liebe1127/HP028_RailTwin/ECAD/README.md

# compact-sensor-module
- First pcb attempt : used [KiCAD](https://www.kicad.org/) 10.0.6
- Based on first prototype sensor module : not extensible. Left gpio pins didn't have interface.
- Already ordered 5 pics on [JLCPCB](https://jlcpcb.com/) (minimum oroder quantity) : **not PCBA**, need soldering by hand after shipping.
- Latest gerber in /output3 folder.
- 3d models, symbols, footprints for certain parts comes from [SnapMagic](https://www.snapeda.com/home/).
