liebe1127/HP028_RailTwin/docs/hardware-digital-twin/README.md

# 디지털 트윈용 하드웨어 묶음

2026-09-25 정리. 다른 채팅에서 화면을 만들 때 이 파일을 먼저 읽는다.

긴 변경 이력은 `docs/hardware-configuration-history.md`에 있다. 그 문서에서 좌우·전진·IMU 화살표를 **미확인**이라고 적은 문장은 이 파일의 확정이 우선이다. 와이파이 비밀번호와 MQTT 비밀번호는 여기 적지 않는다.

그리는 대상은 하부 레일과, 그 위를 가는 대차 하나다. 크레인 거더 처짐을 그리지 않는다. 색은 정상 초록, 주의 노랑, 위험 빨강. 결함 종류는 이음부 단차, 수직 변형, 좌우 높이차이다.

## 실물에서 확정된 방향

2026-09-25에 머리 위 사진으로 확인했다. 그 사진 파일은 폴더에서 빠졌다. 전진 방향은 `photos/assembled/01-forward-is-toward-hand-and-red-boards.jpg`에 남아 있다.

- 그 머리 위 사진의 왼쪽 프레임이 실물 왼쪽이다. 코드의 왼쪽, MQTT `rail-left-01`, I2C `Wire` GPIO 11/12와 같다. 이 쪽에만 아연 레일을 넣었을 때 간격이 6.00 mm로 읽혔다.
- 사진 오른쪽 프레임이 실물 오른쪽이다. `rail-right-01`, `Wire1` GPIO 13/14. 레일이 없을 때 간격 읽기는 약 8 mm(곡선 끝)였다.
- 그 사진에서 바퀴가 있는 위쪽이 전진이다. 빨간 모터 기판 쪽이고, `01`의 손 방향과 같다. 후진은 그 반대다.
- 전진할 때 왼쪽 엔코더 카운트는 증가하고, 오른쪽은 감소한다. 펌웨어는 오른쪽에만 −1을 곱해 위치는 양쪽 다 전진하면 커지게 한다. 거리 크기는 바꾸지 않는다.

## 3D 모델

`model/second-prototype.glb`. Blender glTF 익스포터 5.2.40. 단위는 미터. 화면 좌표는 Y가 위다. 루트 노드가 X축으로 −90도 돌아가 있어, Blender의 Z-위가 glTF의 Y-위로 바뀐 상태다.

| 모델 이름 | glTF 위치 | 의미 |
|---|---|---|
| LeftMainBeam | X = +165 mm, 길이 600 mm (Z 0–600) | 모델이 왼쪽이라고 이름 붙인 세로 보. 30×30 mm |
| RightMainBeam | X = −165 mm, 길이 600 mm | 모델이 오른쪽이라고 이름 붙인 세로 보 |
| MiddleBeam | Z 225–255 mm, X −150–150 mm | 가로 보 30×30 mm |
| DriveWheel / DriveWheel001 | Z ≈ 24 mm, X = +196.5 / −196.5 mm | 구동륜. +X가 모델 왼쪽 보와 같은 쪽 |
| IdleWheel / IdleWheel001 | Z ≈ 570 mm, X = −193 / +193 mm | 아이들 휠. 이름에 001이 없는 쪽이 모델 오른쪽 |
| InductiveSensor / 001 | Z ≈ 270 mm, X = +193 / −193 mm, Y ≈ −61 mm | 거리 센서. 접미 없는 쪽이 모델 왼쪽 |
| 레일 두 개 | 25×25×2 mm, 길이 600 mm, 중심 X = ±193 mm, 중심 Y = −86 mm | 모델 안의 레일 |

전체 상자 크기는 가로 460 mm, 높이 124 mm, 길이 602 mm이다.

축을 실물에 대응하면 이렇게 둔다.

- 모델에서 Z가 작아지는 쪽이 구동륜 끝이다. 실물 전진은 이 구동륜 쪽으로 둔다.
- 모델의 +X(LeftMainBeam)가 실물 왼쪽인지는 사진과 나란히 대조하지 않았다. 노드 이름만으로 좌우 색을 뒤집지 않는다. 실물 왼쪽은 위 사진 규칙이 정본이다.

모델과 실물이 다른 점:

- 센서 메시 이름은 Balluff BES 516이다. 실물은 GTRIC LR18-08U다. M18 유도형 자리 표시로만 본다.
- 모델 레일은 25×25×2 mm, 길이 600 mm, 중심 간격 386 mm다. 2026-09-26 사용자 확인으로 실물 한 개도 길이 60 cm, 바깥 25×25 mm이다. WebGL은 이 메시를 3개 이어 180 cm로 쓴다. 좌우 간격은 아직 줄자 값이 아니므로 모델 간격 386 mm를 현장 값으로 쓰지 않는다.
- 바퀴 경계 상자는 지름 53 mm, 폭 31 mm다. 53 mm는 플랜지 외경에 해당한다. 인수인계 도면의 구름 지름은 47 mm이고, 엔코더 상수 300 mm / 6034카운트도 그 둘레(약 147.7 mm)와 맞다. 출력품 지름은 실측하지 않았다.
- 모터 메시는 좌우가 레일 방향으로 어긋나 있다. 모델 왼쪽 모터는 Z ≈ −78 mm, 모델 오른쪽 모터는 Z ≈ 131 mm다. 실물 사진의 빨간 기판은 양쪽 다 바퀴 끝에 가깝다. 모터 메시 위치를 실물 배치로 단정하지 않는다.
- 모델에는 ESP32, 브레드보드, 전지, 전선이 없다. 전자 배치는 조립 사진을 본다.

## 화면의 위치는 하나

대차 몸통은 하나다. 왼쪽 바퀴 거리와 오른쪽 바퀴 거리를 점 두 개로 그리지 않는다.

서버는 두 위치 차이가 80 mm 이하면 짝으로 보고, 구간 색은 평균 `(왼쪽+오른쪽)/2`에 찍는다. 칸 길이는 50 mm다. 차이가 80 mm를 넘으면 그 샘플은 짝으로 쓰지 않는다.

2026-09-25 BOOT 버튼 7초 전진, 같은 세기 120:

- 줄자로 본 몸통 이동은 약 21 cm
- 왼쪽 바퀴 216.5 mm (카운트 4354)
- 오른쪽 바퀴 191.4 mm (카운트 3849)

왼쪽은 줄자와 맞는다. 오른쪽이 약 2 cm 짧은 것은 레일의 다른 위치가 아니다. 왼쪽 모터가 약 13% 빨라 몸통을 밀었고, 오른쪽 바퀴가 바닥에서 미끄러져 덜 돈 것이다. 코드는 두 모터에 같은 120을 넣고, 펄스당 거리 상수도 하나다. 인수인계의 517 대 455와 같은 비율이다.

같은 날 앞선 5초 주행은 줄자 155 mm, 왼쪽 163.2 mm, 오른쪽 128.6 mm였다. 차이 비율이 주행마다 달라서, 오른쪽만 다른 상수를 쓰는 계산 오류로 설명하지 않는다.

웹 화면의 점은 지금 평균이 아니라 왼쪽 `distance_x`를 먼저 쓴다. `distance_x`는 `position_mm / 10`이라 단위가 cm다.

## 전자 (화면이 알아야 할 것만)

MCU는 ESP32-S3-DevKitC-1 N16R8 한 장이다. `photos/parts/13-esp32-c3-mini.jpg`는 취소된 이전 설계다. 조립 실물이 아니다.

거리 센서는 LR18-08U 좌우 각 1개. 유도형, 0–10 V, 감지 1–8 mm. 파란색 끝이 레일을 본다. 플라스틱·테이프·PLA는 못 본다. 측정 레일은 바닥에 놓은 아연 각파이프다. 은색 프로파일은 대차 프레임이다.

기울기는 MPU-6050 가속도의 중력 방향이다. 자이로는 판정에 쓰지 않는다. 두 기판 다 부품 면이 위, Z는 위를 가리킨다. 인쇄된 X는 레일 방향이 아니라 좌우 방향이고, 양쪽 +X가 차체 왼쪽으로 간다. 그래서 한쪽으로 기울면 두 칩의 가로 가속도 부호가 같다. 정지 중 Z 오프셋은 왼쪽 약 1.07 g, 오른쪽 약 1.00 g이다. 사진은 `02`, `03`.

모터는 JGB37-520 두 개, L298N 두 개. 모터 전지는 좌우 각 18650 세 개(3S)여야 돈다. 두 개만 넣으면 바퀴가 안 돈다. `05`는 두 개만 꽂혀 있던 때다. `01`이 세 개로 주행한 상태다.

보드의 BOOT 버튼을 한 번 누르면 전진 7초 후 정지한다. 가는 중에 다시 누르면 즉시 정지한다. RST는 다시 켜기만 하고 바퀴를 돌리지 않는다. BOOT를 누른 채 RST를 누르면 주행 프로그램이 안 켜진다.

지금 보드에 있는 펌웨어는 `firmware/esp32_s3_rail_node/` 0.6.1-draft다. 결함 판정은 서버 `rail_defect.py`가 한다.

## 아직 재지 않은 것

레일과 바닥의 0 mm 표시, 이음부 위치와 단차 높이, 레일 단면·길이·좌우 간격, 바퀴 지름 실측, 분압 저항 Ω, 전원 전압. 엔코더 상수 `300/6034`는 줄자 결과로 아직 바꾸지 않았다.

## 사진과 영상

조립, 이 폴더 `photos/assembled/`. 빠진 번호 없이 1부터 다시 매겼다.

| 파일 | 내용 |
|---|---|
| 01-forward-is-toward-hand-and-red-boards.jpg | 전진은 손 방향, 빨간 기판 쪽. 모터 전지 3개 |
| 02-imu-physical-left-frame.jpg | 실물 왼쪽 GY-521. 칩 면이 위 |
| 03-imu-physical-right-frame.jpg | 실물 오른쪽 GY-521. +X는 3셀 팩 쪽(차체 안쪽, 차체 왼쪽) |
| 04-lr18-above-zinc-rail.jpg | LR18-08U가 아연 각파이프를 봄. 이 틈은 약 6 mm |
| 05-overhead-two-cells-before-motors-ran.jpg | 모터 전지가 2개뿐일 때. 이 상태로는 바퀴가 안 돈다 |
| 06-end-view-two-white-rollers.jpg | 끝에서 본 두 프레임과 흰 롤러 |
| 07-bogie-on-zinc-square-rails.jpg | 대차가 바닥에 놓은 아연 각파이프 두 줄 위에 올라가 있다 |

부품 낱장 `photos/parts/`는 01–13 그대로다. `13-esp32-c3-mini.jpg`만 현재 MCU가 아니다.

주행 영상은 `video/HP028-주행영상-1차.mp4`다.
