liebe1127/HP028_RailTwin/배준호_전달/레일측정데이터/보정/README.txt

레일측정데이터_보정 — 위치 보정 사본 (2026-09-29)

원본 CSV의 모든 열은 그대로 두고, 아래 열을 뒤에 덧붙였다.

  rail_x_mm            센서가 있는 레일 위 위치 (mm). 이음부 틈이 600, 1200 mm에 오도록 좌 엔코더를 선형 변환한 값.
                       레일은 0~1800 mm, 이음부는 600·1200 mm. 디지털 트윈·분석에는 이 열을 쓴다.
  rear_wheel_x_mm      뒷바퀴(엔코더 0점) 위치 = rail_x_mm - 250
  encoder_scale_left   좌 엔코더 원시값에 곱한 배율 (600 / 이음부 사이 엔코더 값)
  encoder_scale_right  같은 방법으로 구한 우 엔코더 배율 (참고용, 보정에는 안 씀)
  sensor_valid         좌·우 센서 값이 2.5 mm 초과(레일 위)면 1, 레일 끝 등 무효 구간이면 0
  analysis_window      분석에 쓰는 구간이면 1. 12차(좌우 높이차 1회)는 충격 정지 후 재출발 지점부터 1.
  joint_marker         이음부 틈 스파이크로 잡은 행에 600 또는 1200, 나머지 0

보정 방법
  rail_x = 600 + (left_position_mm - E1) * 600 / (E2 - E1)
  E1, E2 = 좌·우 센서 간격의 짧은 양의 스파이크(틈 3 mm)가 최대인 행의 좌 엔코더 값. 회차별 값은 보정_기록.csv.

왜 필요한가
  좌 엔코더는 실제보다 평균 +11 %(회차별 +1~+29 %), 우 엔코더는 평균 -9 % 다르게 셌다(구동륜 미끄러짐·배터리 방전 추정).
  이 보정 없이는 회차 간 위치가 어긋나 정상 기준선 빼기와 평균이 불가능하다.

주의
  이 보정은 사후 처리다. 실시간 서버(pass_analysis.py)는 같은 원리로 주행마다 스스로 보정한다.
  원본 폴더(레일측정데이터)는 수정하지 않았다.
