liebe1127/HP028_RailTwin/docs/2026_스마트해운물류_개발보고서_초안.md

# 2026년 스마트해운물류 우수 프로젝트 개발보고서 — 공식 PDF 삽입 원고

> 기준일: 2026-08-25. 하드웨어는 2026-09-24 인수인계서 기준이다. MCU는 ESP32-S3-DevKitC-1 N16R8 1장이다. 결함 진단 계약은 2026-09 배용진 확정안 v2로 바뀌었다.  
> 이 초안 본문에 남은 RBF, CREST, Godot, “종류 보류”, 단차·침하·뒤틀림 한 묶음 서술은 그 계약과 어긋나면 따르지 않는다. 현재 판정은 `rail_defect.py`의 이음부 단차 / 수직 변형 / 좌우 높이차와 정상·주의·위험이다.
> 용도: `/Users/junho2026/Downloads/해운물류 개발보고서.pdf`의 각 칸에 옮겨 넣기 위한 작업 원고  
> 작성 기준: `development-report-template-map.md`, `notion-project-context.md`, `hardware-configuration-history.md`  
> II. 작품 내용: **최종 목표 시스템**을 기준으로 작성한다. 현재 진척도는 기능 목록의 `현재진척도(%)`, `6. 향후 개선사항`, `III. 프로젝트 수행 내용`에만 구분한다.

## PDF 1쪽 — 표지

- 프로젝트 구분 번호: `26.[확인 필요]`
- 프로젝트명(국문): **가변 계측–레일 변형 디지털 트윈 기반 갠트리 크레인 예측 안전관리 시스템**
- 프로젝트명(영문): **Rail Deformation Prediction for Gantry Crane Digital Twin Safety Management**
- 작품명: **HP028 RailTwin(레일트윈)**
- 팀명: `[확인 필요: 승인 팀명]`
- 공공데이터 활용 여부: **미활용** `[최종 확인 필요]`

## PDF 2쪽 — 작품 개요 (반드시 1쪽)

### 작품 정보

| 공식 항목 | 삽입 원고 |
|---|---|
| 프로젝트명(국문) | 가변 계측–레일 변형 디지털 트윈 기반 갠트리 크레인 예측 안전관리 시스템 |
| 작품명 | HP028 RailTwin(레일트윈) |
| 작품 소개 | 본 작품은 대형 갠트리 크레인이 하부 주행 레일을 따라 이동할 때 발생하는 동적 가속도·자이로·거리·위치 데이터를 수집하고, 특징 공학과 AI 모델을 이용해 레일의 단차·국부 침하·뒤틀림 징후를 예측·감지하는 디지털 트윈 안전관리 시스템이다. 분석 결과는 주행 위치와 함께 웹 대시보드와 Godot 3D 화면에 실시간으로 표시한다. |
| 작품의 개발배경 및 필요성 | 반복 하중과 주변 환경에 노출되는 주행 레일의 기하 이상은 충격·진동 증가와 주행 안정성 저하로 이어질 수 있다. 정기·육안 점검만으로는 운행 중에만 나타나는 동적 이상을 놓치기 쉬우므로, 주행 중 데이터를 지속적으로 수집하고 이상 가능성이 높은 좌·우 레일 구간을 우선 점검 대상으로 제시하는 데이터 기반 관리가 필요하다. |
| 작품의 특장점 | ① 좌·우 레일 독립 계측과 위치 기반 위험도 결합 ② 원시값이 아닌 웨이블릿 디노이징·파고율 등 특징 공학 후 AI 추론 ③ 비동기 수집·저장·전송 파이프라인 ④ 웹·3D 디지털 트윈의 구간별 색상 시각화 ⑤ 센서 미연결 시에도 동일 데이터 계약으로 시연·점검이 가능한 대체 스트림 |
| 작품 기능 | ESP32-S3-DevKitC-1 1장이 좌·우 MPU-6050·GTRIC LR18-08U·내장 엔코더 데이터를 수집한다. FastAPI가 스키마 검증, 특징 추출, RBF 레일 변형 추론, InfluxDB 저장, WebSocket 방송을 수행하고, 웹 대시보드와 Godot 디지털 트윈이 좌·우 CREST·PRED_RAIL_DEFORM·rail_risk를 실시간 표시한다. |
| 작품의 기대효과 및 활용분야 | 위험 가능 구간의 신속한 특정, 점검 우선순위 수립, 상태 기반 유지보수 데이터 축적을 지원한다. 항만·조선소·제철소·물류창고의 대형 레일 주행 설비와 스마트항만 교육용 디지털 트윈에 확장할 수 있다. |

## PDF 3쪽 — 작품 구성도 (반드시 1쪽)

### 삽입 그림

- 그림 파일: `docs/system-architecture-flowchart.png`
- 그림 제목: **RailTwin 센서–AI–디지털 트윈 통합 구성도**
- 보조 그림(본문 II장에서 사용): `docs/hw-architecture-flowchart.png`, `docs/sw-architecture-flowchart.png`, `docs/signal-processing-pipeline-flowchart.png`

그림 안의 최종 목표 흐름:

**센서 노드 1장(ESP32-S3-DevKitC-1 + 좌·우 MPU-6050 + ADS1115 + GTRIC LR18-08U + 내장 엔코더)**  
→ **Wi-Fi MQTT QoS 1**  
→ **Mosquitto → FastAPI 스키마 검증·Queue·Consumer**  
→ **롤링 윈도우 · sym3 웨이블릿 디노이징 · 파고율 등 9개 특징 추출**  
→ **PyTorch RBF 레일 변형 추론(`pred_rail_deform`)**  
→ **InfluxDB 저장 + WebSocket 방송**  
→ **웹 대시보드 + Godot 3D 위치·구간 위험도 시각화**

### 그림 하단 설명

위 구성도는 대차의 ESP32-S3 한 장이 좌·우 레일을 함께 계측하고, 서버에서 특징 공학과 AI 추론을 수행한 뒤 웹·3D 화면에 위치 기반 위험도를 표시하는 전체 흐름을 나타낸다. GTRIC LR18-08U의 0–10V 출력은 20kΩ/10kΩ 분압을 거쳐 ADS1115로 들어가며, 엔코더 위치는 센서 샘플과 결합되어 레일 구간 위험도 매핑에 사용된다.

---

# 본문

## PDF 4쪽 — I. 작품 개요

### 1. 작품 소개

#### 기획 의도

- 갠트리 크레인 운행 과정에서 생성되는 동적 센서 데이터를 활용하여 하부 주행 레일의 단차·국부 침하·뒤틀림 징후를 조기에 파악한다.
- 센서 계측, 특징 공학, AI 추론, 시계열 저장, 실시간 시각화를 하나의 파이프라인으로 연결한다.
- 위험도와 거리 좌표를 함께 제공하여 유지보수 담당자가 우선 점검할 좌·우 레일 구간을 특정하도록 돕는다.

#### 작품 내용

- 대차에 ESP32-S3-DevKitC-1 1장을 두고, 좌·우 각 MPU-6050으로 가속도와 기울기를, GTRIC LR18-08U로 금속 레일과의 간격 변화를, JGB37-520 내장 엔코더로 주행 위치를 계측한다. 브링업 펌웨어는 자이로를 읽지 않는다.
- 엣지 노드는 정지 상태의 미세 노이즈를 억제한 뒤 10샘플 JSON 배치를 Wi-Fi MQTT QoS 1로 서버에 전송한다.
- FastAPI 서버는 수신 데이터를 검증하고, 롤링 윈도우·웨이블릿 디노이징·파고율 등 특징 공학을 거쳐 PyTorch RBF 대리 모델로 레일 변형 지표(`pred_rail_deform`)를 추론한다.
- 추론 결과와 구간별 위험도(`rail_risk`)는 InfluxDB에 저장되고, WebSocket을 통해 웹 대시보드와 Godot 3D 디지털 트윈에 실시간 전달된다.

#### 작품 정의

- RailTwin은 관성·거리·위치 계측 모듈, FastAPI 실시간 서버, 특징 공학 기반 RBF 대리 모델, InfluxDB, 웹 대시보드와 Godot 3D 화면으로 구성된 레일 상태 모니터링 시스템이다.
- 핵심 예측 대상은 하부 주행 레일의 단차·국부 침하·뒤틀림 등 기하 이상이다. 상부 거더 구조의 변형은 본 작품의 예측 대상이 아니다.
- 원시 센서값은 모델에 직접 입력하지 않으며, 디노이징과 충격·거리 변화 특징을 추출한 뒤 추론한다.

### 2. 작품의 개발 배경 및 필요성

#### 1) 주행 레일 기하 이상에 따른 안전관리 필요

- 대형 갠트리 크레인의 하부 주행 레일은 반복 주행 하중과 주변 환경의 영향을 지속적으로 받는다.
- 국부적인 단차·침하·뒤틀림은 바퀴 충격과 진동을 증가시키고, 장기적으로 주행 안정성과 유지보수 부담에 영향을 줄 수 있다.
- 이상이 특정 구간에 집중되는 경우에도 육안 점검만으로는 발생 위치를 빠르게 좁히기 어렵다.

#### 2) 정기·육안 점검 방식의 한계 보완

- 정기 점검과 육안 확인은 점검 주기 사이에 발생하거나 운행 중에만 나타나는 동적 이상을 놓칠 수 있다.
- 정지 상태에서 측정한 정적 간격만으로는 주행 충격과 순간 피크를 충분히 포착하기 어렵다.
- 따라서 운행 중 가속도·자이로·거리·위치를 함께 수집하고, 이상 가능성이 높은 구간을 디지털 트윈에 표시하는 상시 모니터링이 필요하다.

### 3. 작품의 특징 및 장점 / 국내·외 기술 현황 및 본 프로젝트의 차별성

#### 1) 국내·외 기술 현황

- 산업 설비 분야에서는 진동 센서와 시계열 분석을 이용한 상태 감시·예지보전 기술이 활용되고 있다.
- 디지털 트윈은 실물 설비의 센서 데이터를 가상 모델과 연결하여 상태와 위치를 직관적으로 표현하는 방향으로 발전하고 있다.
- 항만 크레인 안전관리의 상당수는 정기 점검, 육안 확인, 고정형 계측에 의존하며, 주행 중 좌·우 레일 이상을 위치 단위로 제시하는 축소 모형 종단 시스템은 제한적이다.
- 관련 논문·특허·상용 제품과의 정량 비교 및 출처: `[확인 필요: 팀 선행기술 조사 결과]`

#### 2) 작품의 특징 및 장점(차별성)

- **운행 중 다채널 계측:** 별도 정지 점검뿐 아니라 주행 중 동적 가속도·자이로·레일 간격·엔코더 위치를 좌·우 독립 노드에서 동시에 다룬다.
- **특징 공학 기반 분석:** 원시 파형을 AI에 바로 넣지 않고, 웨이블릿 디노이징으로 고주파 노이즈를 완화한 뒤 파고율·RMS·거리 변화 등 해석 가능한 특징을 추출한다.
- **위치 기반 위험도:** 엔코더 거리값을 레일 구간 인덱스로 변환하여 좌·우 레일의 누적 위험도를 파랑–초록–노랑–빨강 색상으로 표시한다.
- **장애 격리형 파이프라인:** 센서 미연결, 스키마 오류, DB 저장 실패, WebSocket 종료가 전체 시연을 즉시 중단시키지 않도록 수집·추론·저장·방송을 분리한다.
- **좌·우 동시 계측:** ESP32-S3 한 장의 I2C 두 버스가 좌·우 간격·가속도·엔코더를 같은 주행에서 읽는다. 저장소의 MQTT 계약은 아직 `device_id`·`rail_side`로 스트림을 나눈다.

## PDF 5~8쪽 — II. 작품 내용

> 본 장은 최종 목표 시스템을 기준으로 작성한다. 현재 구현 진척은 `4. 작품 구성 기능`의 진척도 열과 `6. 향후 개선사항`에서 구분한다.

### 1. 목표 시스템 구성도

#### 1) 예상결과물

**HW 결과물**

- ESP32-S3-DevKitC-1 N16R8 1장. 좌·우 I2C 버스에 MPU-6050, ADS1115, GTRIC LR18-08U를 각 1개
- 20kΩ/10kΩ 분압, JGB37-520 내장 엔코더, L298N 2개, MT3608 2개, 18650 9개
- 알루미늄 프로파일 대차 위에 브레드보드·전지를 올린 하부 구동부. 구동륜 도면은 답면 47mm, 플랜지 외경 53mm
- 측정 레일은 바닥에 놓은 아연 각파이프. 길이·단면·간격은 `[확인 필요]`
- 이음부 단차는 절단 오차의 실측. 수직 변형 경사판과 한쪽 높임 판의 제작 여부는 `[확인 필요]`

**SW 결과물**

- 조립 실물 브링업은 저장소 밖 `RailTwin_BringUp.ino` (USB 시리얼). 저장소 `firmware/esp32_c3_rail_sensor/`는 이전 C3 두 노드용 MQTT 펌웨어
- FastAPI 기반 비동기 수집·스키마 검증·처리 서버
- 웨이블릿 디노이징·파고율 등 9개 특징 추출 모듈
- PyTorch RBF 레일 변형 위험 추론 모델
- InfluxDB 시계열 저장 및 WebSocket 실시간 전송 기능
- 좌·우 레일 상태를 표시하는 실시간 웹 대시보드
- Godot 기반 크레인 위치·좌우 레일 위험도 디지털 트윈
- 센서 미연결 환경에서 동일 데이터 계약으로 파이프라인을 점검하는 더미 스트리머
- Docker Compose 기반 상시 운영 구성

#### 2) SW/HW구성도(또는 서비스흐름도)

삽입 그림: `docs/system-architecture-flowchart.png`, `docs/hw-architecture-flowchart.png`, `docs/sw-architecture-flowchart.png`

위 구성도는 낙상 감지형 단일이 아니라, 좌·우 레일 계측부, 이벤트 통신부, 특징 공학·AI 추론부, 저장·전송부, 웹·3D 시각화부가 연동되는 전체 시스템 구조를 나타낸다.

1. **계측:** 좌·우 MPU-6050이 가속도를 읽고, GTRIC LR18-08U가 금속 레일과의 1–8mm 간격 변화를 0–10V로 출력한다. JGB37-520 내장 엔코더는 A상 상승 에지로 주행 위치를 센다. 브링업은 자이로를 읽지 않고, 센서 2개와 MPU 2개를 한 바퀴 도는 데 20ms가 넘는다.
2. **변환·엣지 처리:** 20kΩ/10kΩ 분압을 거친 값을 ADS1115가 AIN0 단발 변환(128SPS, ±4.096V)으로 읽는다. 100nF는 미장착이다.
3. **전송:** 조립 브링업은 USB 시리얼이다. 배터리 주행 중에는 내부 메모리에 두고 연결 후 `p`로 본다. 저장소의 이전 계약은 `rail-left-01` / `rail-right-01`가 Wi-Fi MQTT QoS 1로 `telemetry`를 발행하는 형태이며, 이 S3 보드에 올라가 있지 않다.
4. **실시간 처리:** FastAPI가 Mosquitto를 구독하고 스키마 검증 후 비동기 Queue–Consumer로 특징 추출·추론·저장·방송을 수행한다.
5. **특징 공학·AI:** 32샘플 롤링 윈도우에 sym3 웨이블릿 디노이징을 적용하고, 가속도·자이로·거리·속도 특징 9개를 정규화하여 RBF 모델에 입력한다.
6. **저장·전송·시각화:** `PRED_RAIL_DEFORM`, `CREST`, 구간별 `rail_risk`를 InfluxDB와 WebSocket으로 전달한다. 웹은 데이터·모델·서버 상태를, Godot는 `distance_x`와 좌·우 레일 색상을 갱신한다.

### 2. 주요 적용 기술

#### 1) 한 보드의 좌·우 계측

본 작품의 하드웨어는 ESP32-S3-DevKitC-1 N16R8 1장이 좌·우를 함께 본다. 좌 버스는 GPIO11/12(`Wire`), 우 버스는 GPIO13/14(`Wire1`)이다. 각 버스에 MPU-6050(0x68)과 ADS1115(0x48)가 있다. 엔코더는 좌 A/B가 GPIO15/16, 우 A/B가 GPIO17/18이다. 모터 PWM·방향은 좌 GPIO4/5/6, 우 GPIO7/8/9이다.

GTRIC LR18-08U는 금속 레일과 센서 사이 간격을 연속 전압으로 읽는다. 2026-08-23 몸체 라벨은 DC 15–30V, 0–10V, 1–8mm, 갈색(+), 청색(−), 흑색(출력)이다. 0–10V는 20kΩ/10kΩ으로 나눠 AIN0에 넣는다. 센서 전원은 18650 1셀을 MT3608로 올려 24V를 목표로 한다. 로직 1셀은 USB-C, 모터는 좌·우 각 18650 3S이며 접지만 공통이다. 저항 Ω과 전원 전압의 멀티미터 기록은 미확인이다.

브링업의 거리 교정은 0/2/4/6/8mm에서 좌 −0.010/0.187/2.044/5.725/7.592V, 우 0.004/0.242/2.935/6.546/8.210V이다. 설치 목표는 5.00mm이다. 엔코더는 A상 상승 에지이고 잠정 환산은 약 0.0497mm/카운트이다. 가속도는 ±2g이다.

취소된 초기 프로토타입(ESP32-S3-WROOM-1 + ADXL345 + HC-SR04)은 초기 수집 검증에만 사용하였다. 현재 보드와 센서가 다르므로 최종 구성에 넣지 않는다. ESP32-C3 Mini 두 장과 100Hz/20Hz MQTT 배치는 저장소에 남은 이전 펌웨어이다.

#### 2) 엔코더 기반 위치 정합

삽입 그림: `docs/encoder-position-sync-flowchart.png`

레일 이상을 위치 단위로 표시하려면 센서값과 주행 좌표를 같은 시각에 결합해야 한다. 본 작품의 브링업은 JGB37-520 내장 엔코더의 A상 상승 에지를 세고, 구동륜 답면 지름 47mm(둘레 147.7mm, 플랜지 외경 53mm)로 환산한다. 잠정값은 약 0.0497mm/카운트, 바퀴 1회전 약 2970카운트이다. 출력품 지름 실측과 레일 위 0mm는 미확인이다.

```
position_mm = zero_point + N_pulse × direction × (π × D_wheel) / N_ppr
distance_x(cm) = position_mm / 10
```

전진(IN1=HIGH, IN2=LOW)에서 좌 카운트는 증가하고 우 카운트는 감소한다. 같은 PWM에서 좌가 약 13% 빨라 `syncDrive()`로 맞춘다. 진행 방향의 실제 좌·우와 어느 쪽이 전진인지는 미확인이다. 서버는 위치를 레일 길이로 나누어 구간 인덱스를 계산하고, 해당 구간의 `rail_risk`를 갱신한다. 웹과 Godot는 `distance_x`로 크레인 위치를 이동시키므로, 센서 충격 시점과 화면상 위치가 대응된다.

#### 3) MQTT 기반 실시간 업링크와 스키마 검증

센서 업링크는 장치별 인증을 사용하는 MQTT QoS 1 구조이다. 텔레메트리 토픽은 `rail/v1/nodes/{device_id}/telemetry`, 상태 토픽은 `rail/v1/nodes/{device_id}/status`이다. 왼쪽 노드는 `device_id=rail-left-01`, `rail_side=left`, 오른쪽 노드는 `device_id=rail-right-01`, `rail_side=right`를 사용하며 MQTT username은 `device_id`와 같다.

배치 메시지는 `schema_version`, `boot_id`, `batch_seq`, `sample_seq`, `uptime_us`, `position_mm`, `sensor_distance_mm`, `adc_raw`, `adc_voltage_v`, `sensor_voltage_v`, `accel_mps2`, `gyro_radps`를 포함한다. `boot_id`는 재부팅 후 순번이 초기화된 새 스트림을 구분하고, FastAPI는 동일 부팅 스트림에서 중복 `batch_seq`를 폐기한다. 운영 환경에서는 TLS(MQTTS)와 도메인 인증서를 적용하여 전송 구간을 보호하는 것을 목표로 한다.

FastAPI는 `railtwin-backend` 계정으로 구독만 수행한다. Producer는 수신 메시지를 비동기 Queue에 적재하고, Queue가 포화되면 오래된 데이터를 제거해 최신 상태 처리를 우선한다. 필드 단위 파싱 오류, InfluxDB 저장 실패, 종료된 WebSocket 연결은 서로 격리하여 한 경로의 장애가 전체 파이프라인을 중단시키지 않도록 한다.

#### 4) 웨이블릿 디노이징과 파고율 특징 공학

삽입 그림: `docs/signal-processing-pipeline-flowchart.png`

원시 센서값을 모델에 바로 입력하면 전원 리플, 정지 미세 진동, 순간 충격이 혼재되어 단차 충격을 안정적으로 구분하기 어렵다. 본 작품은 좌·우 각각 32샘플 롤링 윈도우를 구성한 뒤, 가속도는 중력 크기를 제거한 동적 진폭으로 변환한다.

```
a_dyn = |√(a_x² + a_y² + a_z²) − g|
```

윈도우 신호는 sym3 웨이블릿으로 최대 3단 분해하고, 상세 계수에 soft-thresholding을 적용한다.

```
σ = median(|d_J|) / 0.6745
λ = σ √(2 ln N)
```

복원된 신호에서 다음 9개 특징을 추출한다.

| 특징 | 의미 |
|---|---|
| `accel_rms` | 디노이징 가속도의 RMS |
| `accel_peak_to_peak` | 가속도 최대–최소 폭 |
| `crest_factor` | 파고율. `max(\|x\|) / RMS(x)` |
| `gyro_rms` | 디노이징 자이로 RMS |
| `gyro_peak` | 자이로 절댓값 최댓값 |
| `distance_mean_mm` | LR18 거리 평균 |
| `distance_delta_mm` | 최근 거리와 기준선(중앙값)의 편차 |
| `distance_std_mm` | 거리 표준편차 |
| `speed_mm_s` | 엔코더 위치 변화율 |

파고율은 지속 진동보다 순간 피크에 민감하므로 단차 충격 특징을 강조한다. 거리 편차와 표준편차는 국부 침하·뒤틀림에 따른 간격 변화를 반영한다. 이와 같이 AI 모델의 입력은 물리적으로 해석 가능한 특징으로 구성한다.

#### 5) PyTorch RBF 대리 모델 기반 레일 변형 추론

삽입 그림(합성 데이터): `docs/rbf-synthetic-training-evidence.png`, `docs/rbf-synthetic-feature-comparison.png`, `docs/rbf-synthetic-training-log.png`

레일 변형 지표는 단일 임계값으로 단정하지 않고, 비선형 특징 공간에서 위험 정도를 연속값으로 추정한다. 본 작품은 학습 가능한 가우시안 RBF 중심 64개와 선형 출력층으로 구성된 대리 모델을 사용한다.

```
φ_j(x) = exp( −∥x − c_j∥² / (2 σ_j²) )
ŷ = Σ_j w_j φ_j(x) + b
```

여기서 `x`는 정규화된 9차원 특징 벡터, `ŷ`는 `pred_rail_deform`이다. 서버의 `predict_rail_deform()`은 특징 추출 후 RBF 추론을 수행하고, 실패 시에도 파고율은 별도로 유지하여 화면 표시가 중단되지 않도록 한다.

최종 목표에서는 정상 주행, 단차, 국부 침하, 뒤틀림을 재현한 반복 주행 데이터를 라벨링하여 모델을 학습·평가한다. 평가 지표는 MAE, RMSE, 재현율, 오탐률, 추론 지연시간을 사용한다. 합성 데이터 학습 파이프라인은 인터페이스와 데이터 흐름을 먼저 고정하기 위한 사전 단계이며, 실측 라벨 확보 후 동일 특징 구조로 재학습한다. 현재 수록 그림은 합성 1500샘플·200 epoch 학습 결과이며, 합성 내부 적합값(val_loss 0.017, MAE 0.090)을 실측 정확도로 해석하지 않는다.

#### 6) 위치 기반 위험도 정규화와 디지털 트윈

서버는 파고율과 예측값을 0~1 위험도로 정규화하고, 둘 다 있으면 큰 쪽을 해당 시점의 위험도로 사용한다.

```
r_crest = clip( (CREST − 1.5) / (5.0 − 1.5), 0, 1 )
r_pred  = clip( PRED_RAIL_DEFORM / 5.0, 0, 1 )
risk    = max(r_crest, r_pred)
```

레일은 길이 `rail_length_cm`를 `segment_count`개 구간으로 나누며, 기본 시연 구성은 1m 레일 20구간이다. 크레인이 지나간 구간의 `rail_risk`는 최댓값을 누적하여, 한 번의 충격이 화면에서 사라지지 않고 우선 점검 구간으로 남도록 한다. WebSocket 페이로드는 좌·우 객체로 분리하여 `CREST`, `PRED_RAIL_DEFORM`, `distance_x`, `rail_risk`, 장치 상태, 특징값을 전달한다.

Godot 디지털 트윈은 `distance_x`로 크레인 위치를 보간 이동시키고, 각 레일 구간을 정상에서 위험으로 갈수록 파랑–초록–노랑–빨강 계열로 갱신한다. 웹 대시보드는 브라우저 접속 후 `/ws`로 실시간 푸시를 받고 `/health`로 서버 상태를 조회한다. 화면은 좌·우 CREST·PRED 패널, 가속도·거리값, WebSocket 연결 상태, 마지막 수신 시각, `rail_risk` 히트맵, 이벤트 로그·노드 배지로 구성한다.

참조 대상은 부산 신항 HD현대삼호 RMG 계열 갠트리 크레인이며, 디지털 시각화용 상용 3D 모델과 물리 제작용 평판·구동부 모델은 목적과 스케일을 구분해 사용한다. 상용 자산은 라이선스 제한에 따라 공개 저장소에 포함하지 않는다.

#### 7) 더미 스트리머와 상시 운영 구성

센서 미연결, 현장 이동, 담당 영역별 병렬 개발을 위해 서버는 동일 WebSocket 계약을 사용하는 더미 스트리머를 제공한다. 더미 모드는 약 1m 레일을 왕복하며 40~50cm 구간에 단차 충격을 모사한다. 이 경로는 백엔드·AI·화면의 데이터 흐름을 점검하기 위한 기능이며, 실측 정확도 근거로 사용하지 않는다.

운영 구성은 Docker Compose로 FastAPI와 InfluxDB를 기동하고 `restart: unless-stopped`로 상시 재기동한다. 웹 대시보드와 Godot는 운영 WebSocket에 접속하여 동일한 좌·우 페이로드를 수신한다.

### 3. 작품 개발 환경

| 구분 | 공식 세부항목 | 삽입 원고 |
|---|---|---|
| SW 개발환경 | OS | 개발: macOS / 서버: Linux 계열 `[실제 운영 버전 확인 필요]` |
| SW 개발환경 | 개발환경(IDE) | Cursor·Visual Studio Code, Arduino IDE, Godot Editor, Blender |
| SW 개발환경 | 개발도구 | FastAPI, Uvicorn, asyncio, PyTorch, NumPy, PyWavelets, InfluxDB Client, MQTT, WebSockets, Docker Compose, Git |
| SW 개발환경 | 개발언어 | Python, C/C++(Arduino), GDScript, HTML·CSS·JavaScript |
| SW 개발환경 | 기타사항 | 좌·우 MQTT 데이터 계약, 특징 공학·RBF 학습 스크립트, 센서 미연결용 더미 스트리머 포함 |
| HW 구성장비 | 디바이스 | ESP32-S3-DevKitC-1 N16R8 1대, 18650 9개, MT3608 2개, JGB37-520 2개, L298N 2개, 알루미늄 프로파일 대차 |
| HW 구성장비 | 센서 | MPU-6050 2개, ADS1115 2개, GTRIC LR18-08U 2개, JGB37-520 내장 엔코더 |
| HW 구성장비 | 통신 | I2C 두 버스, 엔코더 인터럽트. 브링업은 USB 시리얼. 저장소 MQTT 계약은 이전 C3 펌웨어용 |
| HW 구성장비 | 언어 | C/C++(Arduino) |
| HW 구성장비 | 기타사항 | LR18-08U 라벨 DC 15–30V·0–10V·1–8mm. 분압 20k/10k. 센서 전원 목표 24V. 측정 레일은 아연 각파이프 |
| 프로젝트 관리환경 | 형상관리 | Git·GitHub를 이용한 소프트웨어 코드 공유와 변경 이력 관리 |
| 프로젝트 관리환경 | 의사소통관리 | Notion 작업 공유·기록, GitHub 코드 공유, 2주 1회 팀 회의 |
| 프로젝트 관리환경 | 기타사항 | 공통 JSON 계약과 더미 스트림으로 하드웨어 미접속 상태에서도 병렬 개발 |

### 4. 작품 구성 기능

#### 1) 주요 기능 목록

> 기능·설명은 최종 목표 기준이다. `현재진척도(%)`만 2026-08-23 팀 자체 판단값이다. 100%는 코드 구현 진척이며 실측·운영 검증 완료를 뜻하지 않는다.

| 구분 | 기능 | 설명 | 현재진척도(%) |
|---|---|---|---|
| SW | 비동기 데이터 수집·처리 | MQTT 구독, 스키마 검증, Producer–Queue–Consumer, 중복 배치 제거, 오류 격리 | 100% |
| SW | 특징 공학·RBF 추론 | 32샘플 윈도우, sym3 디노이징, 9개 특징 추출, RBF `pred_rail_deform` 추론 및 실측 재학습 | 50% |
| SW | InfluxDB·WebSocket | 시계열 저장, 좌·우 WebSocket 방송, 운영 WSS 연결 | 100% |
| SW | 웹 대시보드 | 좌·우 CREST·PRED, 히트맵, 연결 상태, 이벤트 로그·노드 배지 실시간 표시 | 80% |
| SW | Godot 디지털 트윈 | `distance_x` 위치 이동, 좌·우 `rail_risk` 색상 갱신, 상용/축소 모형 시각화 | 70% |
| HW | 현재 센서 모듈 | ESP32-S3 1장의 좌·우 IMU·거리·엔코더, 20k/10k 분압, 브링업 시리얼. MQTT는 이전 C3 펌웨어 | 80% |
| HW | 구동부·축소 모형 | 3D 외피 수납, 모터 주행, 전체 모형 조립, 단차·침하·뒤틀림 시험 구간 반복 주행 | 80% |

> 100% 미만 항목의 완성 가능 시점: 2차 평가 제출일(2026-09-30)까지 반복 주행·실측 저장·모델 재학습·종단 연동을 완료하는 것을 목표로 한다. `[세부 일정 확인 필요]`

#### 2) SW 개발 기능 상세내용

> 설명란은 주요 목표 대비 현재 개발 정도이다. 기능명은 주요 기능 목록과 동일하다.

| 기능 | 설명 | 작품실물사진 |
|---|---|---|
| 비동기 데이터 수집·처리 | **주요 목표:** 센서가 보낸 배치를 검증·정규화하고, 파싱 오류·저장 실패·연결 종료가 전체 파이프라인을 중단시키지 않도록 비동기 처리한다. **현재(100%):** FastAPI가 `rail/v1/nodes/+/telemetry`·`status`를 구독하고 `schema_version`, `device_id`, `rail_side`, `boot_id`, 순번 단조성을 검증한다. Producer–Queue–Consumer, 중복 `batch_seq` 제거, 제한 Queue, 센서 미연결 시 동일 계약의 더미 스트리머가 구현되어 있다. 단위 시험으로 MQTT 수신·좌우 분기·재부팅 스트림 구분을 확인하였다. **남은 검증:** 조립된 ESP32-S3가 이 계약으로 장시간 발행하는 종단 수신 로그. 브링업은 아직 USB 시리얼이다. | `[삽입: FastAPI /health 응답·MQTT 수신 로그]` |
| 특징 공학·RBF 추론 | **주요 목표:** 원시값이 아니라 32샘플 윈도우·sym3 디노이징·9개 특징으로 레일 변형 지표를 추론하고, 정상·단차·침하·뒤틀림 실측 라벨로 재학습·정량 평가한다. **현재(50%):** 동적 가속도, 자이로, LR18 거리, 엔코더 속도로부터 9개 특징을 추출하고 `predict_rail_deform()`이 RBF 출력을 반환한다. 합성 1,500샘플·64중심·200 epoch 학습 파이프라인과 가중치 로드가 동작한다. 합성 내부 적합값(val_loss 0.017, MAE 0.090)은 파이프라인 검증용이며 실측 정확도가 아니다. **남은 작업:** 반복 주행 라벨 수집 후 재학습, MAE·RMSE·재현율·오탐률·지연시간 평가. 완성 목표 시점 2026-09-30. | **합성 데이터** (실측 정확도 증거가 아님). 우선: `docs/rbf-synthetic-training-evidence.png`. 보충: `docs/rbf-synthetic-feature-comparison.png`, `docs/rbf-synthetic-training-log.png`, `docs/rbf-synthetic-loss-curve.png`. |
| InfluxDB·WebSocket | **주요 목표:** 특징·예측값·구간 위험도를 시계열로 저장하고, 웹·Godot에 좌·우 JSON을 실시간 방송한다. 운영 화면은 WSS를 사용한다. **현재(100%):** InfluxDB Point 기록, `/ws` 다중 클라이언트 방송, 좌·우 `CREST`·`PRED_RAIL_DEFORM`·`distance_x`·`rail_risk` 페이로드가 구현되어 있다. 운영 주소 `wss://223.130.128.198:8000/ws`를 문서화하였다. **남은 검증:** 외부 InfluxDB 장기 저장과 운영 WSS의 실제 접속 성공을 시험 로그로 재확인. 100%는 코드 구현 진척이며 장기 운영 검증 완료를 뜻하지 않는다. | `[삽입: InfluxDB 조회 화면·WebSocket 페이로드]` |
| 웹 대시보드 | **주요 목표:** 브라우저에서 좌·우 센서·특징·예측·히트맵·연결 상태를 한 화면에서 확인하고, 점검 담당자가 우선 구간을 식별할 수 있게 한다. **현재(80%):** `/dashboard`에서 `/ws` 수신, 좌·우 CREST·PRED·가속도·거리 패널, `rail_risk` 히트맵, 연결 상태·마지막 수신 시각, 이벤트 로그·노드 배지, 위험도 리셋이 동작한다. 더미 스트림과 서버 상태 조회로 화면 흐름을 확인하였다. **남은 작업:** 실물 좌·우 동시 수신 화면 정리, 최종 UI 다듬기, 정상·위험 구간 실행 캡처. 완성 목표 시점 2026-09-30. | `[삽입: 정상 구간·위험 구간 대시보드 캡처]` |
| Godot 디지털 트윈 | **주요 목표:** `distance_x`로 크레인 위치를 이동시키고 좌·우 레일 구간을 파랑–초록–노랑–빨강으로 갱신하여, 웹과 동일한 위험 위치를 3D로 공유한다. **현재(70%):** Godot 4.7용 `rail_twin_websocket.gd`가 WSS 접속, 좌·우 페이로드 파싱, 위치 보간, 세그먼트 자동 생성·색상 갱신, 재접속을 처리한다. 저장소에는 연동 스크립트가 있고 최종 `.tscn`·상용 3D 자산은 라이선스상 별도 프로젝트에서 결합한다. **남은 작업:** 최종 씬·자산 결합, 운영 WSS 실연동 화면 증빙. 완성 목표 시점 2026-09-30. | `[삽입: Godot 실행 화면 및 WSS 연결 로그]` |

#### 3) HW 개발 기능 상세내용

하드웨어는 화살표 순서의 단일이 아니라, **센서·전원·모터·바퀴·외피가 한쪽 주행 구동부로 모이고**, 같은 구성이 좌·우 레일에 한 세트씩 붙는 구조다. 아래 표는 주요 기능 목록의 HW 기능명과 동일하다. 이어서 부품 실물 사진을 역할별로 배치한다.

| 기능/부품 | 설명 | 작품실물사진 |
|---|---|---|
| 현재 센서 모듈 | **주요 목표:** ESP32-S3 1장이 좌·우 IMU·유도형 간격·엔코더를 같은 주행에서 읽는다. **현재(80%, 2026-08-23 팀 자체 수치):** 2026-09-24 실물은 DevKitC-1 N16R8, MPU-6050 2개, ADS1115 2개, LR18-08U 2개, 18650 9개, MT3608 2개로 조립되었다. 분압은 20 kΩ / 10 kΩ이다. 거리 교정표와 I2C·금속 반응·30cm 주행을 브링업에서 확인했다. **남은 작업:** 저항 Ω·전원 전압 실측, 레일 0mm, S3에서 서버 MQTT 전송. | 아래 부품 사진. `13-esp32-c3-mini.jpg`는 이전 부품 사진이다 |
| 구동부·축소 모형 | **주요 목표:** 대차가 아연 각파이프 레일을 주행하며 이음부 단차·수직 변형·좌우 높이차 구간을 지난다. **현재(80%):** 알루미늄 프로파일 대차, JGB37-520(12 V, 37 RPM, 엔코더 내장), 답면 47 mm·플랜지 외경 53 mm, L298N 2개. 레일은 고정하지 않은 아연 각파이프이고 이음부는 3D 연결부 3개와 테이프이다. **남은 작업:** 이음부 위치·높이 실측, 반복 주행. | 2026-09-25 대차 사진. 레일 전체는 `[공란]` |

**부품 실물 — 센서·전원 (한쪽 노드를 이루는 역할)**

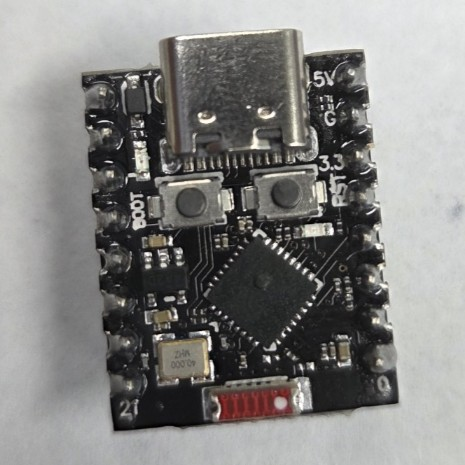
[picture p2: docs/hardware-photos/13-esp32-c3-mini.jpg]
ESP32-C3 Mini


그림. ESP32-C3 Mini 부품 사진. 2026-08 이전 설계의 모듈이다. 2026-09-24 조립 MCU는 ESP32-S3-DevKitC-1 N16R8 1장이며 이 사진의 보드가 아니다.

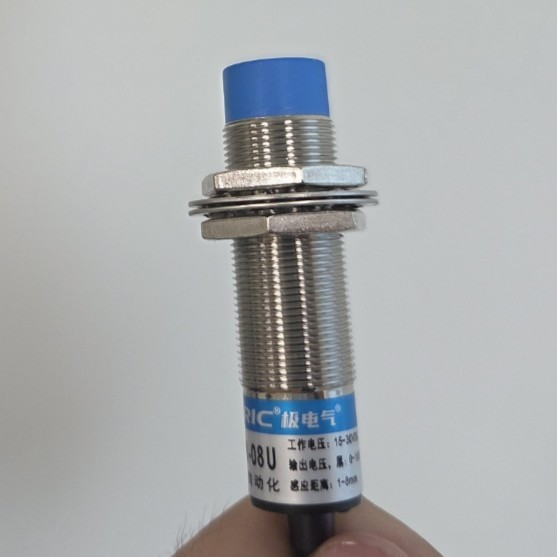
[picture p3: docs/hardware-digital-twin/photos/parts/02-gtric-lr18-08u.jpg]
GTRIC LR18-08U


그림. GTRIC LR18-08U 와전류 유도형 근접 센서. 몸체 라벨 기준 동작 DC 15–30 V, 출력 0–10 V, 감지 1–8 mm이다. 금속 레일과의 간격 변화를 연속 전압으로 내보내 단차·국부 침하에 따른 거리 변동을 계측한다. 전류를 재는 센서가 아니다.

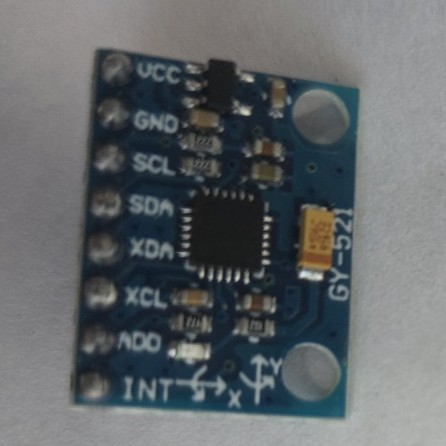
[picture p4: docs/hardware-digital-twin/photos/parts/03-mpu6050-gy521.jpg]
MPU-6050


그림. MPU-6050(GY-521). 좌·우 각 1개이며 I2C 주소는 0x68이다. 브링업은 가속도 ±2g만 읽고 자이로는 읽지 않는다. 정지·수평에서 Z가 위(+)이다.

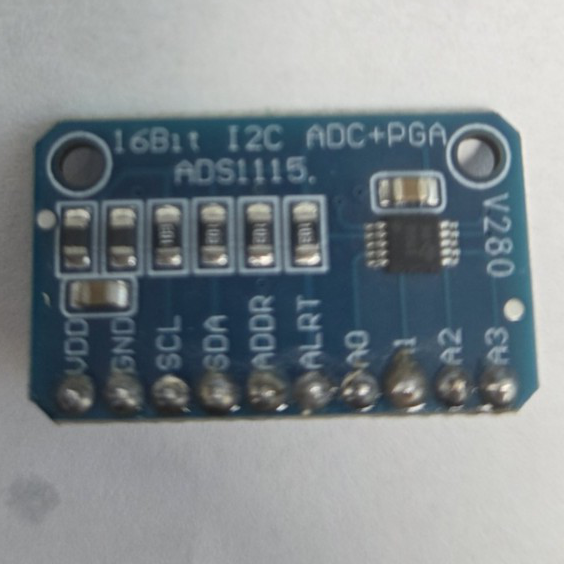
[picture p5: docs/hardware-photos/04-ads1115.jpg]
ADS1115


그림. ADS1115 16 bit I2C ADC. 좌·우 각 1개, 주소 0x48. LR18 출력을 20kΩ/10kΩ으로 나눈 뒤 AIN0에서 읽는다.

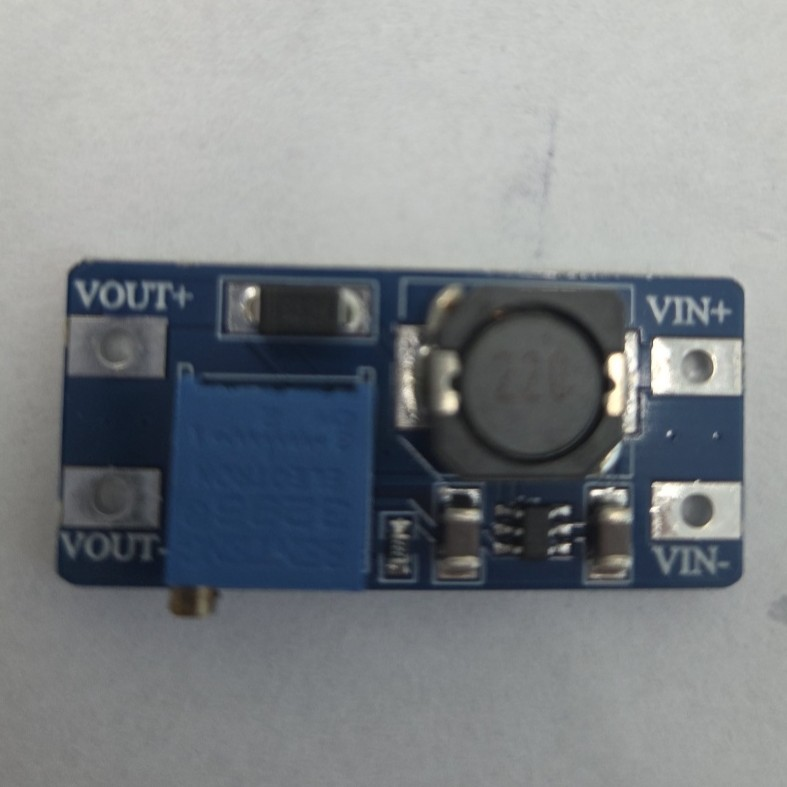
[picture p6: docs/hardware-photos/05-mt3608-boost.jpg]
MT3608


그림. MT3608 승압 모듈. 좌·우 센서 전지 각 1셀을 24V 목표로 올린다. 로직 USB-C, 모터 3S와 전지는 나누고 접지만 공통이다. 부하 상태 출력 전압은 미확인이다.

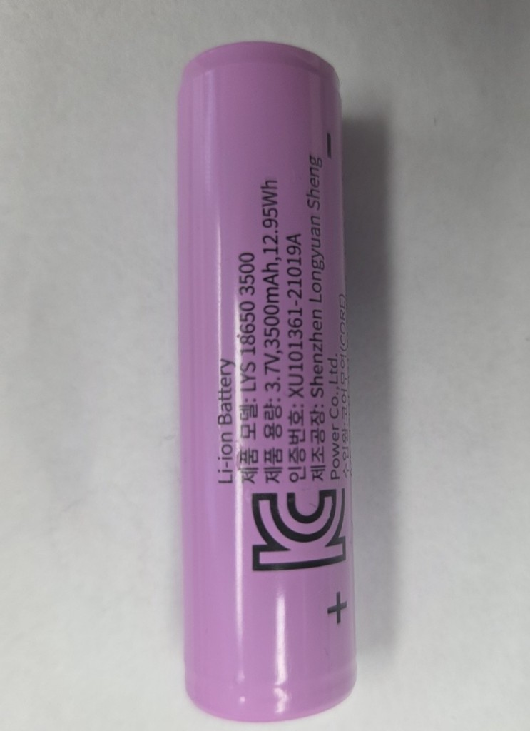
[picture p7: docs/hardware-photos/01-18650-battery.jpg]


그림. 18650 Li-ion. 조립 수량은 9개이다. 로직 1셀(USB-C, ON/OFF), 센서 좌·우 각 1셀, 모터 좌·우 각 3S.

`[공란: 센서 모듈 전체 배선 사진 — 이후 삽입]`

위 부품을 한 브레드보드·외피 안에 모은 전체 배선 사진을 여기에 넣는다. 캡션 예정: 간격·진동·위치 센서와 전원이 한 노드로 결합된 모습.

**부품 실물 — 주행 구동부 (센서 모듈을 실어 레일을 굴리는 역할)**

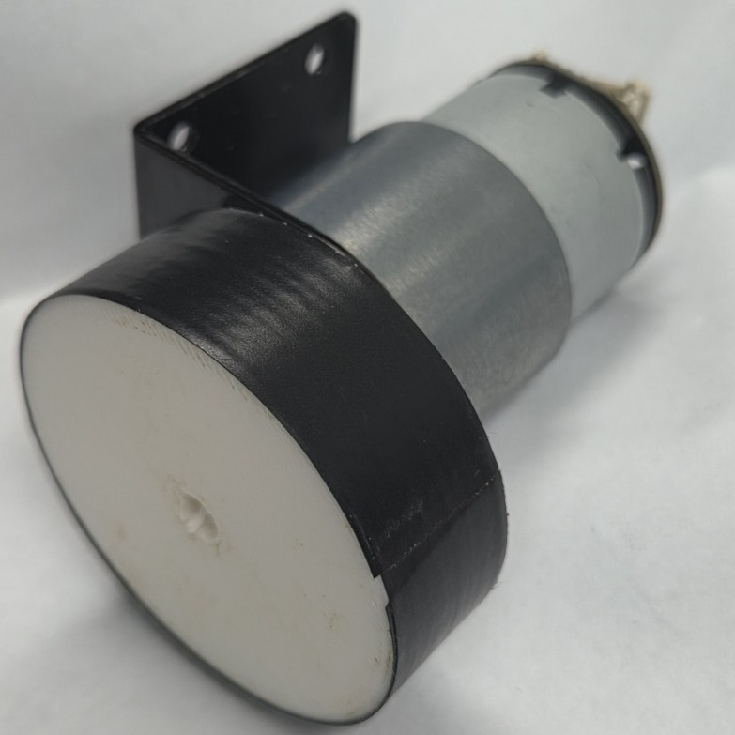
[picture p8: docs/hardware-digital-twin/photos/parts/07-jgb37-520-drive-wheel.jpg]
JGB37-520


그림. JGB37-520 기어드모터와 구동륜. 12 V, 37 RPM, 엔코더 내장. 느린 회전으로 간격·진동을 충분히 샘플링한다. 답면 고무는 미끄러짐을 줄인다. 바퀴 플랜지 외경 53 mm, 답면 약 47 mm이다.

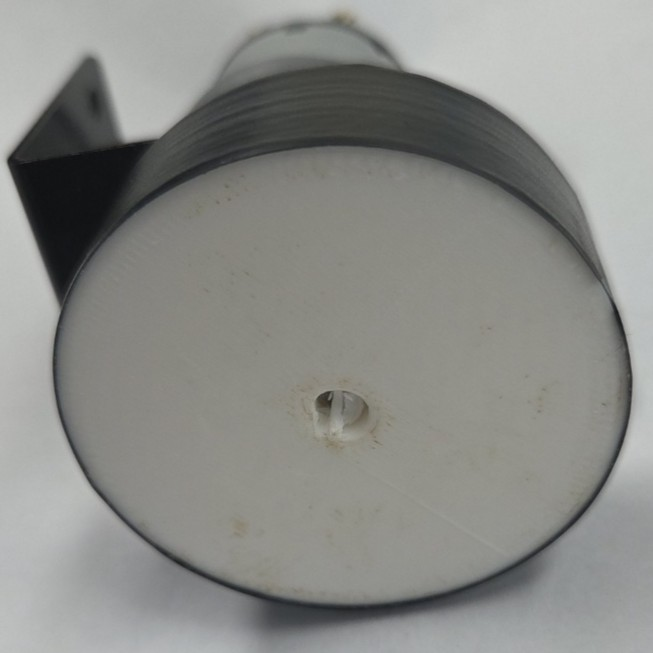
[picture p9: docs/hardware-digital-twin/photos/parts/08-motor-front-bracket.jpg]
모터 브래킷


그림. 모터 전면 브래킷. 기어박스 앞면 나사 규격에 맞춰 주행부 다리에 고정한다.

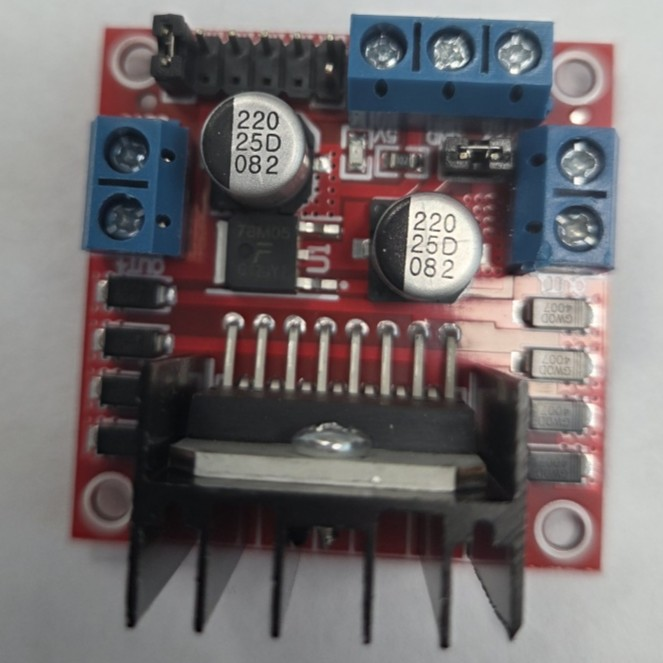
[picture p10: docs/hardware-photos/06-l298n-driver.jpg]
L298N


그림. L298N. 좌·우 각 1개이며 A채널만 쓴다. ENA 점퍼와 5V-EN 점퍼는 제거한다. 좌 모터는 OUT1/OUT2를 교차한다.

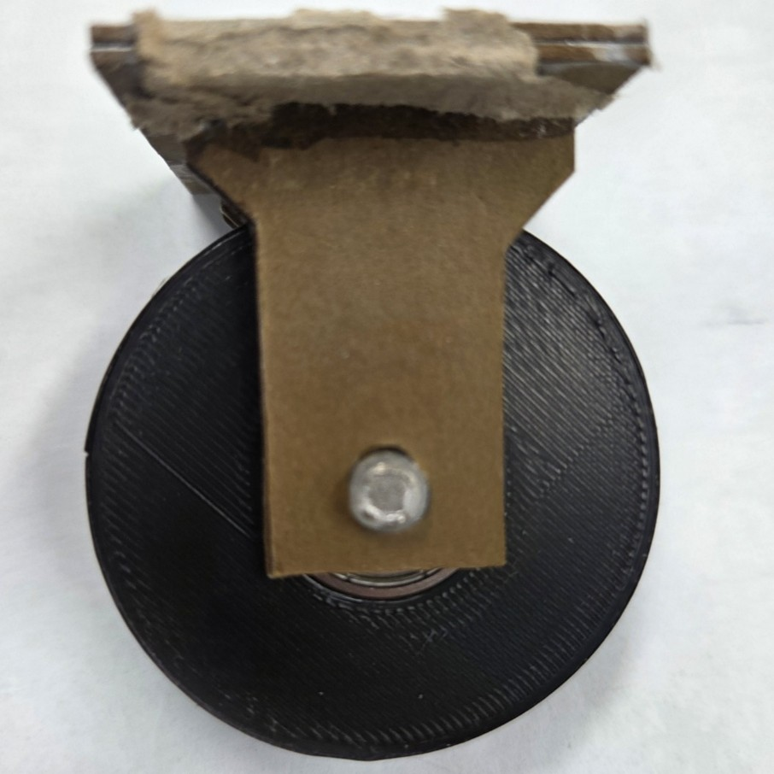
[picture p11: docs/hardware-digital-twin/photos/parts/09-idle-wheel-bracket.jpg]
보조륜


그림. 3D 출력 보조륜과 브래킷. 모터 없이 따라 돌며 레일을 지지한다. 608 베어링과 축으로 자유롭게 회전한다.

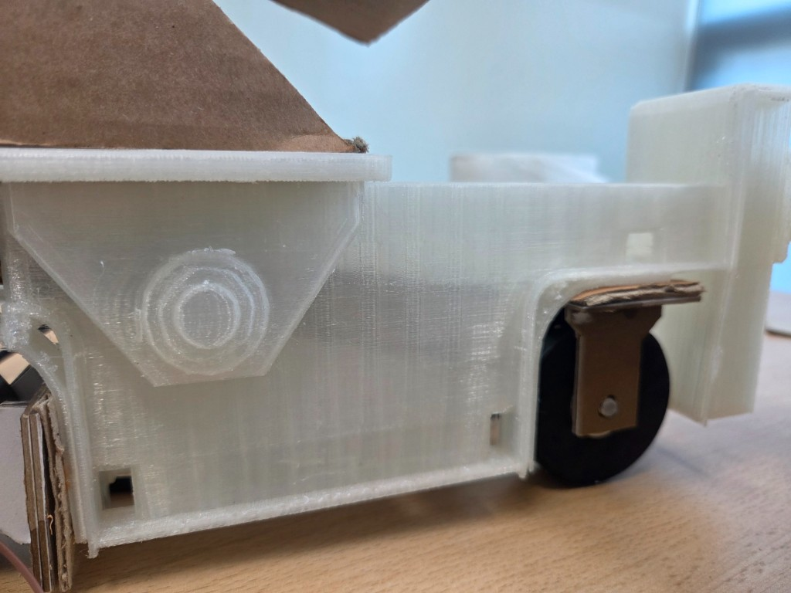
[picture p12: docs/hardware-photos/10-drive-housing-side.jpg]
구동부 외피


그림. 3D 출력 주행부 측면. 센서 모듈 공간과 바퀴·브래킷을 한 다리에 모은다. 설계 스케일은 1.35배, 주행부 약 90 × 257 × 128 mm, 벽 두께 3 mm이다.

**레일 대체재 (1차 시연)**

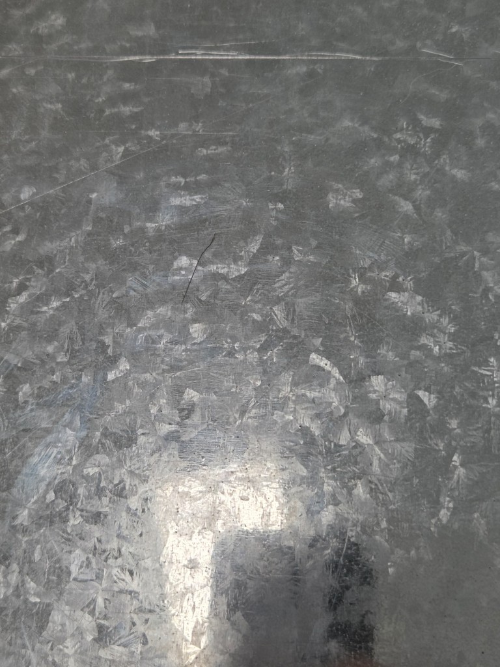
[picture p13: docs/hardware-photos/11-galvanized-steel-rail.jpg]
아연도금 강판


그림. 아연도금 강판 부품 사진. 2026-09-24 측정 레일은 바닥에 놓은 아연 각파이프이다. 이 강판 사진이 그 레일 전체는 아니다. 유도형 센서는 자성 금속 표면의 간격을 읽는다.

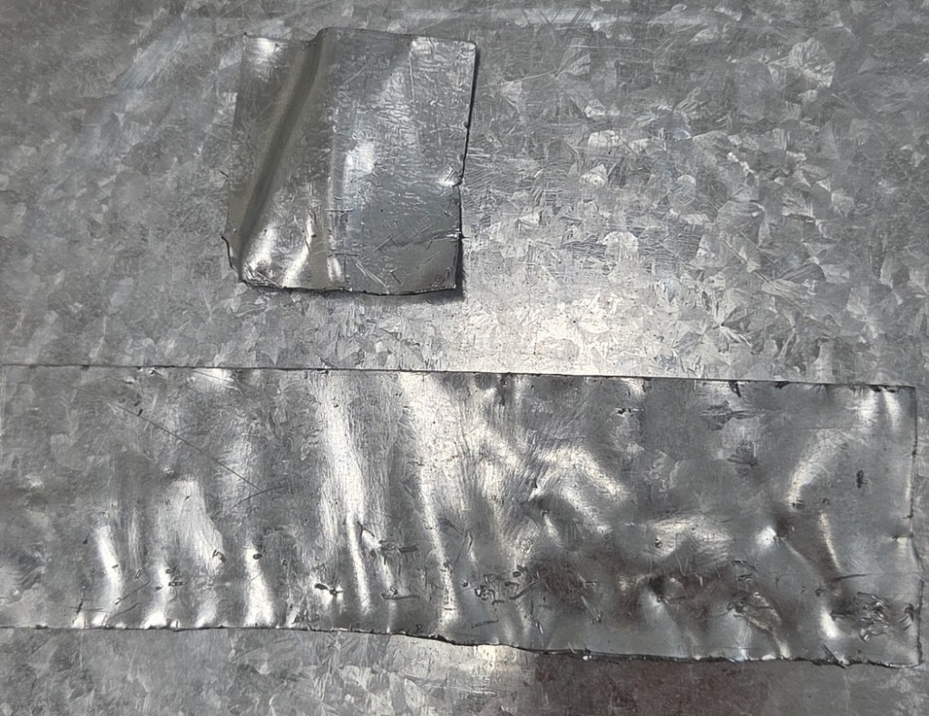
[picture p14: docs/hardware-photos/12-rail-metal-strips.jpg]
레일 조각


그림. 양쪽 주행 줄로 재단한 금속판. 좌·우 레일 경로를 두 줄로 배치한다.

`[공란: 전체 축소 모형 + 레일 사진 — 이후 삽입]`

좌·우 구동부와 강판 레일이 조립된 전체 모형 사진을 여기에 넣는다. 캡션 예정: 축소 갠트리 모형이 좌·우 레일을 왕복하며 센서 노드가 간격·진동·위치를 수집하는 시험 플랫폼.

### 5. 기타 사항: 본문에서 표현되지 못한 작품의 가치(Value) 및 제작 노력

본 작품의 핵심 가치는 레일 이상을 단순 알림값으로 남기지 않고, 주행 위치와 결합된 구간 위험도로 변환하여 점검 지점을 특정한다는 점이다. 좌·우 독립 계측, 특징 공학, AI 추론, 시계열 저장, 웹·3D 시각화를 하나의 데이터 계약으로 연결함으로써 센서 교체나 화면 추가 시에도 인터페이스를 유지할 수 있다.

신뢰성 측면에서는 스키마 검증, 부팅 식별자, 배치 순번, 중복 제거, Queue 포화 시 최신 데이터 우선, DB·WebSocket 오류 격리를 적용한다. 사용성 측면에서는 전문 신호 분석 없이도 히트맵 색상으로 우선 점검 구간을 파악할 수 있도록 한다. 보안 측면에서는 장치별 MQTT 인증을 사용하고, 운영 단계의 TLS와 대시보드 접근 제어를 목표로 한다.

알고리즘 측면에서는 원시 시계열을 블랙박스에 넣지 않고, 파고율·거리 편차처럼 현장 담당자가 해석할 수 있는 특징을 거친 뒤 경량 RBF 대리 모델을 사용한다. 생성되는 위치·특징·위험도 시계열은 이후 모델 개선과 점검 이력 분석의 데이터 자산이 된다.

구매한 상용 3D 모델은 디지털 시각화용이며, 물리 제작용 평판·구동부 모델과 구분해 관리한다. 라이선스 제한 자산은 공개 저장소에 배포하지 않는다.

### 6. 향후 개선사항

- 분압 저항 Ω과 로직·센서·모터 전압을 측정한다. 거리 교정표는 브링업에 있으며, 가변저항을 돌리거나 레일 재질이 다를 때 다시 뜬다.
- 레일 0mm, 이음부 위치·높이, `t` 주행의 줄자 거리, 진행 방향의 좌·우와 전진, IMU X·Y를 기록한다. 잠정 엔코더는 약 0.0497 mm/카운트이다.
- 조립 모형의 반복 주행 절차를 작성하고 이음부 단차(실측)·수직 변형·좌우 높이차 라벨을 수집한다.
- 실측 데이터로 RBF 모델을 재학습한 뒤 MAE, RMSE, 재현율, 오탐률, 추론 지연시간을 평가한다.
- 웹·Godot의 운영 WSS 연결, 인증서, 접근 제어를 재검증한다.
- 아연 각파이프의 길이·단면·간격을 재고, 테이프 이음은 주행 전후로 단차를 다시 확인한다.
- 장기 추세 조회, 점검 이력, 위험 알림 기능을 단계적으로 추가한다.

## PDF 9~10쪽 — III. 프로젝트 수행 내용

### 1. 프로젝트 수행일정

프로젝트 기간: 2026. 6. 초 ~ 2026. 9. 30. (1차 평가 2026-08-25, 2차 평가 2026-09-30)

| 구분 | 추진내용 | 6월 | 7월 | 8월 | 9월 |
|---|---|---|---|---|---|
| 계획 | 목표 정의, 역할 분담, 하부 레일 이상 범위 확정 | 수행 |  |  |  |
| 분석 | 센서–백엔드–AI–시각화 요구사항 및 데이터 흐름 분석 | 수행 | 수행 |  |  |
| 설계 | 물리 모형, 구동부, 현재 센서 모듈, 서비스 흐름 설계 |  | 수행 | 수행 |  |
| 개발 | FastAPI, 특징 공학·RBF, 웹·Godot, 센서 펌웨어, 모형 조립 |  | 수행 | 수행 | 수행 |
| 테스트 | 반복 주행, 실측 저장, 모델 재학습, WSS 종단 검증 |  |  | 계획 | 수행 |
| 종료 | 2차 평가 자료, 성능 평가, 최종 증빙 정리 |  |  |  | 수행 |

공식 양식에는 계획(노랑)과 수행 완료(초록) 색상을 월별 칸에 표시한다. 2026-08-25 기준 반복 주행 시험과 실측 데이터 저장은 아직 수행하지 않았다.

#### 월별 수행 내용

- **6월:** 프로젝트 목표와 역할을 정하고 센서–백엔드–AI–디지털 트윈으로 이어지는 전체 구조를 기획하였다.
- **7월:** 초기 수집 프로토타입, 하부 레일 이상 중심의 AI 파이프라인, Godot WebSocket 연동, 위치별 `rail_risk` 시각화와 Docker 기반 서버 구성을 개발하였다.
- **8월:** 좌·우 레일 WebSocket 구조, 웹 대시보드, 배포를 보완하였다. 센서 부품을 수령해 분압을 포함한 모듈 배선을 진행하고, 당시 ESP32-C3 펌웨어 동작과 구동부 출력을 확인하였다. 1차 평가용 개발보고서와 증빙 자료를 정리하였다.
- **9월:** 조립 실물을 ESP32-S3-DevKitC-1 1장으로 확정하고 브링업에서 I2C, 금속 반응, 모터, 30cm 주행을 확인하였다. 측정 레일은 아연 각파이프이다.
- **9월 계획:** 조립 모형의 반복 주행, 센서 교정과 실측 저장, RBF 재학습·정량 평가, 웹·Godot 종단 연동 검증과 2차 평가 자료 정리를 수행한다.

### 2. 팀원의 세부목표 수립 및 협업을 위한 노력

| 팀원 | 역할 | 프로젝트 세부목표 |
|---|---|---|
| 팀장 | Assembly & Test / 프로젝트 조정 | 하드보드 부품 제작·전체 조립, 반복 주행 시험, 통합 문제 해결과 일정·증빙 관리 |
| 팀원 A | Digital Twin & Web View | Godot·웹 시각화, 3D 모델, 좌·우 레일 위치·위험도 매핑 |
| 팀원 B | Sensor & Edge | 센서 회로·전원·핀 배치, ESP32-S3 브링업, 교정, 대차 배선과 반복 계측 |
| 팀원 C | Backend & AI | FastAPI·InfluxDB·WebSocket, 특징 공학, RBF 모델, 데이터 계약과 실측 성능 평가 |

> 내부 역할 대응(최종 PDF에는 기재하지 않음): 팀장 김정우, 팀원 A 김병서, 팀원 B 배용진, 팀원 C 배준호.

#### 1) 프로젝트 수행(협업) 방안

- Notion으로 작업 내용을 공유·기록하고, GitHub로 소프트웨어 코드와 변경 이력을 관리하였다.
- 실제 하드웨어에 접근하기 어려운 팀원은 같은 WebSocket 형식을 사용하는 더미 스트리머로 연동 기능을 개발하였다.
- 구매한 디지털 자산과 물리 제작 모델을 분리하고, 라이선스 제한 파일은 공개 저장소에 올리지 않는 원칙을 사용하였다.
- 박영섭 멘토는 개발보고서에서 중점적으로 표현할 내용과 현재 진척도에 따라 우선 구현할 파트에 관한 조언·피드백을 제공하였다.
- 팀 회의는 2주에 1회 진행하여 담당 영역의 작업 내용, 문제점과 다음 구현 우선순위를 점검하였다.

### 3. 프로젝트 추진 과정에서의 문제점(애로사항) 및 해결방안

#### 1) 프로젝트 관리 측면

1. 문제점: 담당 영역별 장비와 개발 환경이 달라 동시에 통합 시험하기 어려웠다. 센서 보드가 준비되기 전에는 웹·Godot·AI가 실제 업링크를 기다릴 수밖에 없었다.

해결 방안: 센서 미연결 환경에서도 동일한 데이터 흐름을 재현하는 더미 스트리머와 Docker 실행 구성을 마련하고, 공통 JSON 페이로드를 기준으로 병렬 개발하였다.

2. 문제점: 하드웨어 구성이 바뀌면서 과거 코드·문서와 조립 실물이 섞였다. 초기 수집은 ESP32-S3-WROOM-1, ADXL345, HC-SR04였고, 그다음 문서는 ESP32-C3 두 장으로 적혀 있었다.

해결 방안: 2026-09-24 조립 실물을 ESP32-S3-DevKitC-1 N16R8 1장과 좌·우 MPU-6050·ADS1115·LR18-08U로 명시하였다. ESP32-C3 두 노드는 저장소의 이전 펌웨어로, ESP32-S3-WROOM-1·ADXL345·HC-SR04는 취소된 초기 프로토타입으로 분리하였다.

3. 문제점: 일정 기록의 완료 상태와 실제 실물·시험 증빙이 일치하는지 재확인이 필요했다.

해결 방안: 완료·진행 중·계획·검증 필요를 구분하고, 사진·시험 로그·실행 화면이 없는 성과는 완료로 단정하지 않기로 하였다. 2026-09-25 기준으로 하드웨어 조립과 브링업의 I2C·금속 반응·모터·30cm 주행은 확인하였고, 반복 주행과 실측 저장은 미실시이다.

#### 2) 작품 개발 측면

1. 문제점: 정지 노이즈와 단차 충격을 구분해야 했다. 원시 가속도만 사용하면 정지 미세 진동과 주행 충격이 혼재된다.

해결 방안: 엣지에서 불필요한 정지 신호 전송을 줄이고, 서버에서 웨이블릿 디노이징과 파고율을 사용해 순간 충격 특징을 강조하도록 설계하였다. 최종 임계값과 거리 교정은 실측으로 조정한다.

2. 문제점: Wi-Fi 단절과 외부 저장소 장애가 실시간 처리를 지연시키거나 센서 배치 유실을 일으킬 수 있었다.

해결 방안: 블로킹 작업을 이벤트 루프와 분리하고 제한 Queue, 오래된 데이터 제거, DB 오류 격리, WebSocket 연결 정리, 엣지 미발행 버퍼와 QoS 1을 적용하였다.

3. 문제점: 실제 레일 변형과 연결된 라벨 데이터가 부족했다.

해결 방안: 합성 데이터와 40~50cm 단차 충격 더미 신호로 학습·추론 인터페이스를 먼저 고정하였다. 이는 실제 성능 증거가 아니며, 재현 가능한 시험 구간과 실측 기준을 확정한 뒤 모델을 재학습·평가한다.

4. 문제점: GTRIC LR18-08U의 0–10V 출력을 ADS1115 허용 범위에 맞춰야 했다.

해결 방안: 실제 보유품 몸체 라벨로 0–10V 출력을 확인하였다. 분압·입력 보호 회로와 공통 접지를 설계하고, 연결 전 멀티미터로 최대 출력전압을 검증하는 절차를 반영하였다. 회로값과 실측 전압은 측정 기록으로 확정한다.

5. 문제점: HTTPS 페이지에서 암호화되지 않은 WebSocket이 차단될 수 있었다.

해결 방안: 화면 다운링크는 WSS를 목표 경로로 두고, 로컬 개발용 `ws://`와 운영용 `wss://`를 구분해 문서로 관리한다. 실제 운영 인증서와 접속 성공은 종단 시험으로 재확인한다.

### 4. 프로젝트를 통해 배우거나 느낀 점

이번 프로젝트를 수행하면서 레일 안전관리는 모델 정확도만의 문제가 아니라, 센서 설치 방향, 전원, 샘플링, 단위, 교정, 데이터 계약이 함께 맞아야 한다는 점을 배웠다. 특히 좌·우 노드를 독립적으로 운영하면서 `device_id`, `rail_side`, 엔코더 영점이 어긋나면 화면의 위치와 위험 구간이 즉시 어긋난다는 것을 확인하였다.

또한 합성 데이터는 파이프라인 개발에 유용하지만, 안전관리 성능을 주장하려면 실측 라벨과 정량 검증이 반드시 필요함을 인식하였다. 더미 스트리머로 웹·Godot 개발을 지속할 수 있었으나, 이는 종단 시험을 대신하지 않는다.

하드웨어 구성을 초기 프로토타입에서 현재 센서로 전환하는 과정에서는 과거 필드명과 현재 계약을 섞지 않는 문서화가 재작업을 줄인다는 점을 배웠다. 팀원 간에는 공통 JSON 키와 완료 기준을 먼저 합의한 뒤 모듈을 개발하는 방식이 통합 단계의 충돌을 줄였다.

스마트해운물류×ICT 멘토링을 통해 보고서에서 핵심 대상을 하부 주행 레일로 고정하고, 현재 진척도에 따라 우선 구현할 파트를 선택하는 과정의 중요성을 배울 수 있었다. `[팀원별 개인 소감: 확인 필요]`

## PDF 11쪽 — IV. 작품의 기대효과 및 활용분야

### 1. 작품의 활용(적용)분야

ㅇ 컨테이너 터미널의 안벽·야드 갠트리 크레인 하부 주행 레일

주행 중 단차·침하·뒤틀림 징후를 좌·우 구간으로 표시하여 점검 담당자가 우선 확인해야 할 위치를 좁힐 수 있다.

ㅇ 조선소 골리앗 크레인 및 대형 레일 주행 설비

장거리 레일에서 국부 이상이 반복되는 구간을 시계열로 축적하면 유지보수 주기를 상태 기반으로 조정하는 기초 자료가 된다.

ㅇ 제철소·물류창고·제조 현장의 레일 기반 이동 장비

동일 센서 계약과 특징 공학 파이프라인을 레일 길이·구간 수에 맞게 확장하여 적용할 수 있다.

ㅇ 스마트항만·디지털 트윈 교육 및 연구

축소 모형과 웹·3D 화면을 이용해 계측–추론–시각화의 종단 흐름을 교육·시연하는 플랫폼으로 활용할 수 있다.

주요 사용자는 항만 운영·안전관리 담당자, 설비 유지보수·점검 담당자, 크레인 관제 담당자, 스마트항만 시스템 개발자다.

### 2. 작품의 활용에 의한 기대효과(사용자)

ㅇ 설비 점검 담당자는 레일 전체를 동일 밀도로 훑는 대신, 엔코더 위치와 좌·우 `rail_risk`가 높게 누적된 구간을 우선 확인할 수 있다. 단차·국부 침하·뒤틀림은 특정 지점에 집중되는 경우가 많으므로, 점검 범위를 구간 단위로 좁히면 같은 인력으로도 이상 가능 지점에 더 많은 시간을 배분할 수 있다.

ㅇ 유지보수 담당자는 웹 대시보드의 좌·우 CREST·PRED_RAIL_DEFORM 값과 히트맵을 현장 도착 전에 공유할 수 있다. 어느 레일의 몇 미터 부근을 볼지 미리 합의하면, 공구·자재·작업 허가를 해당 구간에 맞춰 준비할 수 있다. Godot 3D 화면은 동일 데이터를 공간적으로 보여 주어 원격 사무실과 현장 팀의 위치 인식을 맞추는 데 도움이 된다.

ㅇ 크레인 관제·운전 담당자는 운행 중에만 나타나는 충격·진동을 정지 점검만으로 놓치기 쉽다. 본 작품은 주행 중 가속도·자이로·레일 간격·위치를 함께 기록하므로, 운전 중 이음을 느꼈던 지점을 이후 화면의 위험 구간과 대조하는 보조 자료로 활용할 수 있다.

ㅇ 안전관리 담당자는 정기 점검 주기 사이에 발생한 레일 기하 이상 징후를 상시 모니터링 결과로 보완할 수 있다. 육안 확인이 어려운 야간, 우천, 분진·조도 부족 환경에서도 주행 데이터가 남으면, 다음 주간 점검의 우선 구간을 전날에 정리할 수 있다.

ㅇ 좌·우 레일을 독립 노드로 계측하므로, 한쪽만 단차이거나 좌우 간격 변화가 어긋나는 치우침 징후를 구분할 수 있다. 사용자는 양쪽을 동시에 걷는 대신, 위험이 높은 쪽 레일부터 확인하여 작업 동선을 줄일 수 있다.

ㅇ 반복 주행 데이터가 축적되면 같은 구간에서 위험도가 되풀이되는지 확인할 수 있다. 일회성 이물질·일시 충격과 지속적인 기하 이상을 구분하면, 불필요한 긴급 정비를 줄이고 반복 구간에 교정·보강 계획을 집중할 수 있다.

ㅇ 교대 근무와 인수인계 과정에서 구두 설명에 의존하던 이상 위치를, 히트맵과 시계열 기록으로 넘길 수 있다. 다음 조는 이전 조의 체감에만 기대지 않고 동일 화면을 기준으로 점검을 이어갈 수 있어, 정보 누락을 줄이는 데 도움이 된다.

ㅇ 외주 점검 업체나 협력사는 현장 지리에 익숙하지 않아도 구간 색상과 거리 좌표로 작업 지점을 공유받을 수 있다. 발주 부서는 점검 요청 시 “레일 전체”가 아니라 우선 구간을 명시하여, 외주 시간과 차단 범위를 합리적으로 조정할 수 있다.

ㅇ 정비 계획 담당자는 위험도가 누적되는 구간을 월·분기 예방정비 목록에 반영할 수 있다. 고가 정밀 계측을 전 구간에 매번 투입하기보다, 본 시스템의 우선 구간을 1차로 걸러 정밀 측량·레일 교정 자원을 배치하는 단계적 의사결정이 가능하다.

ㅇ 설비 관리 부서는 InfluxDB에 남는 위치·특징·예측 시계열을 장기 추세 자료로 활용할 수 있다. 특정 이음매나 침하 의심 구간에서 파고율과 거리 편차가 커지는 경향이 보이면, 고장 발생 후가 아니라 경향이 나타나는 시점에 보강 여부를 검토할 수 있다.

ㅇ 본사·현장·협력사가 웹으로 같은 화면을 보면, 사진과 구두 보고만으로 위치를 설명하던 회의 시간을 줄일 수 있다. 디지털 트윈은 보고 자료와 교육 자료로도 재사용되어, 신입 점검원에게 단차·침하·뒤틀림이 화면에서 어떻게 나타나는지 시연하는 데 활용할 수 있다.

ㅇ 스마트항만·디지털 트윈 담당자는 본 작품을 레일 상태 감시의 현장 데이터 입력단으로 연결할 수 있다. 기존 관제 시스템이 크레인 위치·작업 실적 중심이라면, 하부 레일 위험 구간을 같은 시각화 계층에 올려 운영 정보와 설비 정보를 함께 보는 가능성을 제공한다.

ㅇ 컨테이너 터미널 외에도 조선소 골리앗 크레인, 제철소·물류창고의 레일 주행 설비에 같은 사용자 효과를 기대할 수 있다. 레일 길이와 구간 수만 조정하면, 장거리 레일에서 “어디부터 볼 것인가”라는 공통 문제를 동일 방식으로 지원할 수 있다.

ㅇ 교육·연구 사용자는 축소 모형과 웹·3D 화면으로 계측–특징 공학–추론–시각화의 종단 흐름을 실습할 수 있다. 항만 안전·예지보전 교육에서 추상적인 레일 이상을 위치와 색상으로 연결해 이해도를 높이는 보조 교재가 된다.

ㅇ 작업 중단 범위를 전 선로가 아니라 위험 구간 인근으로 한정하면, 점검 중에도 인접 구간의 운영 제약을 줄일 여지가 있다. 이는 운영 부서와 정비 부서 간 조율 비용을 낮추는 간접 효과로 기대할 수 있다.

ㅇ 사고 조사나 이상 보고 시에는 “어느 지점에서 충격이 반복됐는지”를 위치 기록으로 보조할 수 있다. 본 작품은 법적 계측기를 대체하지 않으나, 육안·정기 점검 기록을 보강하는 내부 참고 자료로 사용될 수 있다.

ㅇ 위 효과는 사용자가 우선 점검 구간을 더 빠르게 합의하고, 반복 이상을 추세로 관리하며, 원격·현장·외주 주체가 같은 화면을 보게 하는 데 있다. 사고 감소율, 점검 시간 단축분, 유지보수 비용 절감액 등 정량 효과는 현장 실증 후 평가한다.

### 3. 작품의 기대가치

ㅇ 본 작품의 상용화 가능성은 고가 정밀 측량기를 대체하는 완제품이 아니라, 기존 갠트리 크레인에 후장착하여 운행 중 레일 단차·국부 침하·뒤틀림 징후를 위치 단위로 걸러 주는 보조 모니터링 제품으로 진입하는 데 있다. 항만·조선소 현장은 이미 정기 점검과 육안 확인을 수행하고 있으므로, 전면 교체형 시스템이 아니라 “우선 점검 구간을 제시하는 계층”으로 붙는 형태가 구매 결정을 쉽게 만든다.

ㅇ 기존 서비스와의 차별성은 세 가지이다. 첫째, 정지 상태의 정적 간격 측정이나 전 구간 정밀 측량과 달리 주행 중 동적 가속도·자이로·거리·위치를 함께 본다. 둘째, 범용 진동 감시처럼 이상 여부만 알리지 않고 엔코더 좌표와 좌·우 레일 구간 히트맵으로 위치를 특정한다. 셋째, 웹 대시보드와 Godot 디지털 트윈이 같은 데이터 계약을 쓰므로 현장·원격·외주가 동일 화면으로 소통할 수 있다.

ㅇ 가격 우위는 범용 부품과 오픈소스 소프트웨어 조합에서 나온다. 센서부는 ESP32-S3-DevKitC-1, MPU-6050, ADS1115, 아날로그 유도형 근접 센서, 모터 내장 엔코더처럼 수급이 쉬운 구성이며, 서버는 FastAPI·InfluxDB·MQTT·WebSocket으로 구성한다. 레일 전체를 매번 정밀 측량하거나 전용 궤도 검측차를 투입하는 비용과 비교하면, 대차에 센서를 올리는 후장착 키트와 클라우드 대시보드 구독으로 1차 스크리닝을 제공하는 모형이 도입 장벽을 낮춘다.

ㅇ 출시 가칭은 작품명 HP028 RailTwin(레일트윈)을 제품 라인으로 유지하는 것을 전제로 한다. 1단계는 교육·시연·외주 점검 업체의 단구간 파일럿, 2단계는 단일 크레인 좌·우 노드와 웹 대시보드의 현장 실증, 3단계는 다중 크레인·위험 알림·정비 이력·장기 추세를 묶은 구독형 서비스이다. 하드웨어는 노드 키트 판매, 소프트웨어는 데이터 저장·화면·알림의 월 과금으로 나누면 초기 투자와 운영비를 분리할 수 있다.

ㅇ 상용화에 유리한 기술 구조는 모듈화이다. 좌·우 노드가 고유 `device_id`와 `rail_side`로 MQTT를 발행하므로 크레인 대수나 레일 길이가 늘어도 동일 계약을 복제하면 된다. 특징 공학과 RBF 추론, 저장, 화면이 분리되어 있어 현장별로 레일 길이·구간 수·알림 임계값만 조정하면 조선소 골리앗, 제철소, 물류창고 레일 설비로 제품 라인을 확장할 수 있다.

ㅇ 경제적 가치는 정밀 계측과 선로 차단을 “어디에 쓸 것인가”를 가리는 데서 발생한다. 전 구간을 동일 빈도로 점검하면 인력·외주·작업 중단에 드는 비용이 커진다. 본 작품이 반복 위험 구간을 제시하면 정밀 측량·레일 교정 자원을 해당 지점에 집중할 수 있고, 일회성 충격과 지속 이상을 구분하면 불필요한 긴급 정비를 줄일 여지가 있다. 절감액의 정량은 현장 실증 후 산출한다.

ㅇ 스마트항만·디지털 트윈 투자와 맞물리면 단독 제품이 아니라 기존 관제·설비관리 화면의 레일 상태 레이어로 납품할 수 있다. 크레인 위치·작업 실적만 보던 시스템에 하부 레일 위험 구간을 올리면, 터미널 운영사와 SI 업체가 추가 모듈로 도입하기 쉬운 형태가 된다. 이는 신규 단독 구축보다 상용 채널을 넓히는 경로이다.

ㅇ 수요 측면에서는 컨테이너 터미널 RMG/RTG 하부 레일, 조선소 대형 크레인, 제철·물류 레일 주행 설비가 같은 현장 과제를 가진다. 레일이 길고 육안 점검 주기가 정해져 있으며, 이상이 국부에 집중되고, 점검 중 조업 제약이 크다는 점이 공통이다. 한 현장에서 검증된 노드·데이터 계약·화면을 다른 레일 설비에 옮길 수 있으므로, 초기 시장을 항만으로 두고 인접 산업으로 확장하는 상용화 전략이 가능하다.

ㅇ 실제 제품화까지는 내환경성, 방수·방진, 전원 안정성, 장기 내구, 교정 주기, 사이버보안, 현장 안전 절차를 산업 수준으로 올려야 한다. 본 작품은 법적 계측기나 인증 검측 장비를 대체하지 않으며, 상용 1호는 “점검 보조·우선 구간 제시” 범위의 비인증 모니터링으로 출시하는 것이 현실적이다. 실측 라벨로 모델 성능을 평가하고 파일럿 계약으로 오탐·누락을 조정한 뒤에야 알림 자동화와 유료 구독을 확대할 수 있다.

ㅇ 사업 모형이 성립하려면 하드웨어 마진만으로 끝나지 않고, 시계열 저장·다중 현장 대시보드·이력 리포트가 반복 매출이 되어야 한다. 노드를 한번 설치하면 이후에도 데이터가 쌓이므로, 유지보수 업체에는 다현장 통합 화면, 운영사에는 자사 레일 추세 리포트를 제공하는 B2B 구독이 가능하다. 교육용 축소 모형 패키지는 초기 레퍼런스와 인력 양성 채널로 병행할 수 있다.

ㅇ 프로젝트 자체의 가치는 센서부터 디지털 트윈까지 하나의 데이터 계약으로 종단 구현한 데 있다. 상용 이전 단계에서도 외주 점검, 사내 교육, 스마트항만 연구 실증에 바로 쓸 수 있는 형태이므로, 연구 시연에서 그치지 않고 파일럿 제품으로 넘어갈 수 있는 기반이 된다. 시장 규모·단가·매출 전망의 수치는 파일럿 원가와 현장 수요 조사 후 산정한다. `[확인 필요: 원가·단가·수요 조사]`

---

# 내부 작업 메모 — 공식 PDF에 그대로 이식하지 않음

## 이번 작성에서 적용한 원칙

1. I·II장의 기능·기술 서술은 최종 목표 시스템 기준이다. “아직 미완성” 문장은 II-6·진척도·III장으로 이동했다.
2. 더미 스트리머와 합성 데이터는 최종 시스템의 시연·병렬개발 기능으로 설명하되, 실측 정확도 증거로는 쓰지 않았다.
3. 현재 하드웨어는 ESP32-S3-DevKitC-1 N16R8 1장 + MPU-6050 + ADS1115 + GTRIC LR18-08U이다. ESP32-C3 두 노드는 이전 펌웨어이고, ESP32-S3-WROOM-1 + ADXL345 + HC-SR04만 취소된 초기 프로토타입이다.
4. 구성도 삽입은 과거 `docs/archive/previous-roadmaps/system-architecture.png` 대신 현재 센서 기준 플로차트 파일을 사용한다.

## `[확인 필요]` 항목

- 프로젝트 구분 번호, 승인 프로젝트명·영문명, 작품명, 팀명
- 공공데이터 활용 여부
- 선행기술 논문·특허·상용 제품과 출처
- 기능별 세부 완성 일정
- 분압 저항 Ω 실측, 100nF 미장착, 전원 전압 실측
- 엔코더 잠정 0.0497 mm/카운트의 줄자 대조, 레일 0mm, 진행 방향의 좌·우와 전진
- 아연 각파이프의 길이·단면·간격과 이음부 단차 실측. 수직 변형 경사판·한쪽 높임 판 제작 여부
- 실제 WSS 인증서·Godot 최종 씬 연동
- 실측 MAE·RMSE·재현율·오탐률·지연시간
- 시장성·사업화 근거
- 팀원별 개인 소감

## 삽입 그림·사진 목록

1. `docs/system-architecture-flowchart.png` — PDF 3쪽 작품 구성도
2. `docs/hw-architecture-flowchart.png` — II-1 HW 구성도
3. `docs/sw-architecture-flowchart.png` — II-1 SW 구성도
4. `docs/signal-processing-pipeline-flowchart.png` — II-2 신호처리
5. `docs/encoder-position-sync-flowchart.png` — II-2 위치 정합
6. `docs/web-dashboard-flow-flowchart.png` — SW 대시보드 상세
7. HW 부품 실물: `docs/hardware-photos/` (GTRIC, MPU-6050, ADS1115, MT3608, 18650, L298N, JGB37-520, 브래킷, 보조륜, 외피, 강판). `13-esp32-c3-mini.jpg`는 이전 C3 부품 사진이다. 분압 저항 단독 사진은 수록하지 않음
8. `[공란]` 센서 모듈 전체 배선, `[공란]` 전체 축소 모형+레일 — 이후 삽입
9. **합성 데이터** RBF 학습 화면: `docs/rbf-synthetic-training-evidence.png`, `docs/rbf-synthetic-feature-comparison.png`, `docs/rbf-synthetic-training-log.png`, `docs/rbf-synthetic-loss-curve.png` (실측 정확도 증거가 아님)
10. 대시보드·Godot·InfluxDB 화면

## PDF 이식 시 분량

- 2쪽 작품 개요, 3쪽 작품 구성도는 각각 반드시 1쪽
- II장은 기술 서술과 표를 5~8쪽에 배분하고 사진 칸을 먼저 확보
- 맑은고딕 10pt, 고정 줄 간격 16, 붉은 작성 안내 문구 삭제
- 역할표에서 실명 제거
