liebe1127/HP028_RailTwin/docs/gemini-prompt-4phase-roadmap.md

# Gemini 이미지 프롬프트 — 4단계 개발 로드맵

새 Gemini 채팅에 구분선 안 글과 함께 대차 사진 세 장을 첨부한다.

- `docs/hardware-digital-twin/photos/assembled/05-overhead-two-cells-before-motors-ran.jpg` — 위에서 본 실물.
- `docs/hardware-digital-twin/photos/assembled/06-end-view-two-white-rollers.jpg` — 끝에서 본 흰 롤러와 프로파일 프레임.
- `docs/hardware-digital-twin/photos/assembled/07-bogie-on-zinc-square-rails.jpg` — 대차가 아연 각파이프 두 줄 위에 올라가 있다.

---

16:9 와이드 기술 인포그래픽. 어두운 남색 배경. 위쪽에 제목과 부제. 그 아래 가로로 같은 너비의 카드 4장. 각 카드는 둥근 모서리, 얇은 밝은 테두리, 맨 위에 단계 번호와 영어 제목, 그 아래 한글 부제, 가운데 플랫 아이콘, 아래에 짧은 라벨. 청록·주황·초록 포인트. 사실 사진 콜라주가 아니라 엔지니어링 포스터. 한글과 영어는 아래 문구 그대로, 카드 안에 선명하게.

제목:
하부 주행 레일 이상 구간 디지털 트윈

부제:
간격·충격·기울기·위치로 이상 구간을 찾아 웹과 3D 레일에 표시

카드 1, 왼쪽
헤더: 1단계  SENSOR & EDGE
부제: 센서·엣지
그림: 첨부한 사진의 실물 대차를 아이콘으로 그린다. 은색 알루미늄 프로파일 두 줄이 좌우 프레임이고, 그 대차는 바닥에 놓은 은색 사각 각파이프 두 줄 위에 올라가 있다. 가운데 흰색 브레드보드에 ESP32 한 장이 있고, 그 옆에 분홍색 18650 전지 팩이 있다. 알록달록한 점퍼선은 초록 테이프로 묶여 있다. 한쪽 끝은 빨간 기판과 금속 기어드 모터, 반대쪽 끝은 흰색 3D 출력 롤러다. 프레임 아래에는 파란 끝이 각파이프를 보는 원통 센서가 있다.
라벨:
ESP32-S3 1장
LR18 좌·우 간격
MPU-6050 충격·기울기
엔코더 위치
세로 충격 시 즉시 정지

카드 2
헤더: 2단계  BACKEND & STREAM
부제: 수집·저장·전달
그림: 왼쪽 와이파이 전파, 가운데 FastAPI 서버, 아래 시계열 데이터베이스 원통, 오른쪽 화면으로 가는 화살표. 간격과 가속도를 나타내는 단순한 곡선 하나.
라벨:
MQTT 업링크
FastAPI 비동기 큐
InfluxDB 저장
WebSocket 다운링크
시연은 더미 스트림

카드 3
헤더: 3단계  RULE ENGINE
부제: 50mm 구간 규칙 판정
그림: 50mm 눈금 자, 판정 카드 3장, 초록·노랑·빨강 단계 배지. 규칙표처럼 단정한 아이콘.
라벨:
특징 m, Δ, 기울기, 충격
이음부 단차
수직 변형
좌우 높이차
정상·주의·위험

카드 4, 오른쪽
헤더: 4단계  DIGITAL TWIN
부제: 웹 · Unity 레일
그림: 왼쪽은 웹 대시보드 창. 오른쪽은 나란한 레일 두 줄. 구간 색은 초록, 노랑, 빨강. 레일 위에 현재 위치 마커 하나.
라벨:
웹 대시보드
Unity WebGL 레일만
초록 정상 · 평속
노랑 주의 · 감속
빨강 위험 · 정지
