liebe1127/HP028_RailTwin/배준호_전달/대처지침_웹표시용.md

# 레일 결함 대처 지침 (웹 대시보드 표시용)

한계선: ISO 12488-1 1급 — 이음부 단차 1.0 mm / 수직 변형 1.0 mm / 좌우 높이차 5 mm
단계: 정상(한계선의 50% 이하) · 주의(50%~한계선) · 위험(한계선 초과)
단계 판정은 같은 구간을 3회 이상 지난 평균값으로만 내림 (그 전까지는 "관찰 중" 표시)

## 1. 분류별 대처 지침 (defect_type × stage)

| 분류 | 단계 | 운전 조치 | 정비 조치 | 점검 대상 |
|---|---|---|---|---|
| 정상 (normal) | 정상 | 평소 속도 유지 | 없음 | – |
| 이음부 단차 (joint_step) | 주의 (0.5~1.0 mm) | 해당 구간 0.1 m/s로 감속 통과 | 다음 정기 점검 시 확인 | 이음판·볼트 조임, 용접부 마감, 열팽창 틈 |
| 이음부 단차 (joint_step) | 위험 (>1.0 mm) | 해당 구간 진입 전 정지, 정비 확인 후 운행 | 즉시 점검 | 이음판·볼트 풀림, 용접부 균열, 레일 끝 마모 |
| 수직 변형 (vertical) | 주의 (0.5~1.0 mm) | 해당 구간 0.1 m/s로 감속 통과 | 다음 정기 점검 시 확인 | 받침판 밑 그라우트, 거더 처짐, 기초 침하 |
| 수직 변형 (vertical) | 위험 (>1.0 mm) | 해당 구간 진입 전 정지 | 즉시 점검, 필요 시 받침 재시공 | 받침판 그라우트 열화, 거더 처짐, 기초 침하 |
| 좌우 높이차 (cross_level) | 주의 (2.5~5 mm) | 해당 구간 0.1 m/s로 감속 통과 | 다음 정기 점검 시 확인 | 낮은 쪽(side) 레일의 받침판·기둥 |
| 좌우 높이차 (cross_level) | 위험 (>5 mm) | 해당 구간 진입 전 정지 (탈선 방향이라 가장 위험) | 즉시 점검, 낮은 쪽 받침판 높이 조정 | 낮은 쪽 기둥·받침 열화, 한쪽 그라우트 박리 |

## 2. 위치별 표시 항목 (결함 하나마다)

- 구간: from_mm ~ to_mm (예: 600~1200 mm, 이음부 사이 조각 번호로도 표시)
- 분류: 위 표의 이름
- 크기: magnitude_mm (3회 평균), single_pass_mm (이번 주행 값)
- 단계: 색 — 정상 초록, 주의 노랑, 위험 빨강, 관찰 중(3회 미만) 회색
- 좌우 높이차일 때만: side (left/right) — 낮은 쪽 레일 표시
- 근거: passes_used (몇 회 평균인지), 한계선 값
- 조치 문구: 위 표의 "운전 조치" 한 줄
