liebe1127/HP028_RailTwin/docs/RailTwin_Progress_Brief.pptx

HP028 RailTwin

하부 레일 변형 예측 기반
갠트리 크레인 디지털 트윈 안전관리

Rail Deformation Prediction for Gantry Crane
Digital Twin Safety Management — Progress Brief

진행 현황 브리프 | Short Status Update | 2026.07

## Slide 2

01 프로젝트 목표 / Project Goal

주행 시 동적 진동·가속도 데이터로 하부 주행 레일의 미세 변형을 사전에 예측·감지한다.
Predict micro-deformation of the lower travel rail from dynamic vibration & acceleration during travel.

※ 거더(상단) 처짐이 아님 — Not girder deflection

단차
Step / Misalignment

침하
Local Settlement

뒤틀림
Twist / Warping

## Slide 3

02 시스템 아키텍처 / System Architecture

• 특징 공학: 웨이블릿(sym3) 디노이징 + 파고율(CREST) → 원시값 직접 입력 금지
Feature eng.: wavelet denoise + crest factor — no raw sensor dump into the model
• 출력 키: PRED_RAIL_DEFORM, CREST, distance_x (WebSocket)
Output keys: PRED_RAIL_DEFORM, CREST, distance_x via WebSocket

Edge
ESP32
센서

Producer
시리얼/
더미

Queue
asyncio

AI
특징공학
+ RBF

View
Web /
Godot

→

→

→

→

## Slide 4

03 Phase별 진행률 / Roadmap Progress

Phase 1
Sensor & Edge

코드 완료 / Code done
실물 검증 남음 / HW validation left

Phase 2
Backend Stream

프로토타입 완료 / Prototype done
MQTT·Redis 향후 / Planned later

Phase 3
AI Model

더미 시연 완료 / Demo verified
실측 재학습 / Retrain on real data

Phase 4
Digital Twin

웹+Godot 스크립트 / Web + GDScript
FBX 씬 연동 / FBX wiring

## Slide 5

04 구현 완료 / What We Built

• 펌웨어: ADXL345 + MPU-6050 + HC-SR04, 0.01g 임계값
Firmware with 0.01g motion gate
• FastAPI 비동기 Queue → InfluxDB / WebSocket
Async queue → InfluxDB / WebSocket
• 시리얼 없을 때 더미 스트리머(10Hz, 40–50cm 위험구간)
Dummy streamer when ESP32 offline

• RBF 대리모델 + 웨이블릿·CREST 특징공학
RBF surrogate + feature pipeline
• 웹 대시보드 실시간 표시
Live web dashboard
• Godot WebSocket 스크립트 (crane/rail path)
Godot WS client for twin scene

## Slide 6

05 시연 & 다음 단계 / Demo & Next

시연 (지금 가능) / Demo Ready

• uvicorn main:app --host 0.0.0.0 --port 8000
Start backend (auto demo_mode without ESP32)
• CREST 정상 ≈1–1.5 / 위험 ≥5
Normal CREST ≈1–1.5 · Danger ≥5
• frontend/index.html 또는 Godot /ws 연결
Open dashboard or connect Godot to /ws

다음 액션 / Next Actions

1. 실물 ESP32 엔드투엔드 검증
End-to-end with real hardware
2. 실측·FEM 데이터로 RBF 재학습
Retrain RBF on real / FEM data
3. Godot FBX Crane/Rail Path 연결
Wire FBX node paths in Godot
4. MQTT + Redis 무선 파이프라인
Migrate to MQTT + Redis

## Slide 7

중간 시연 파이프라인은 동작 중
Demo pipeline is live today

Edge → AI → Web/Godot 연결까지 프로토타입 완료.
Prototype complete from Edge → AI → Web/Godot. Next: real data & 3D scene wiring.

HP028 RailTwin | github.com/liebe1127/HP028_RailTwin
