liebe1127/HP028_RailTwin/docs/dashboard-qr.png

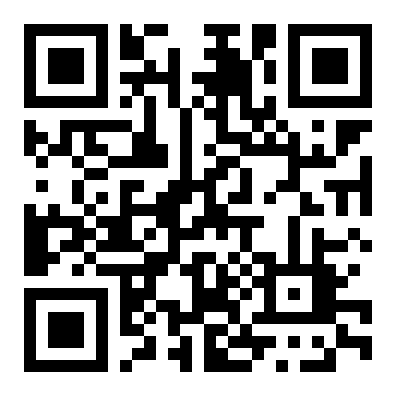
docs/dashboard-qr.png
