liebe1127/HP028_RailTwin/docs/encoder-position-sync-flowchart.png

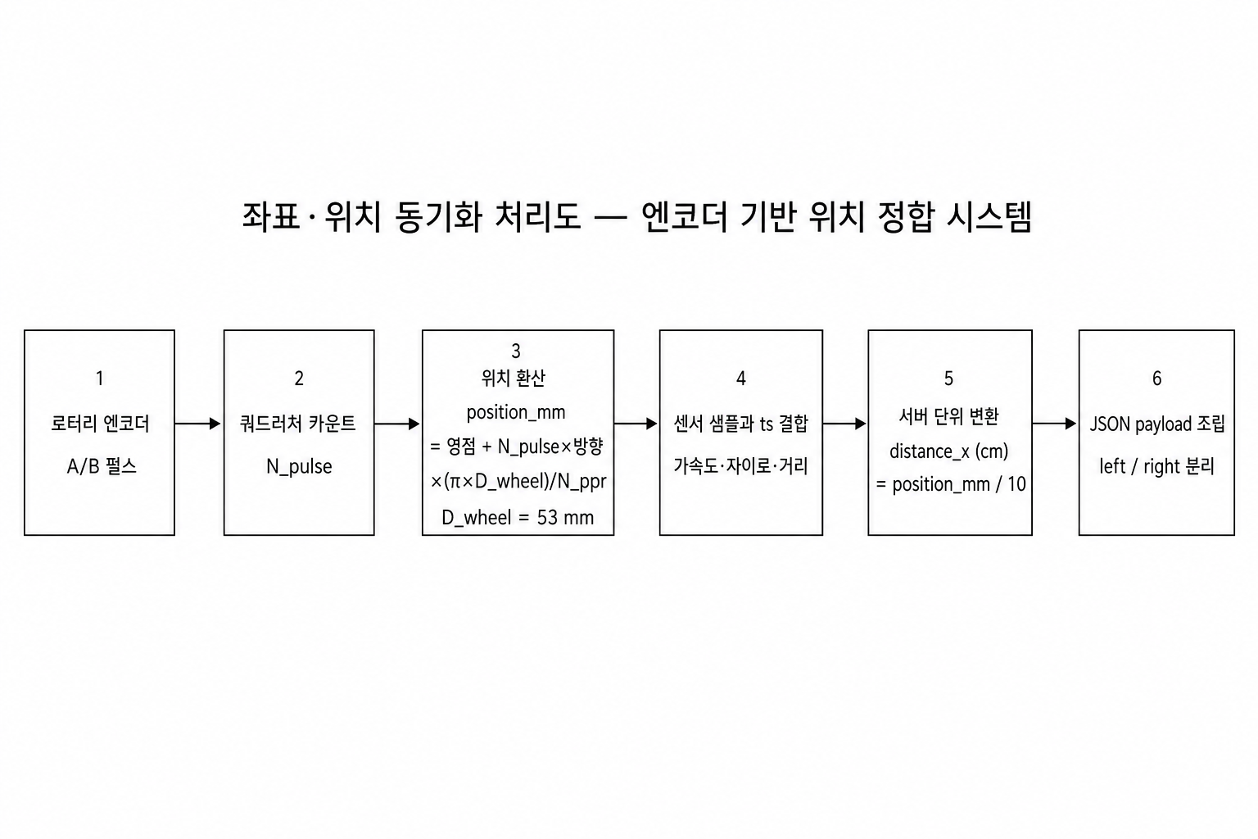
docs/encoder-position-sync-flowchart.png
