liebe1127/HP028_RailTwin/docs/fastapi-terminal-log-capture.png

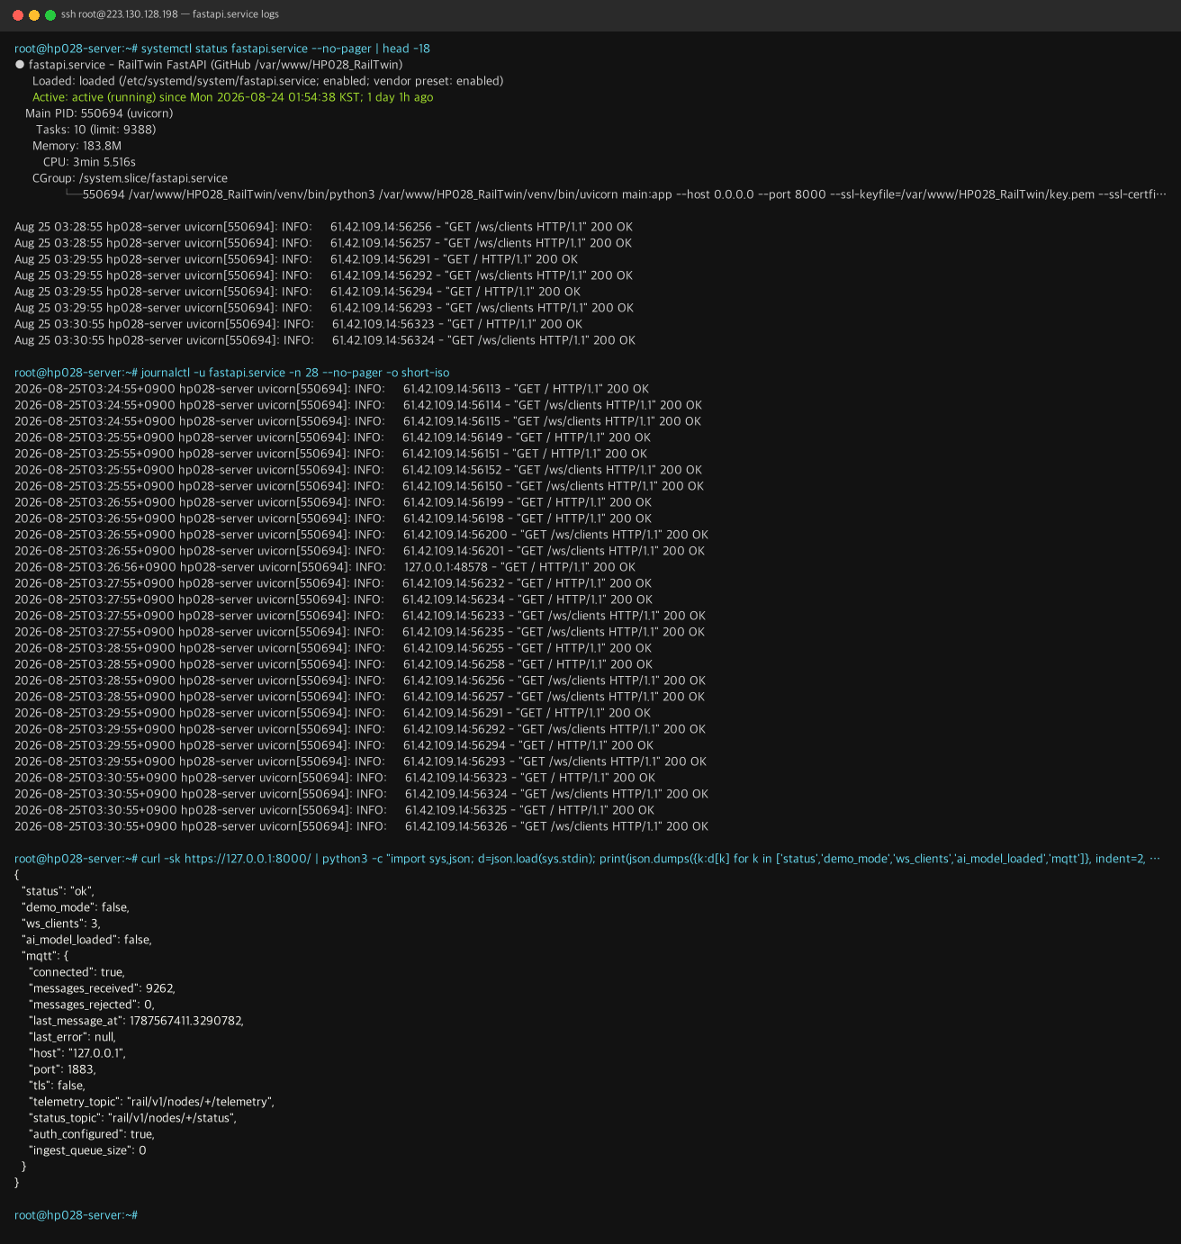
docs/fastapi-terminal-log-capture.png
