liebe1127/HP028_RailTwin/docs/hw-architecture-flowchart.png

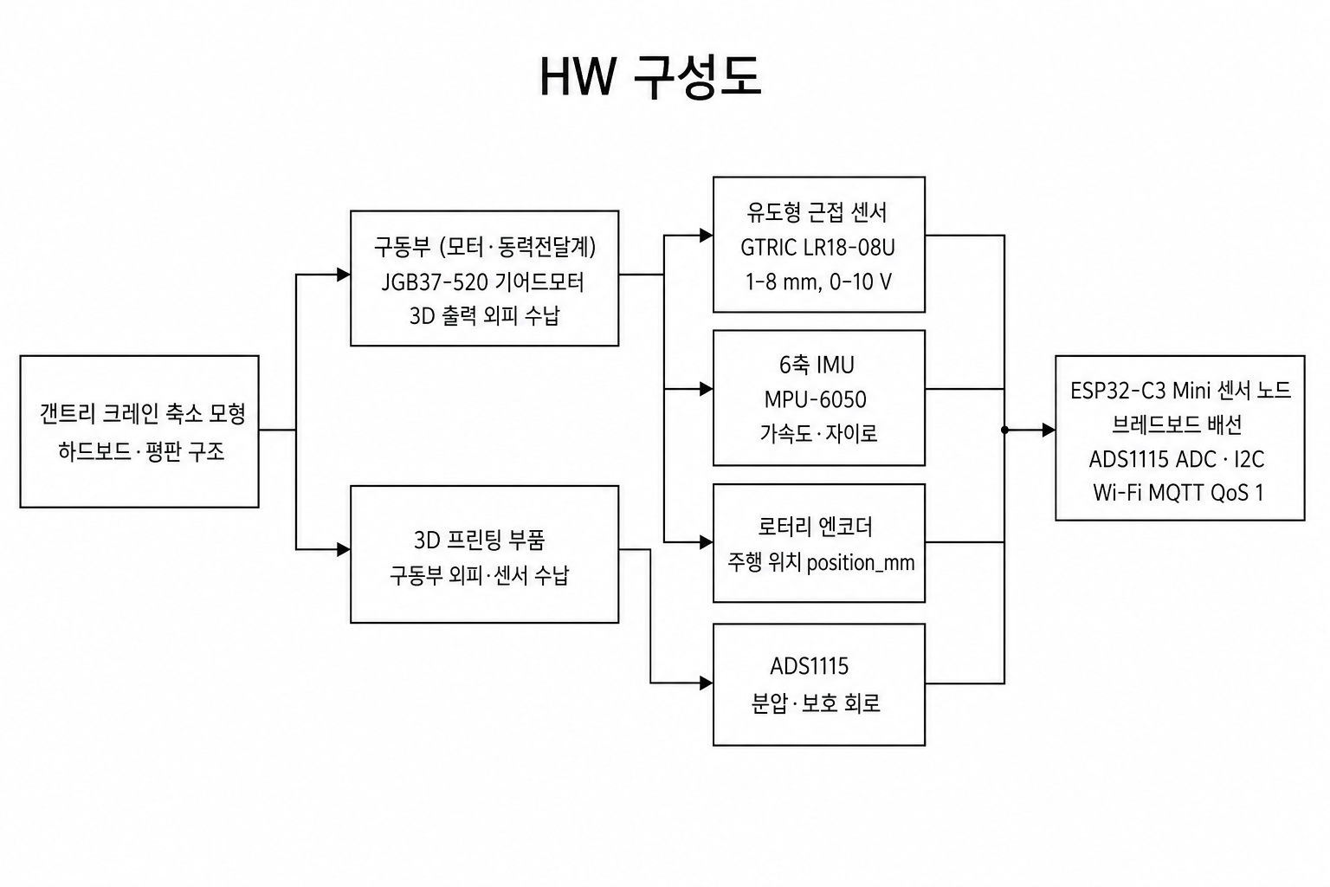
docs/hw-architecture-flowchart.png
