liebe1127/HP028_RailTwin/docs/multimodal-sensing-flowchart.png

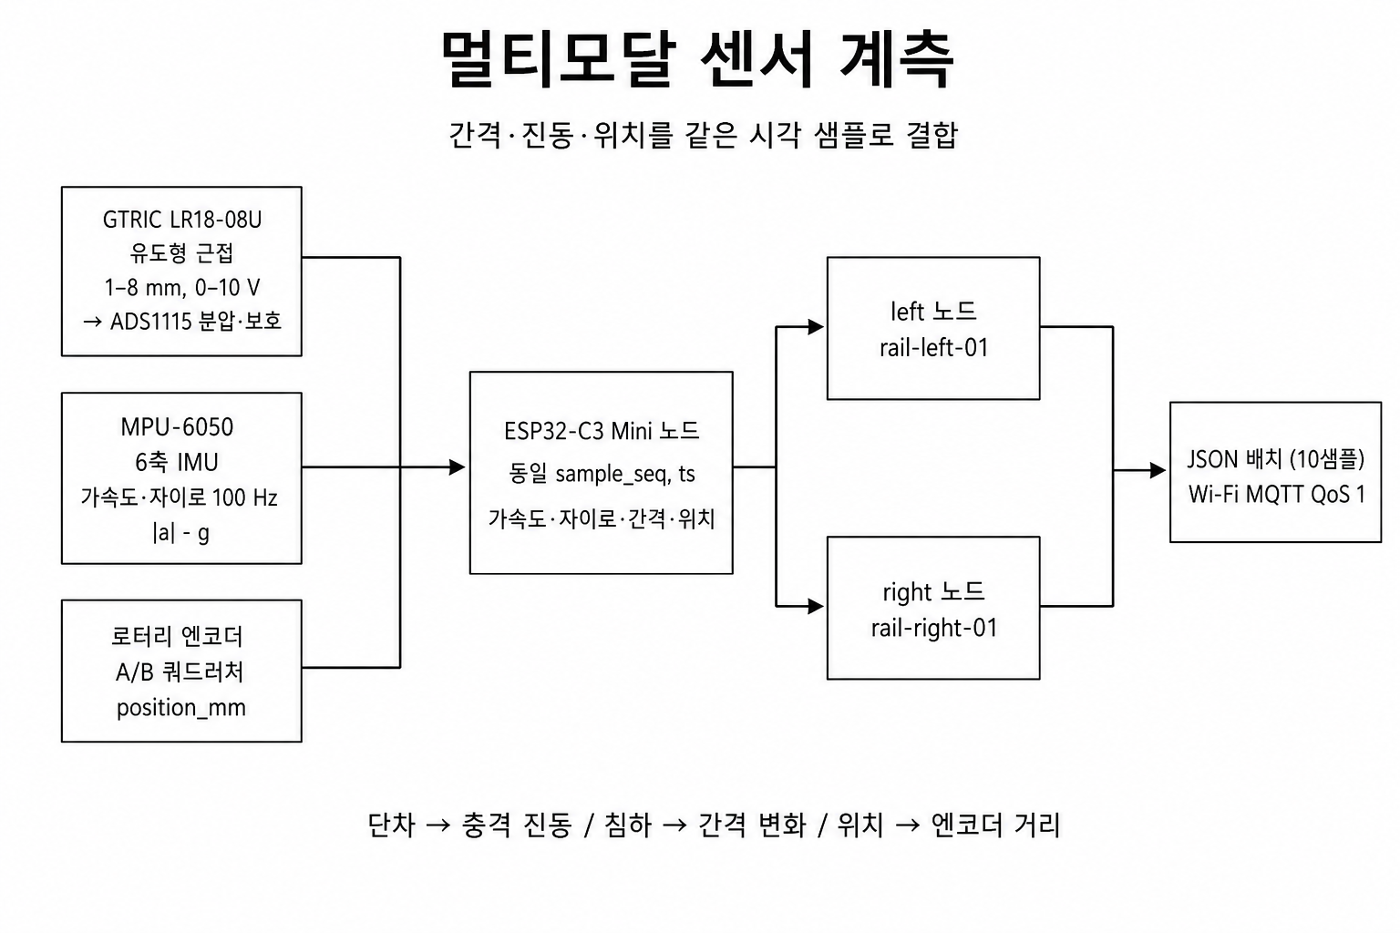
docs/multimodal-sensing-flowchart.png
