liebe1127/HP028_RailTwin/docs/position-matched-digital-twin.png

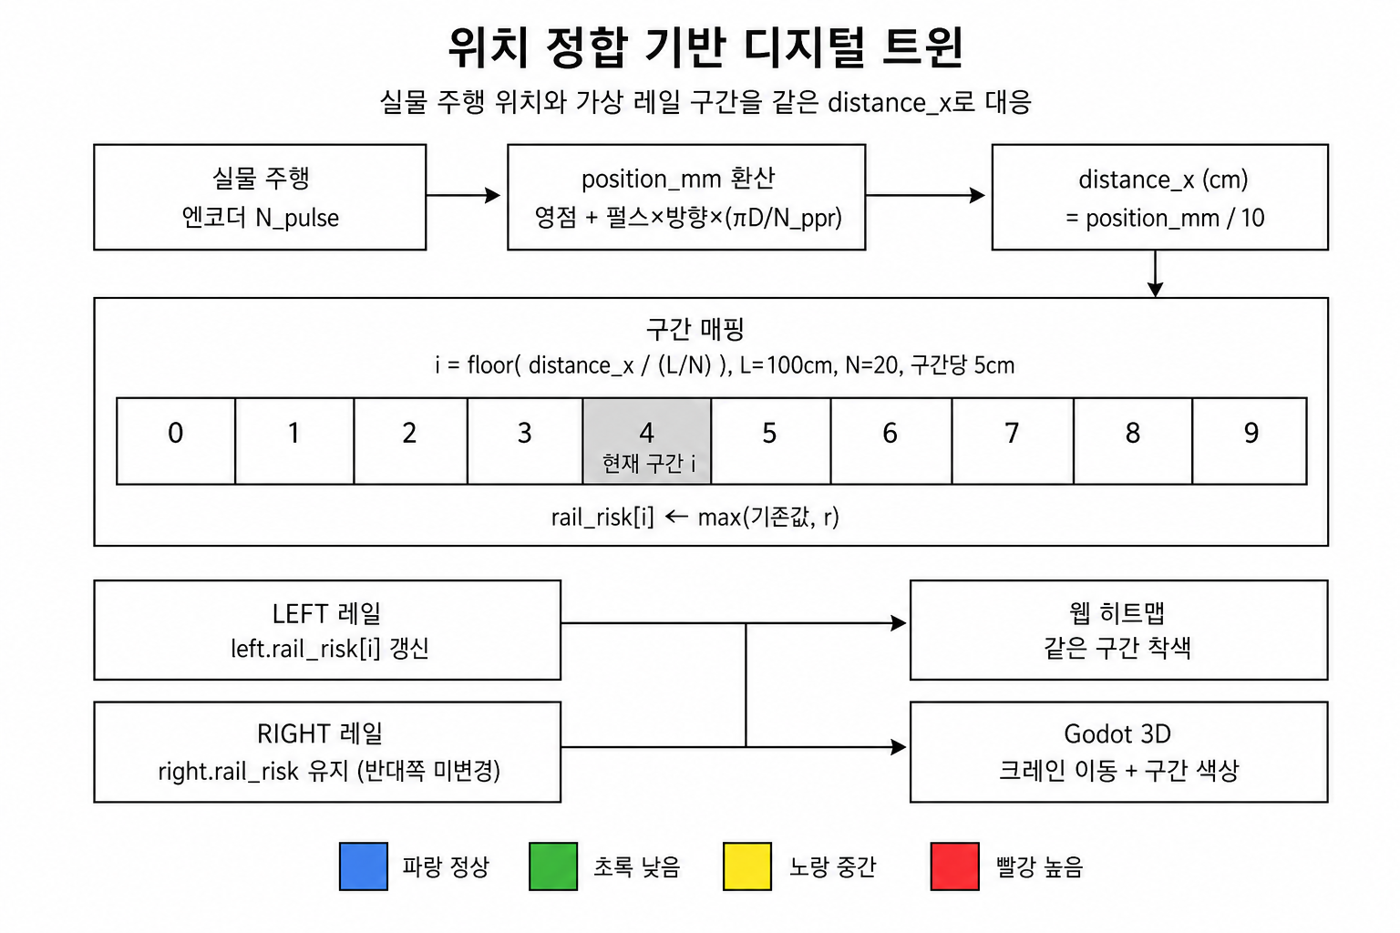
docs/position-matched-digital-twin.png
