liebe1127/HP028_RailTwin/docs/rbf-ai-pipeline-diagram.png

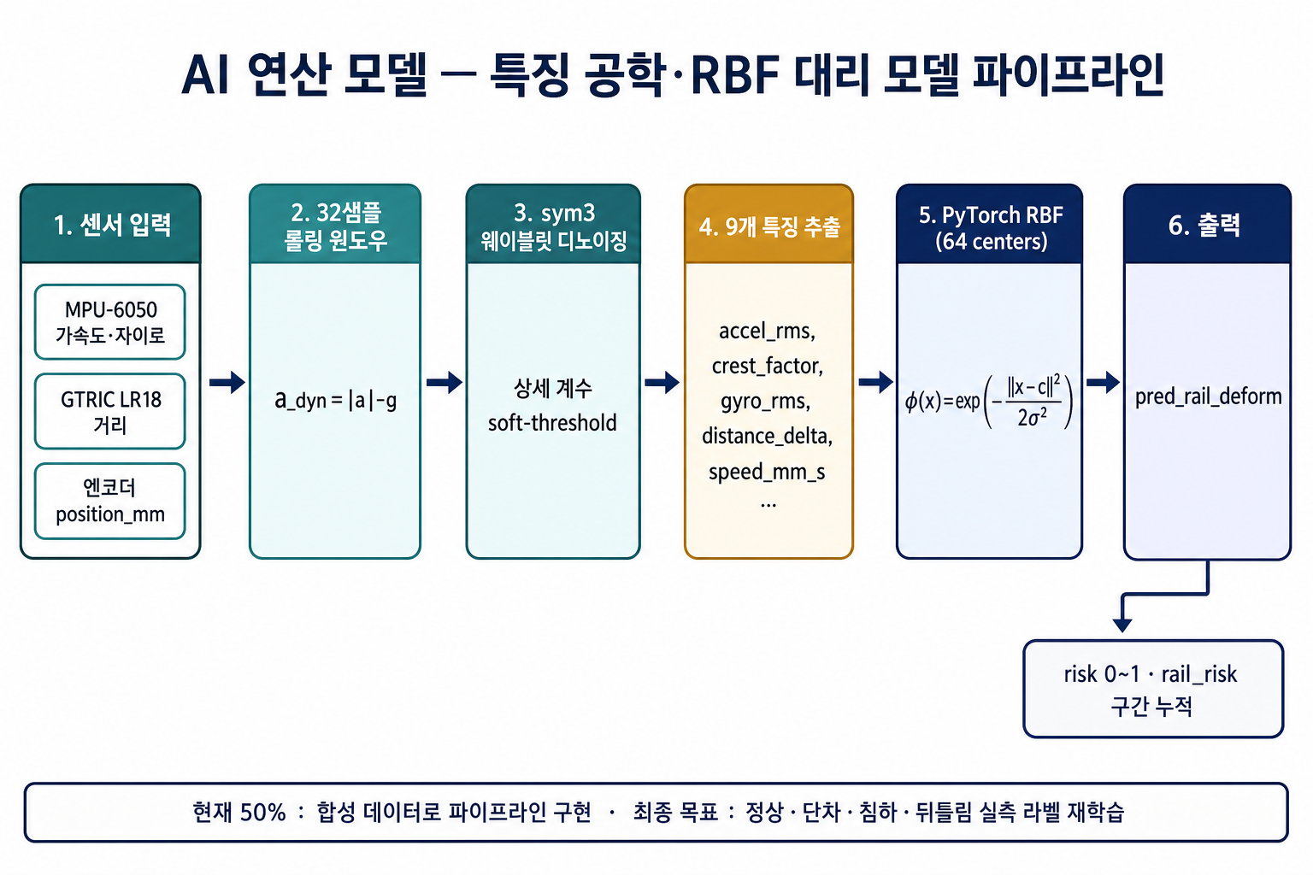
docs/rbf-ai-pipeline-diagram.png
