liebe1127/HP028_RailTwin/docs/rbf-synthetic-feature-comparison.png

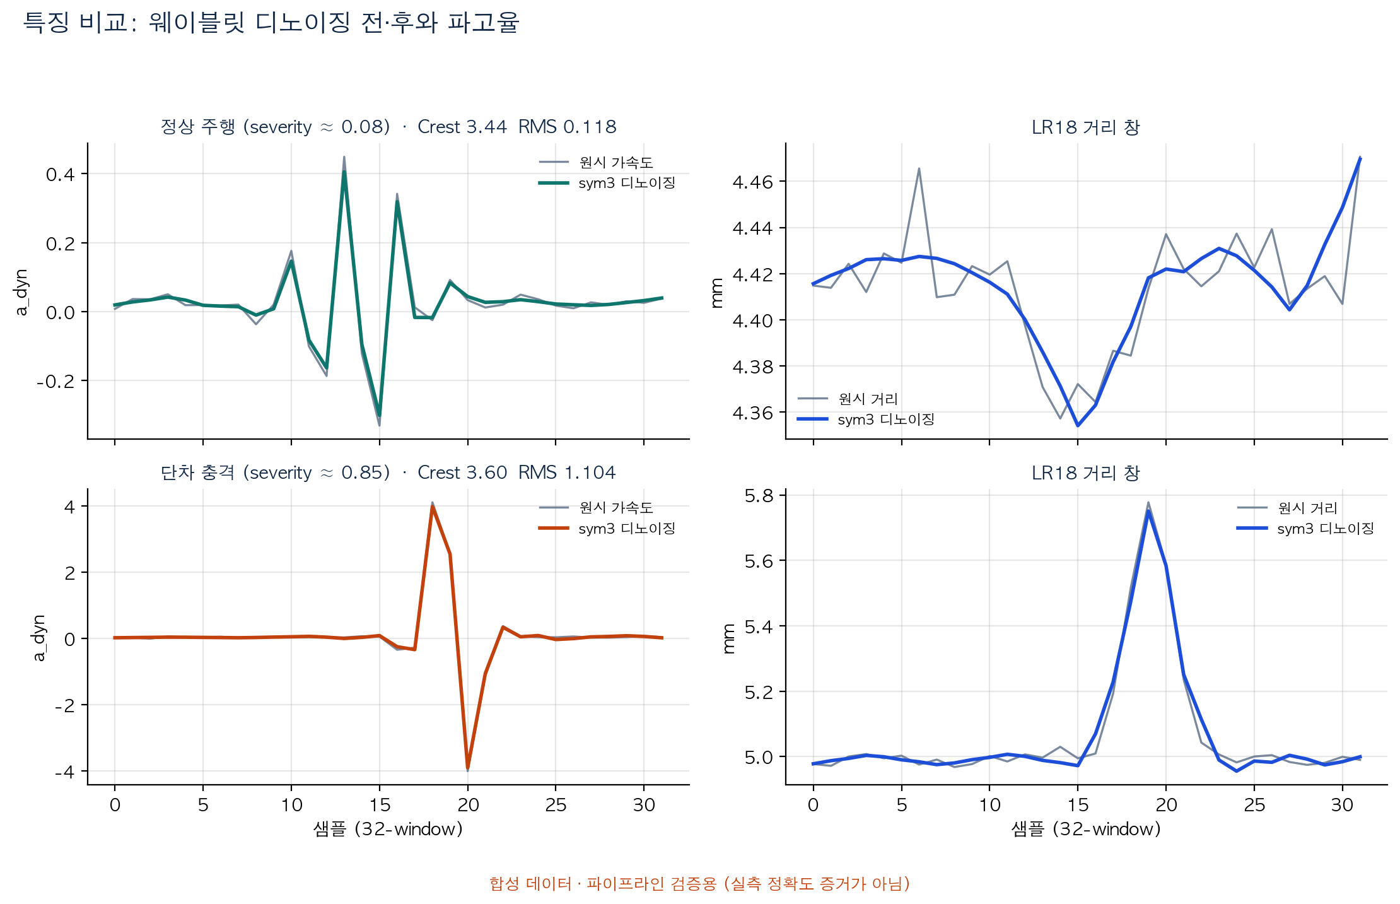
docs/rbf-synthetic-feature-comparison.png
