liebe1127/HP028_RailTwin/docs/rbf-synthetic-feature-distributions.png

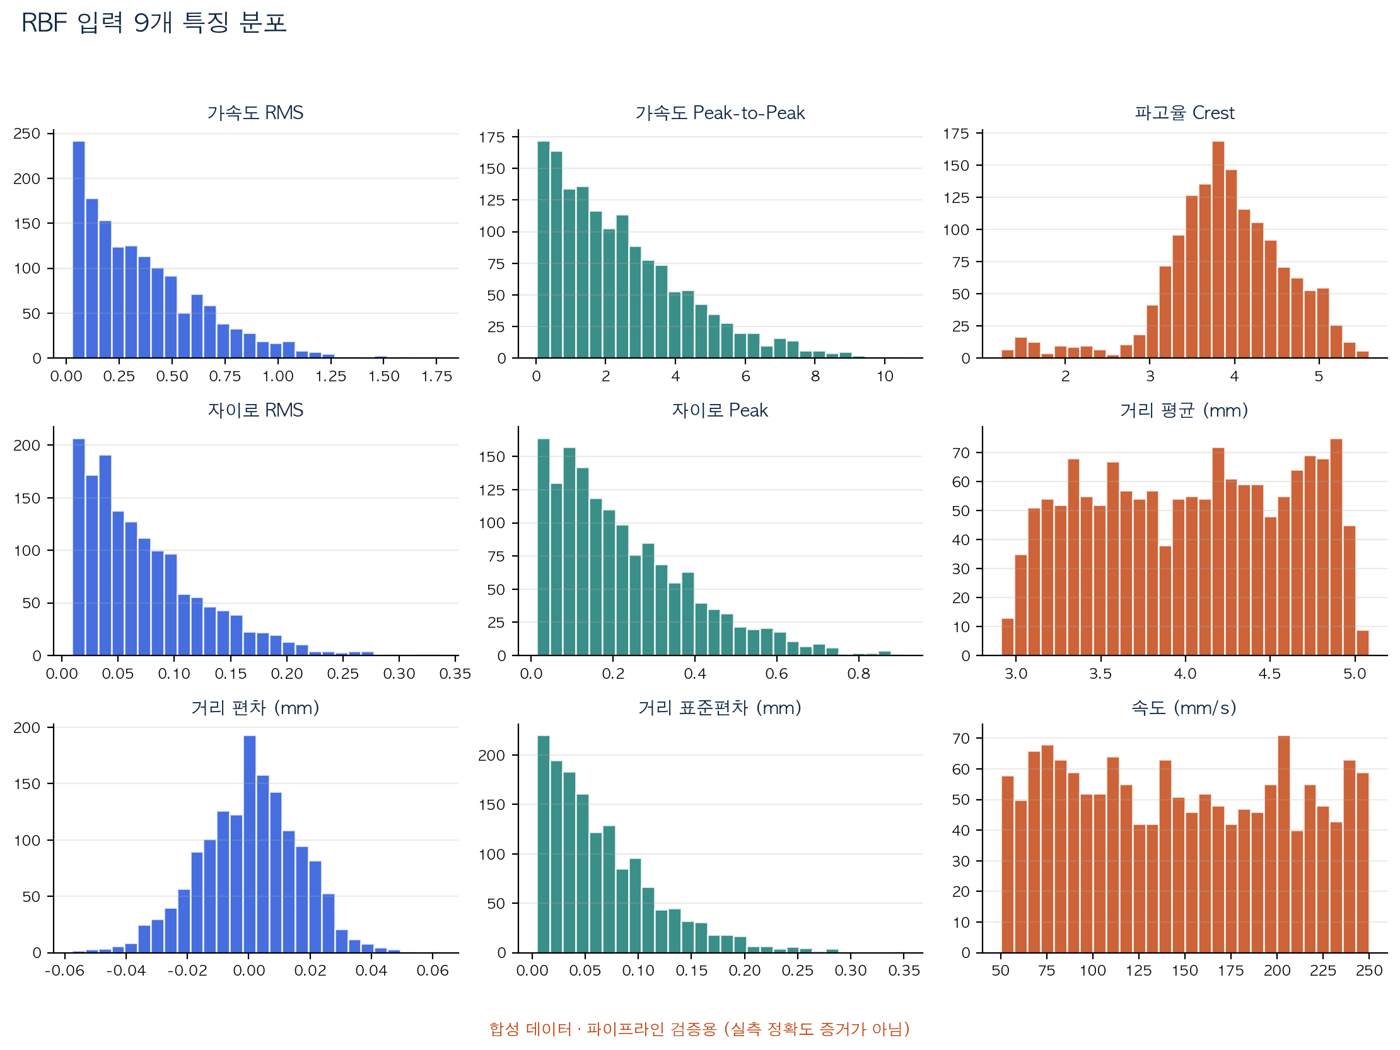
docs/rbf-synthetic-feature-distributions.png
