liebe1127/HP028_RailTwin/docs/rbf-synthetic-loss-curve.png

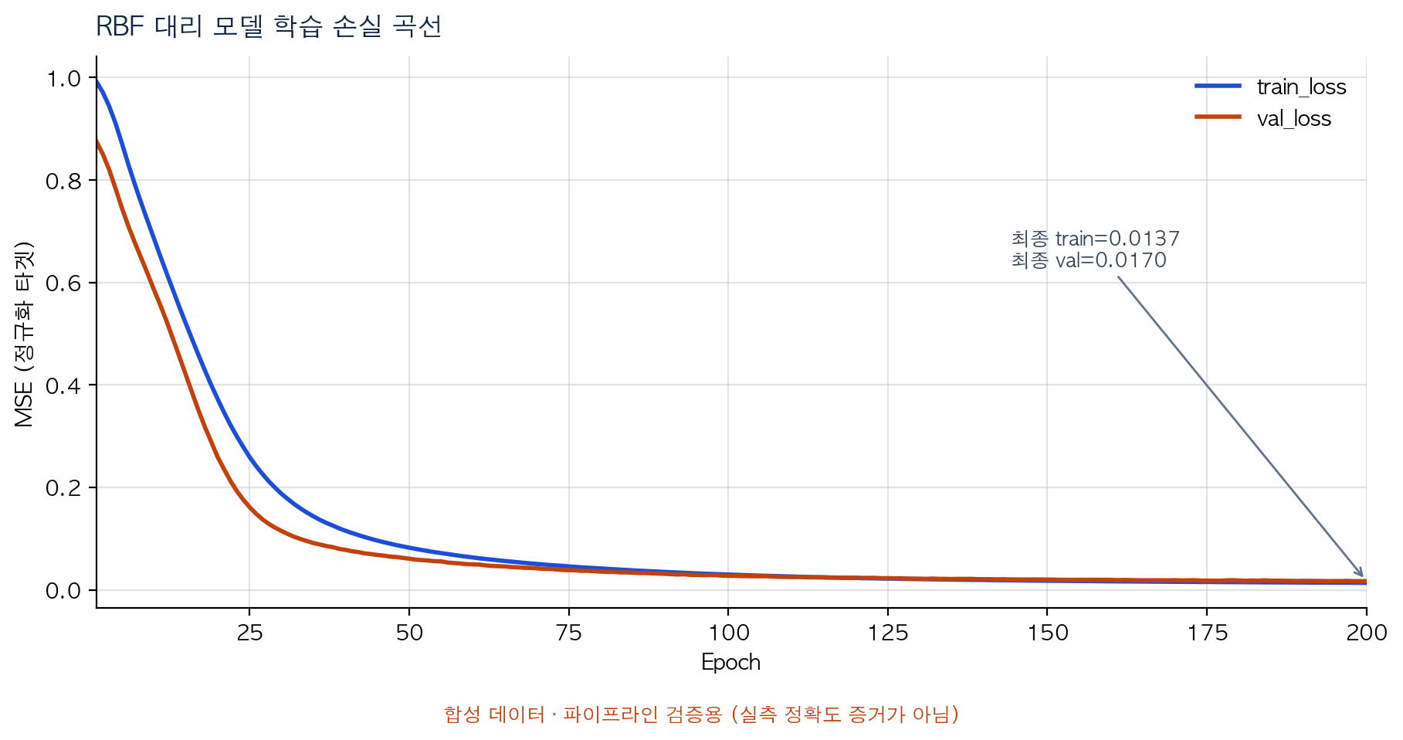
docs/rbf-synthetic-loss-curve.png
