liebe1127/HP028_RailTwin/docs/rbf-synthetic-pred-vs-target.png

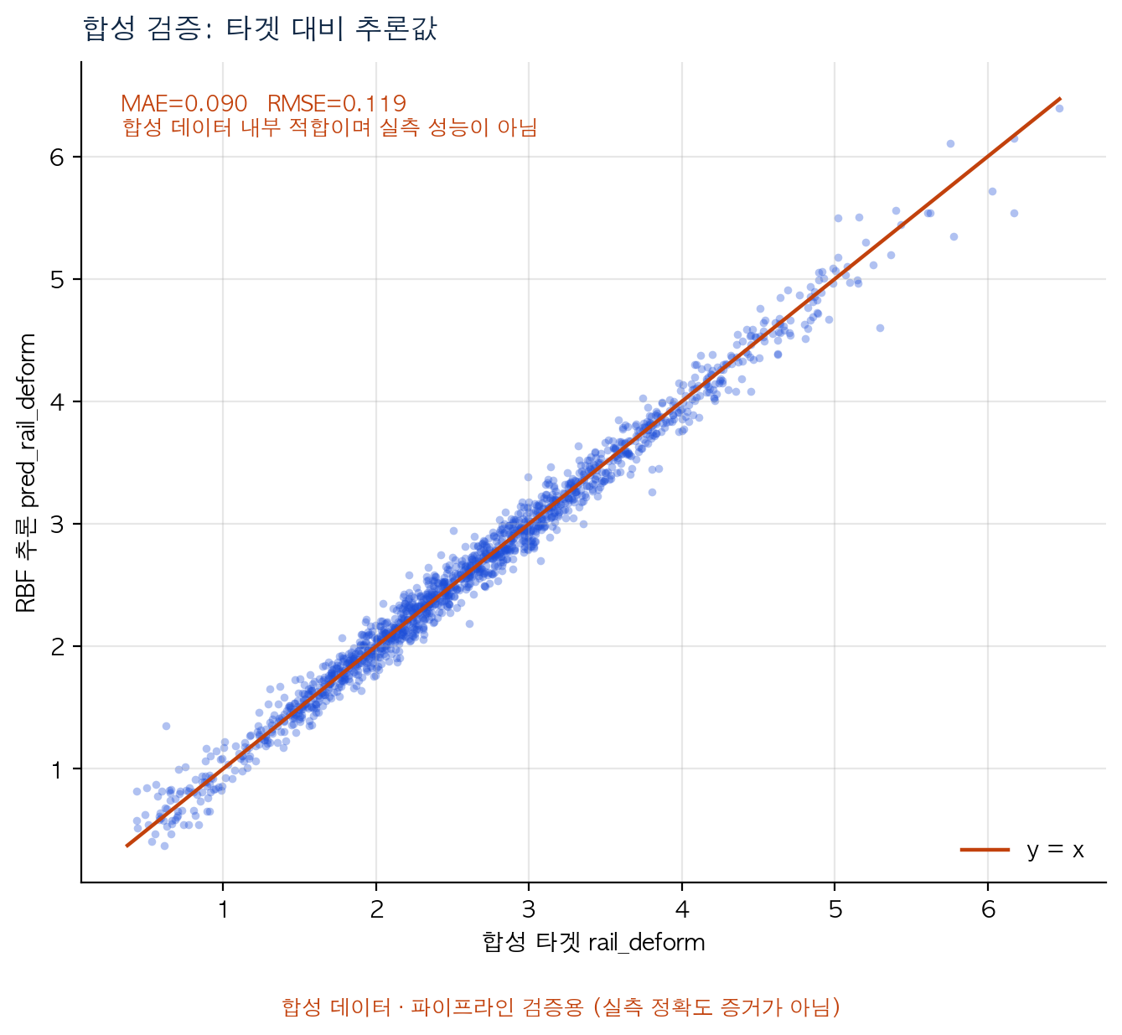
docs/rbf-synthetic-pred-vs-target.png
