liebe1127/HP028_RailTwin/docs/rbf-synthetic-training-evidence.png

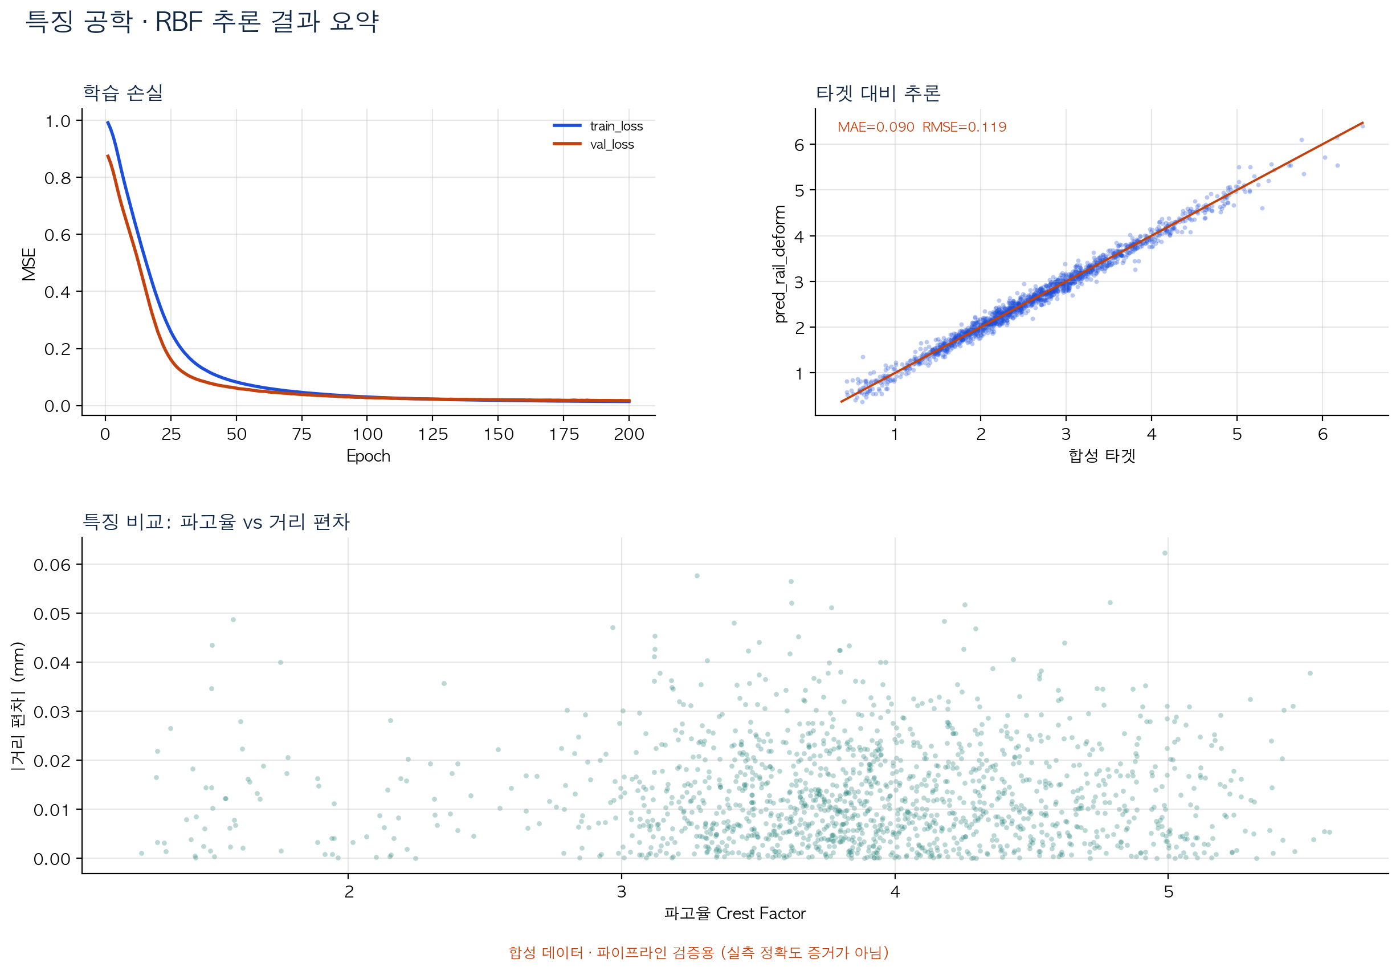
docs/rbf-synthetic-training-evidence.png
