liebe1127/HP028_RailTwin/docs/rbf-synthetic-training-log.png

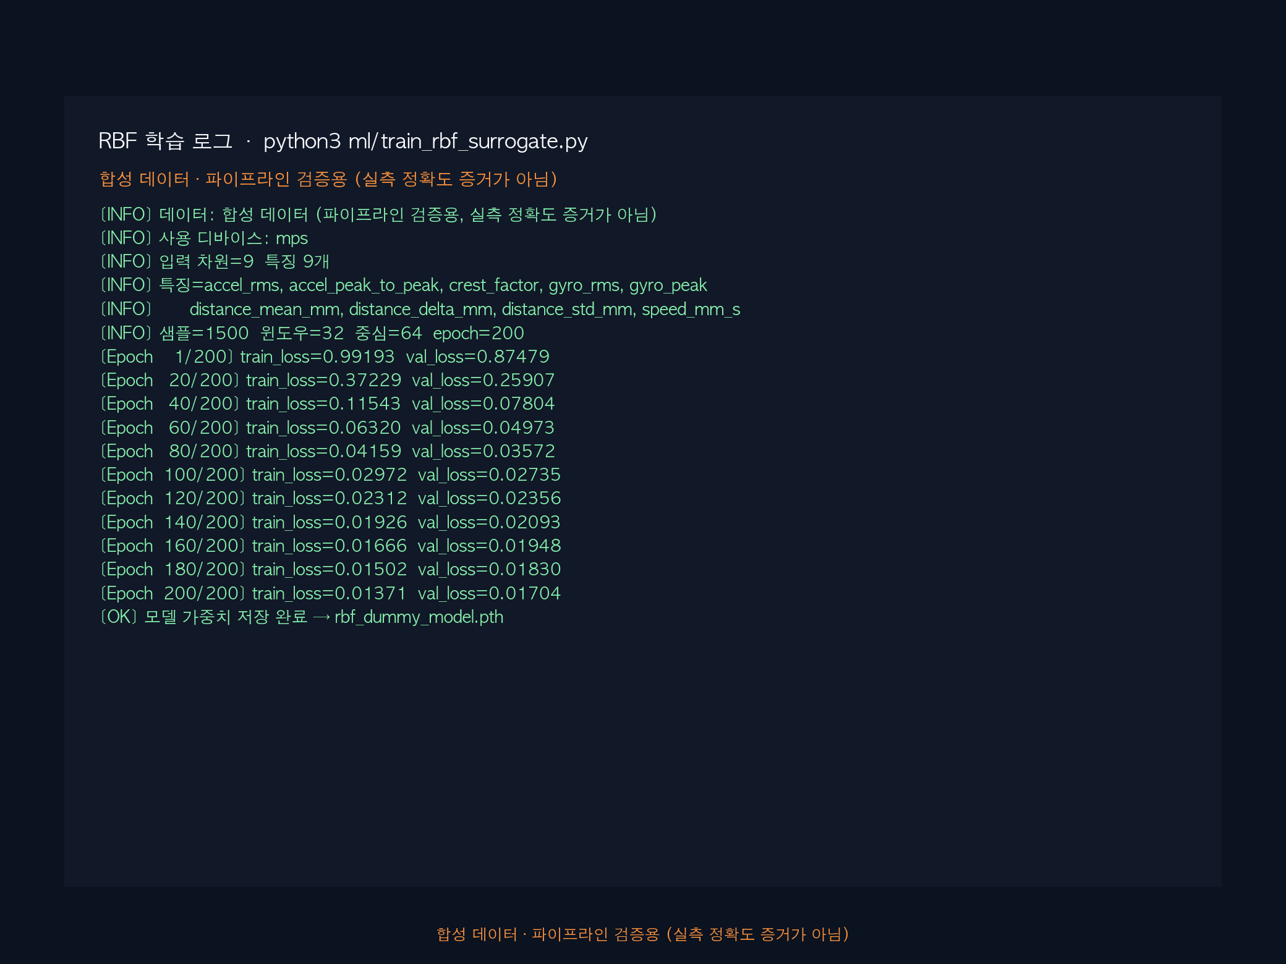
docs/rbf-synthetic-training-log.png
