liebe1127/HP028_RailTwin/docs/ref-images/02-hamburg-cta.jpg

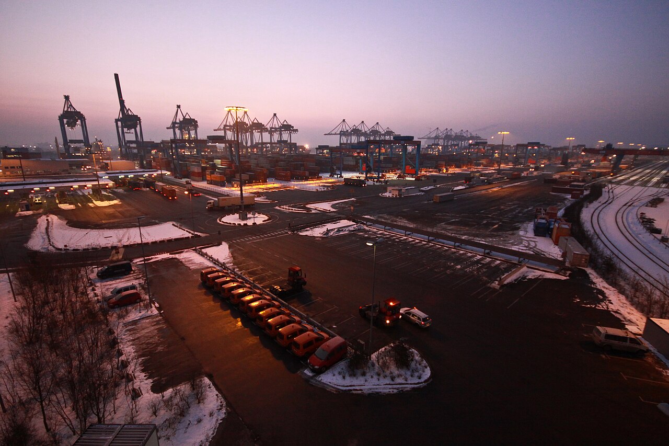
docs/ref-images/02-hamburg-cta.jpg
