liebe1127/HP028_RailTwin/docs/ref-images/03-pnit-dt-b.png

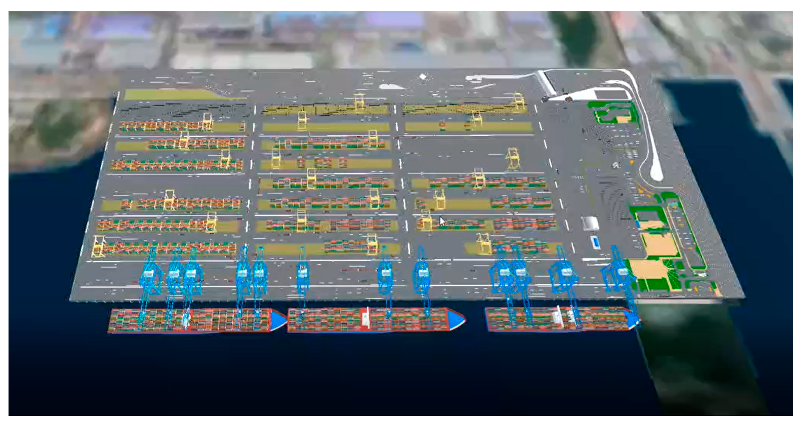
docs/ref-images/03-pnit-dt-b.png
