liebe1127/HP028_RailTwin/docs/ref-images/04-abb-smart-sensor.jpg

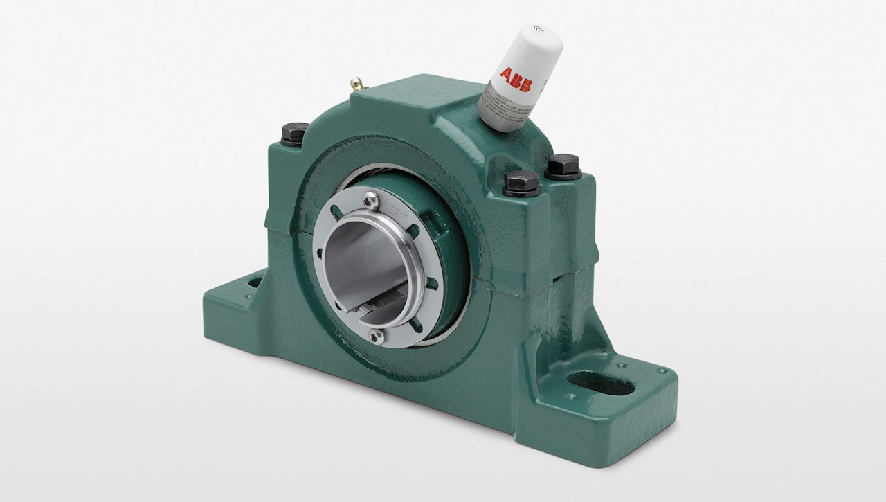
docs/ref-images/04-abb-smart-sensor.jpg
