liebe1127/HP028_RailTwin/docs/signal-processing-pipeline-flowchart.png

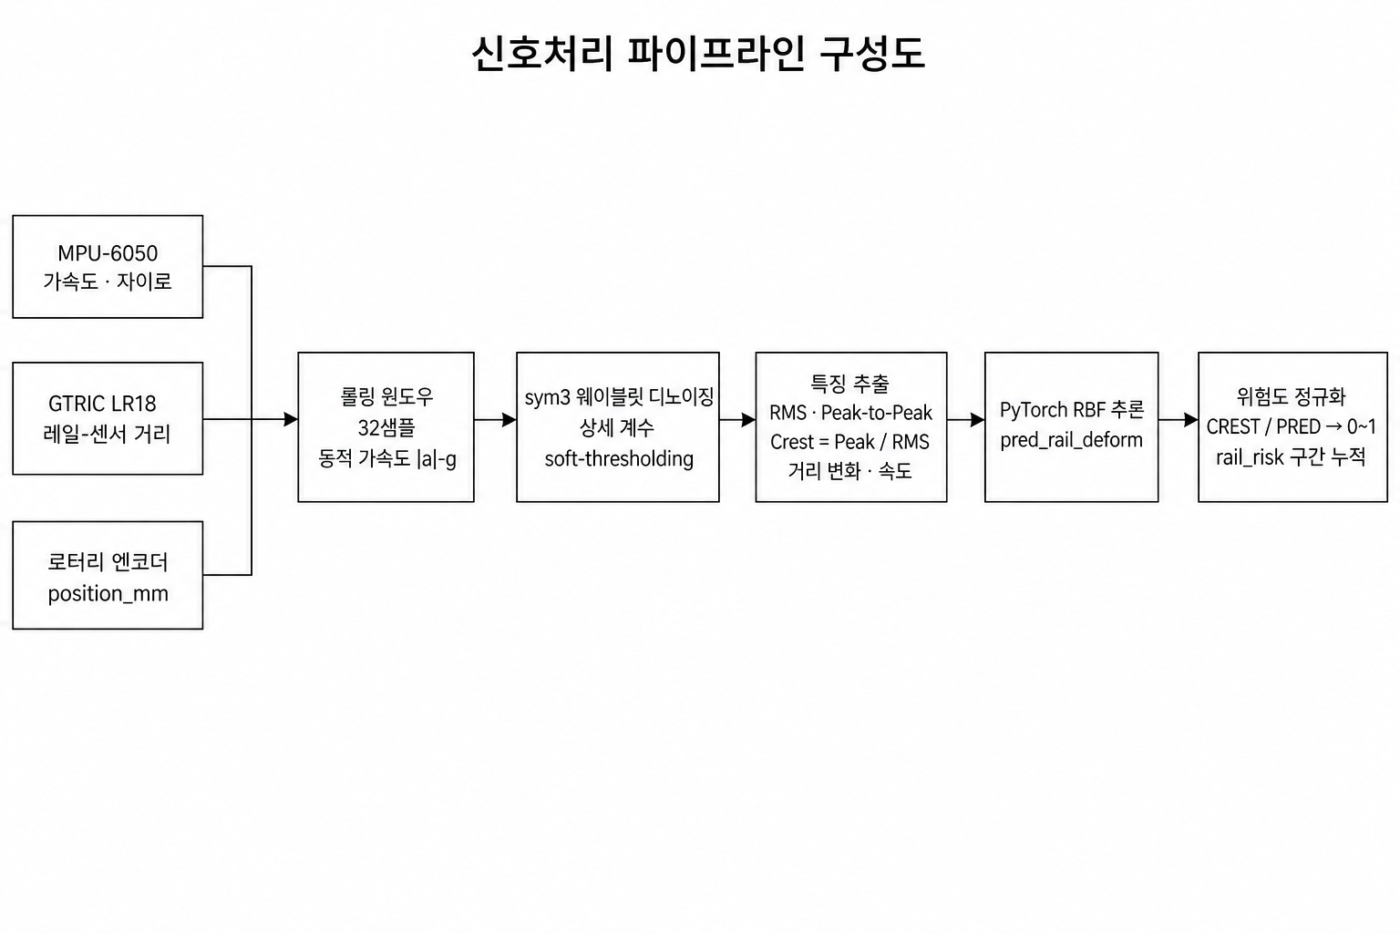
docs/signal-processing-pipeline-flowchart.png
