liebe1127/HP028_RailTwin/docs/sw-architecture-flowchart.png

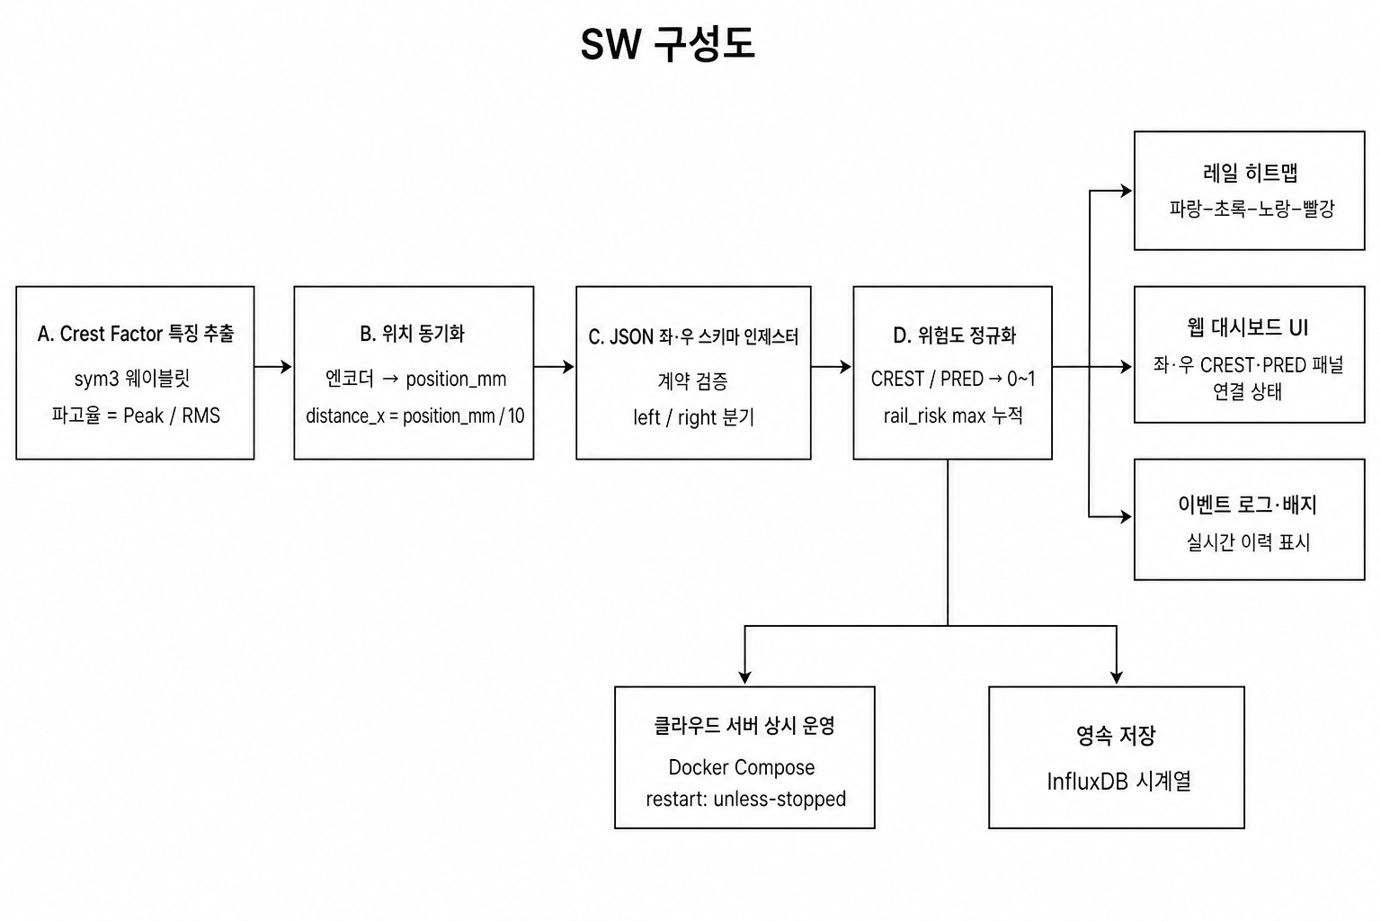
docs/sw-architecture-flowchart.png
