liebe1127/HP028_RailTwin/docs/system-architecture-flowchart.png

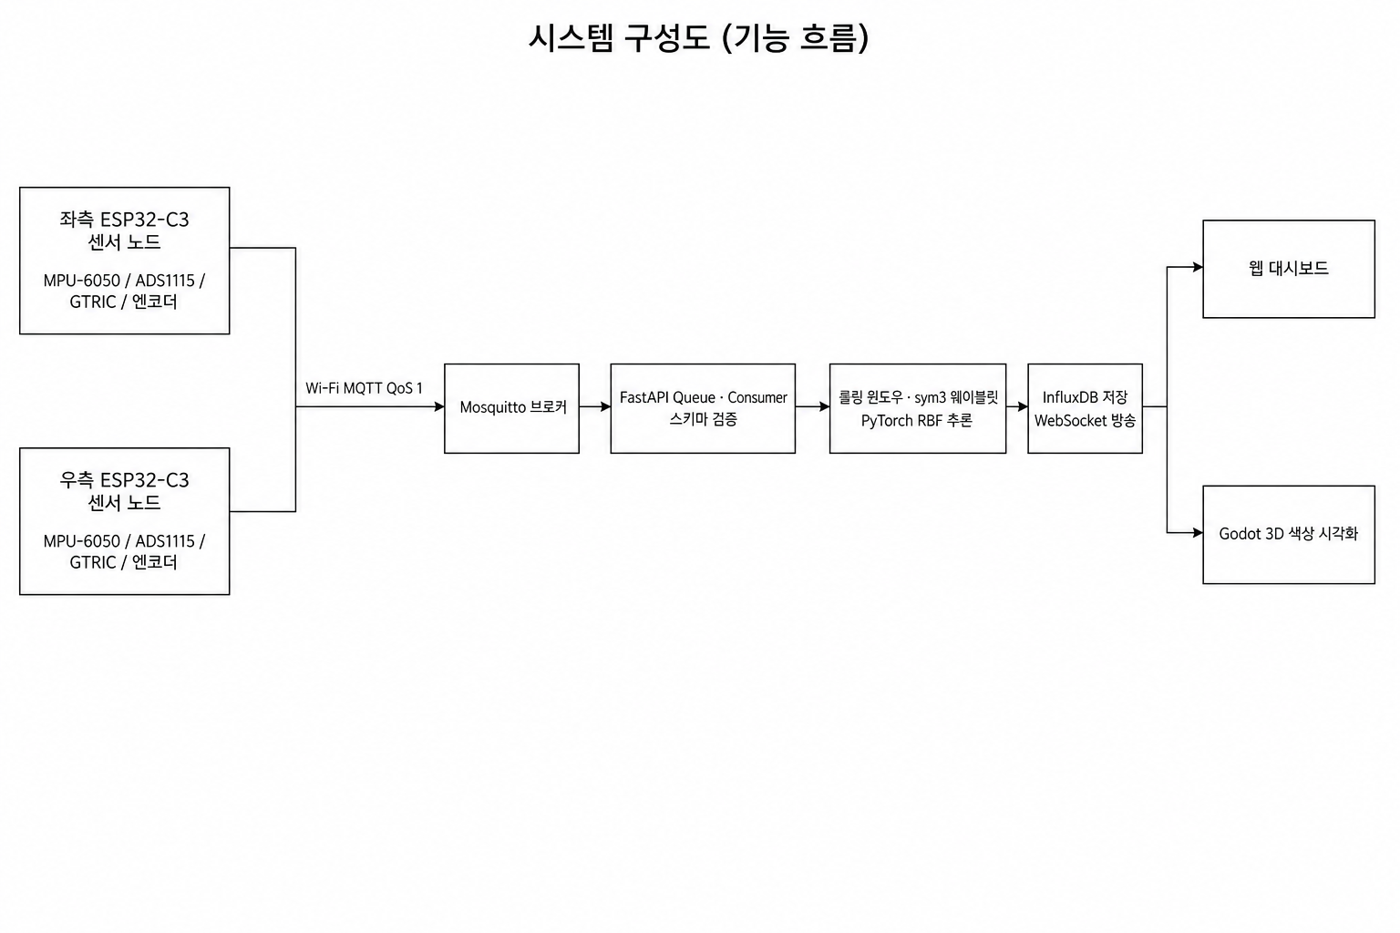
docs/system-architecture-flowchart.png
