liebe1127/HP028_RailTwin/docs/system-architecture-overview.png

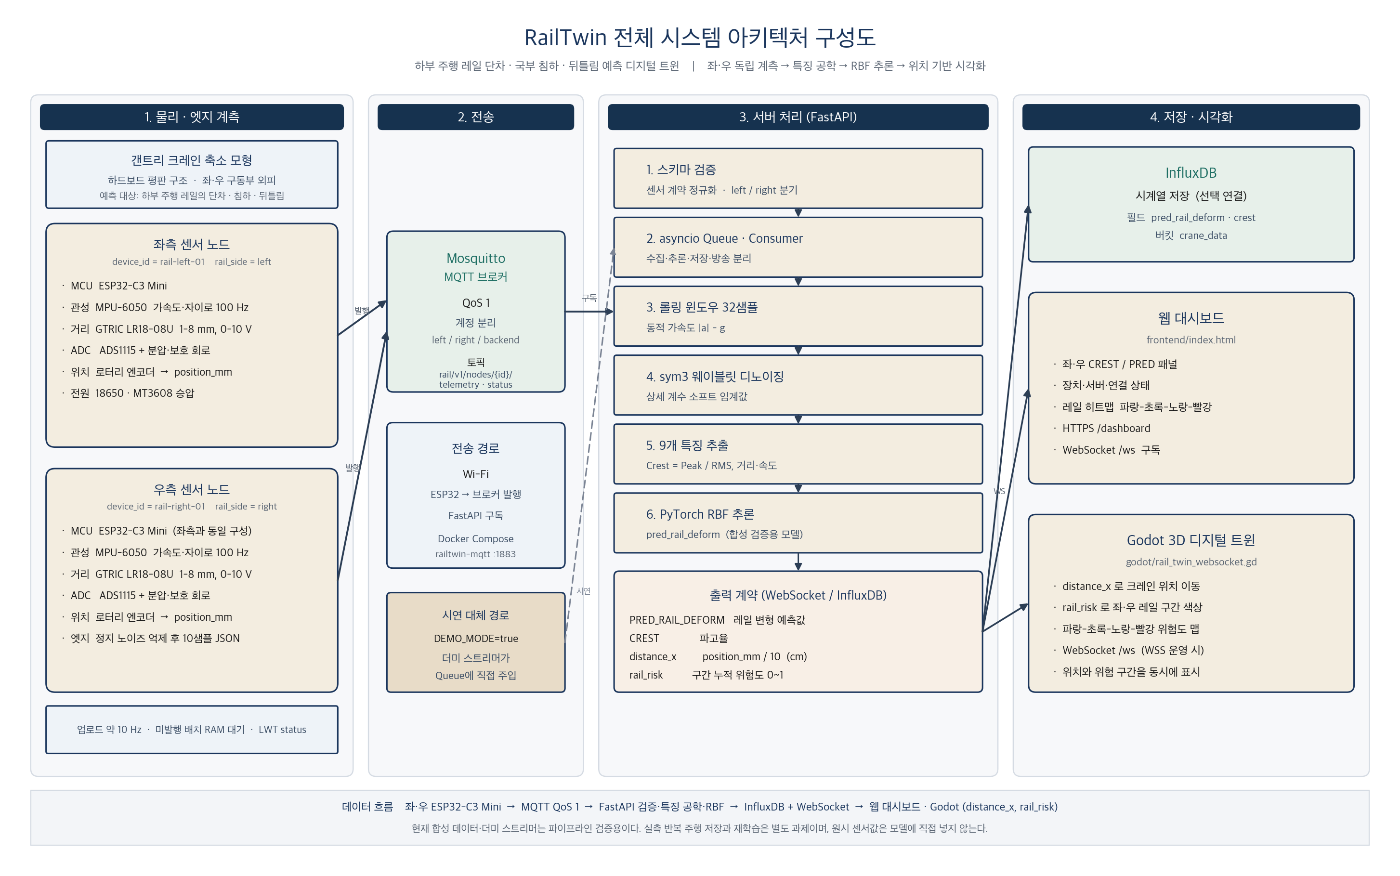
docs/system-architecture-overview.png
