liebe1127/HP028_RailTwin/docs/system-architecture.png

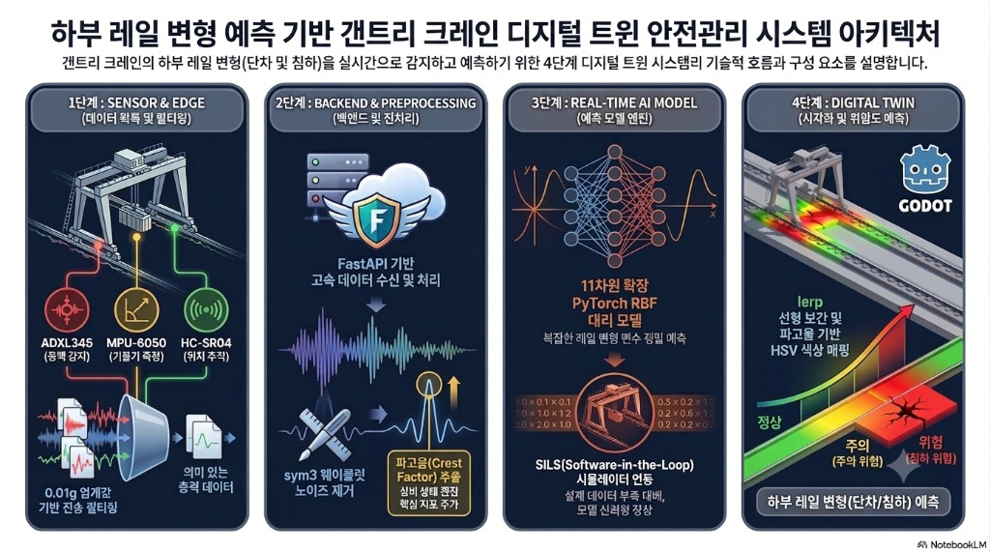
docs/system-architecture.png
