liebe1127/HP028_RailTwin/docs/wavelet-crest-flowchart.png

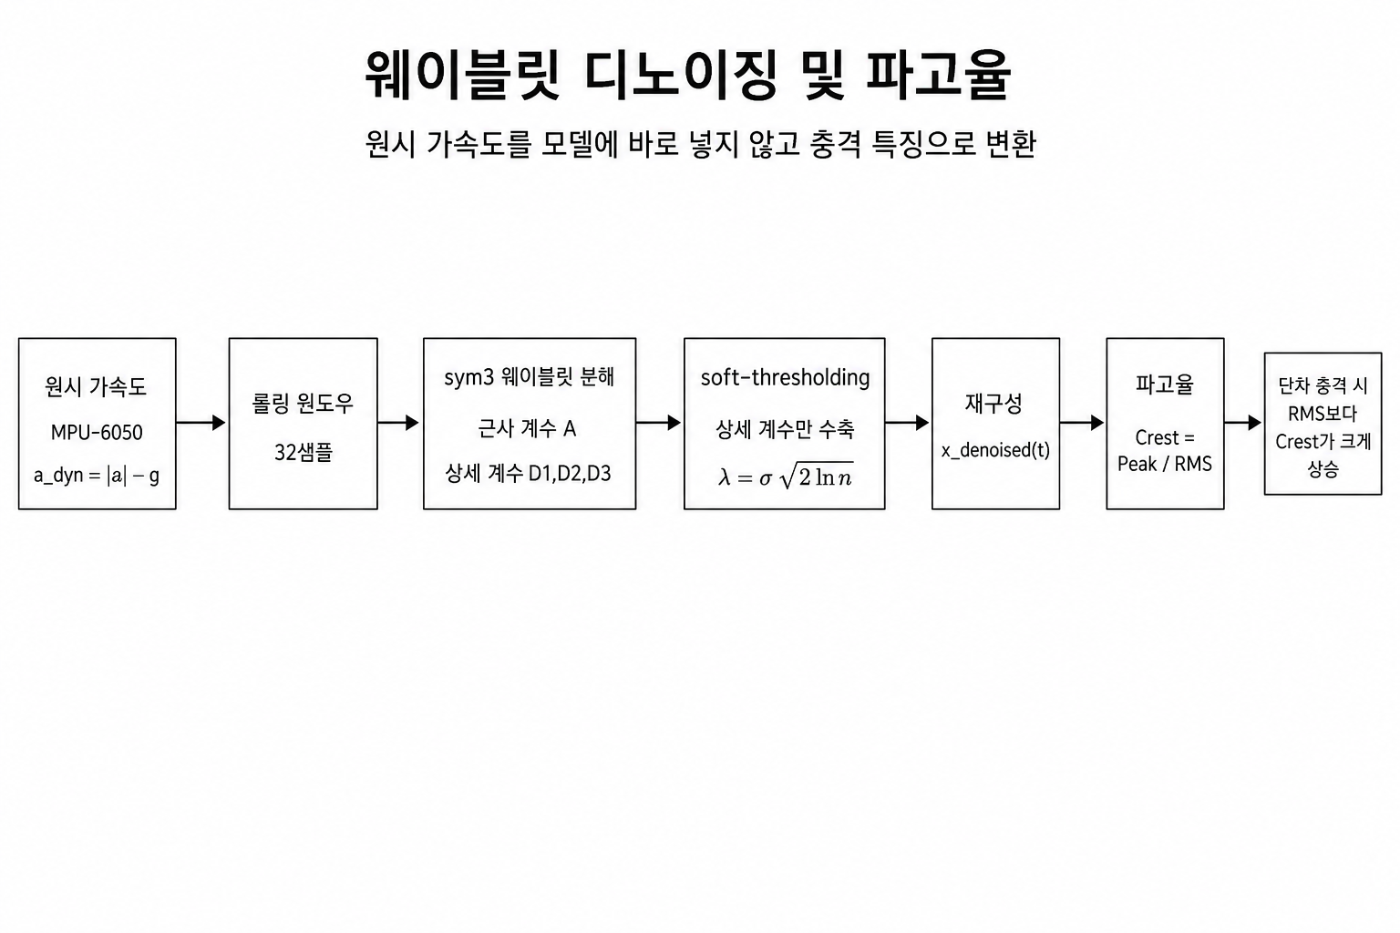
docs/wavelet-crest-flowchart.png
