liebe1127/HP028_RailTwin/docs/web-dashboard-flow-flowchart.png

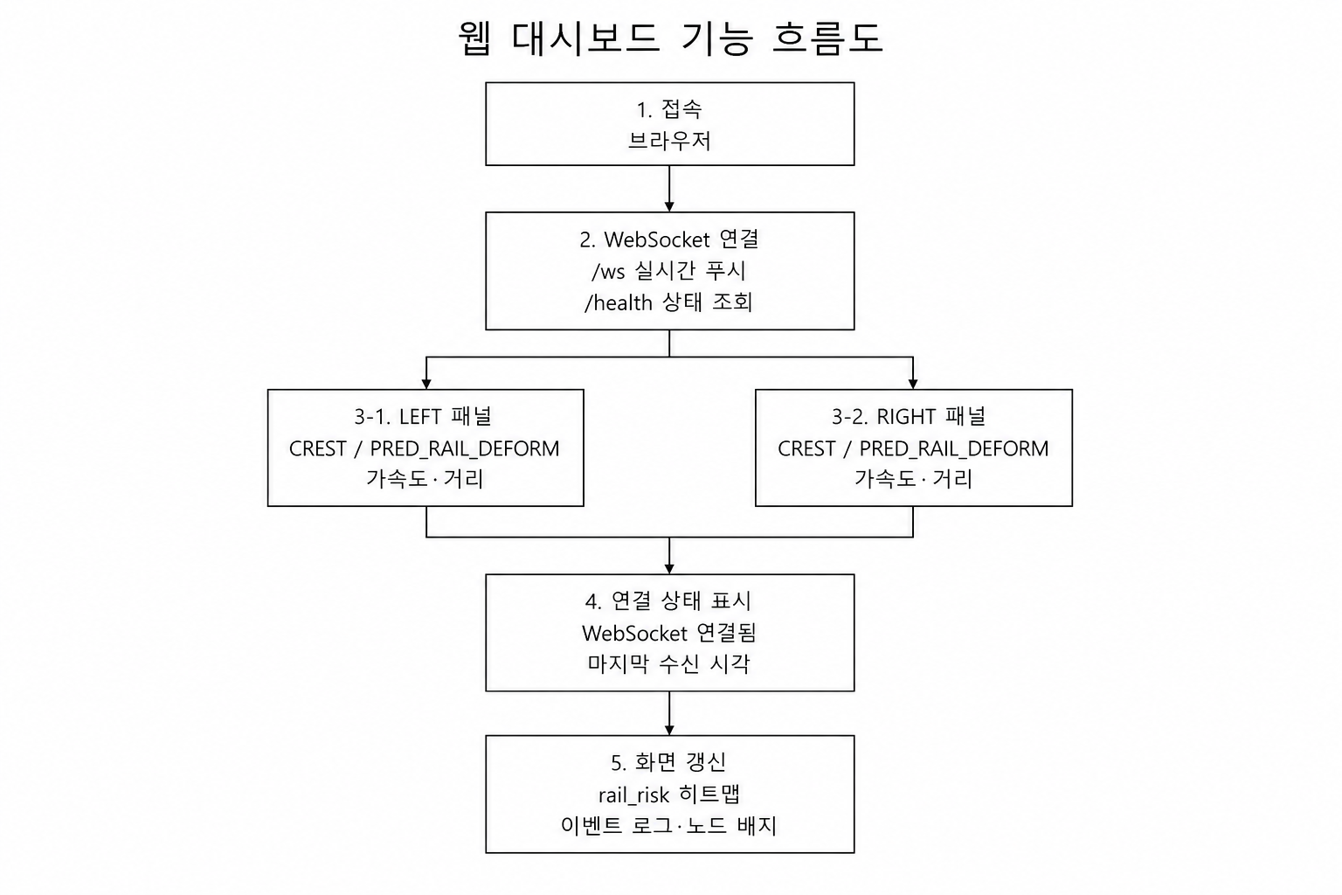
docs/web-dashboard-flow-flowchart.png
