liebe1127/HP028_RailTwin/docs/결함모양-01-정상-옆.png

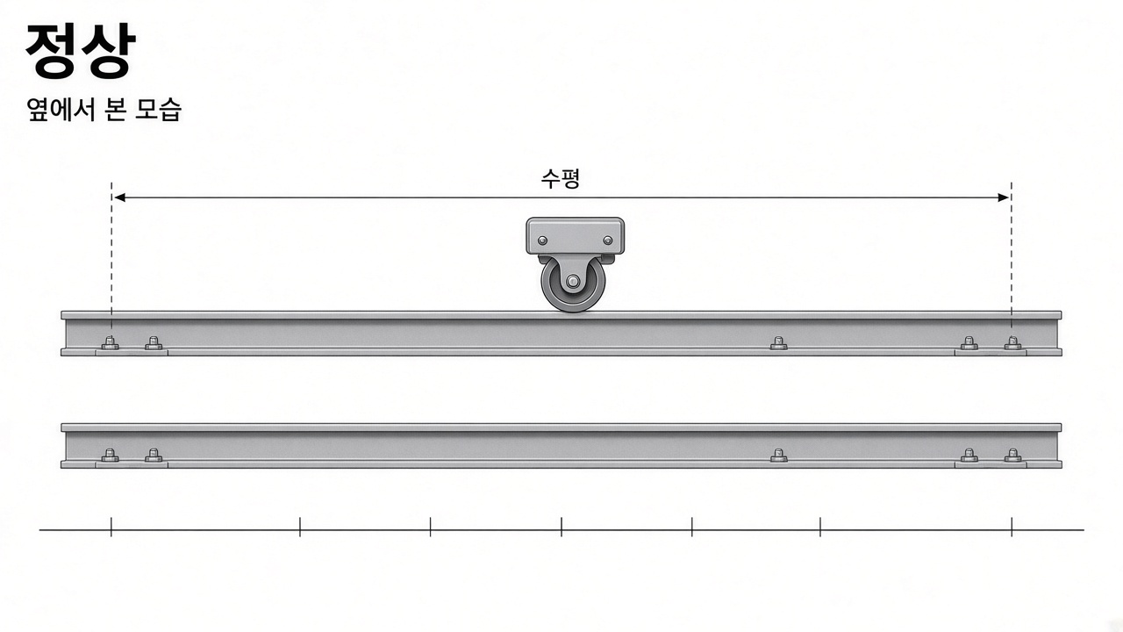
docs/결함모양-01-정상-옆.png
