liebe1127/HP028_RailTwin/docs/결함모양-02-이음부단차-옆.png

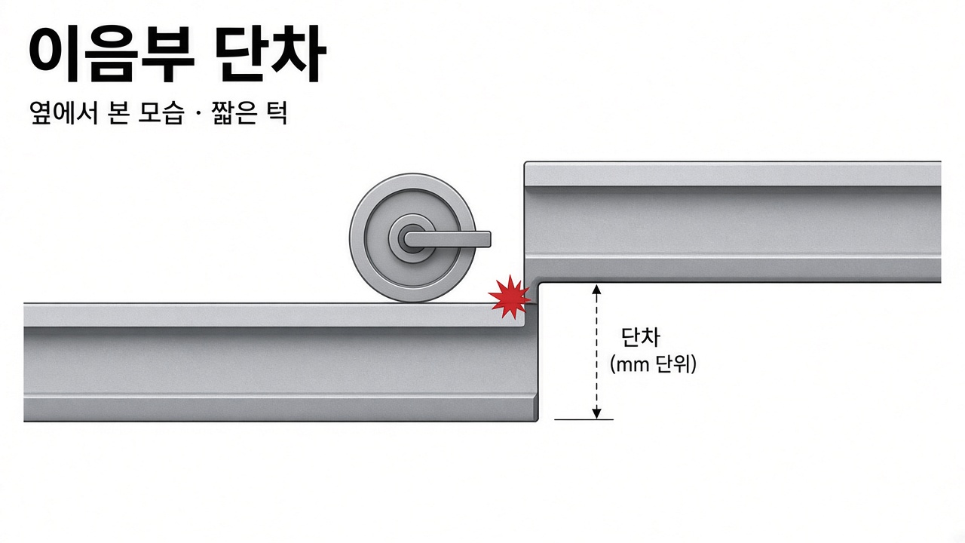
docs/결함모양-02-이음부단차-옆.png
