liebe1127/HP028_RailTwin/docs/결함모양-03-수직변형-옆.png

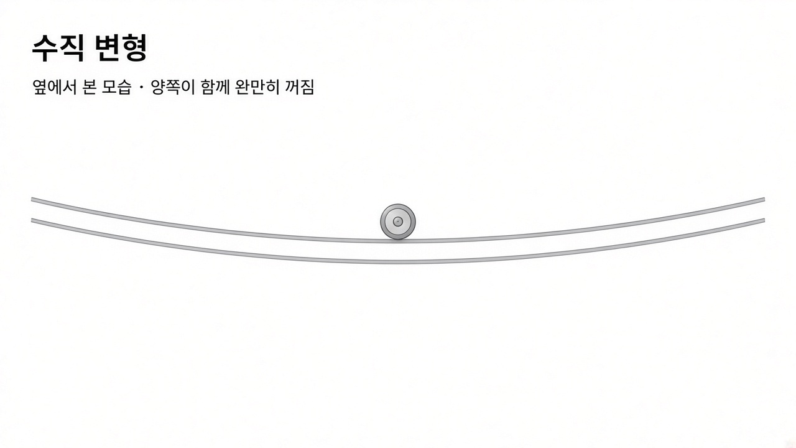
docs/결함모양-03-수직변형-옆.png
