liebe1127/HP028_RailTwin/docs/결함모양-04-좌우높이차-앞.png

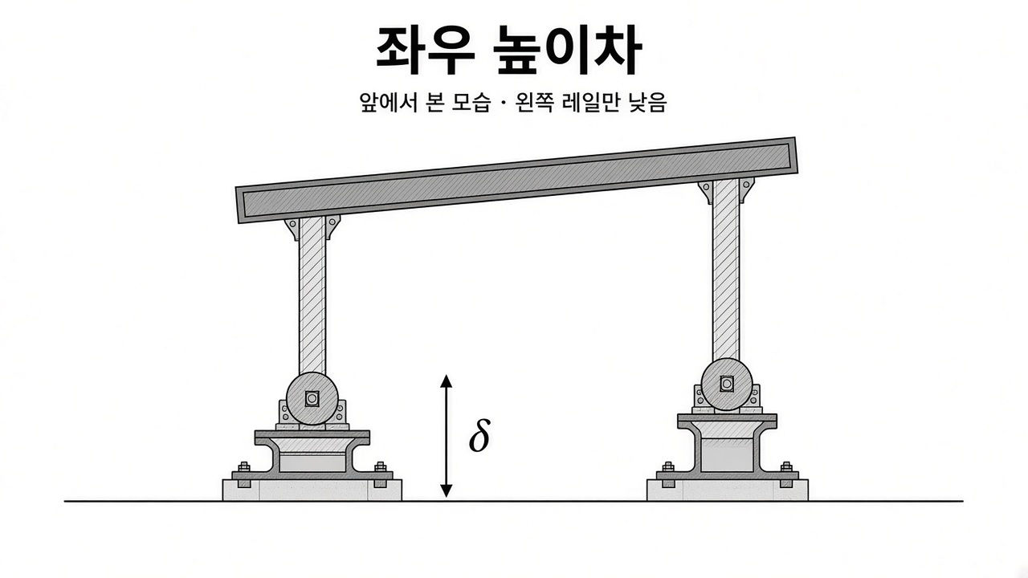
docs/결함모양-04-좌우높이차-앞.png
