liebe1127/HP028_RailTwin/배준호_전달/논문_화면캡처/실측_Unity_좌우높이차.png

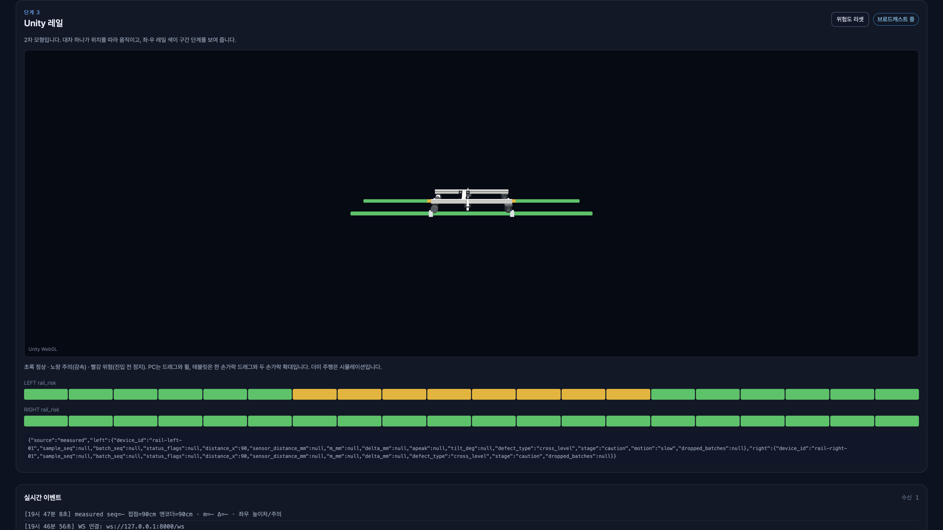
배준호_전달/논문_화면캡처/실측_Unity_좌우높이차.png
