liebe1127/HP028_RailTwin/unity/RailTwinRails/Assets/Resources/SecondPrototype/cart.obj

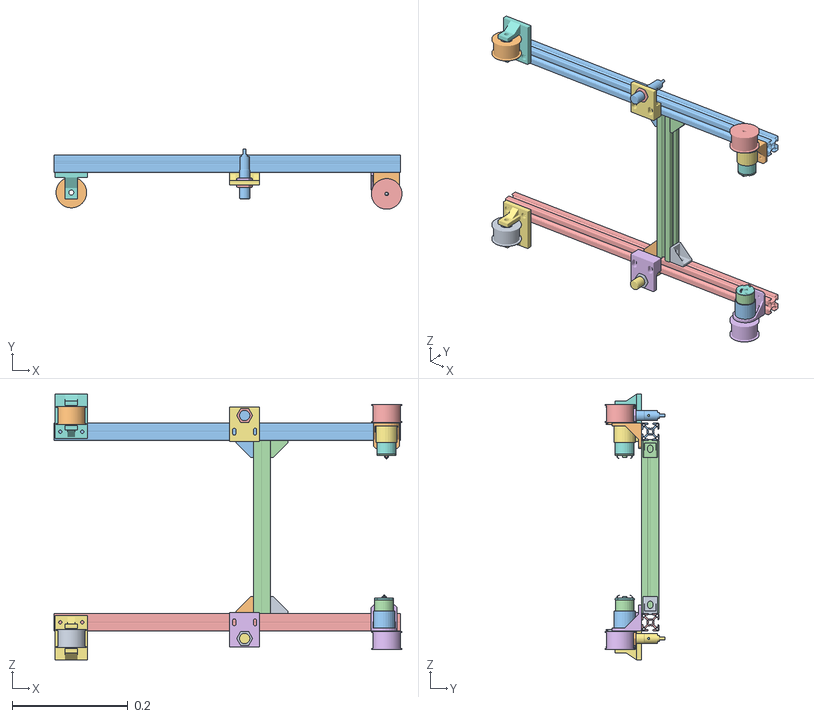
[picture p61: CAD file, 2026-09-25]
unity/RailTwinRails/Assets/Resources/SecondPrototype/cart.obj
0.602 x 0.105 x 0.46
90Joint_0
90Joint001_0
90Joint002_0
90Joint003_0
DriveWheel_1
DriveWheel001_1
IdlerBracket_1
IdlerBracket001_1
IdleWheel_0
IdleWheel001_0
BALLUFF_BES_516_326_G_BO_C_PU_03_1_2
BALLUFF_BES_516_326_G_BO_C_PU_03_1_3
Nut_M18_x_1_2
Nut_M18_x_1_001_2
BALLUFF_BES_516_326_G_BO_C_PU_03_001_2
BALLUFF_BES_516_326_G_BO_C_PU_03_001_3
Nut_M18_x_002_2
Nut_M18_x_003_2
JGB37_520_4
JGB37_521_4
JGB37_522_4
JGB37_523_4
JGB37_524_4
JGB37_525_5
JGB37_526_6
JGB37_527_6
JGB37_528_7
JGB37_529_7
JGB37_530_7
MM_JGB37_v4_8
JGB37_535_9
JGB37_536_9
JGB37_537_9
JGB37_538_9
JGB37_539_9
JGB37_540_10
JGB37_541_11
JGB37_542_11
JGB37_543_12
JGB37_544_12
JGB37_545_12
MM_JGB37_v001_8
LeftMainBeam_13
MiddleBeam_13
RightMainBeam_13
SensorBracket_0
SensorBracket001_1
