liebe1127/HP028_RailTwin/unity/RailTwinRails/Assets/Resources/SecondPrototype/Segments/RailRight_01.obj

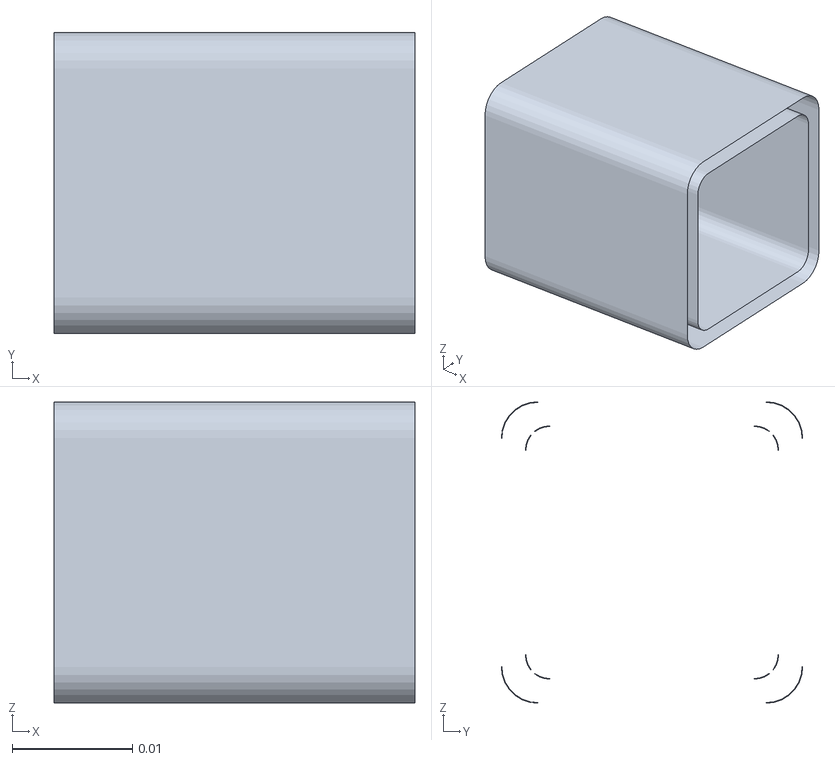
[picture p62: CAD file, 2026-09-25]
unity/RailTwinRails/Assets/Resources/SecondPrototype/Segments/RailRight_01.obj
0.03 x 0.025 x 0.025
