liebe1127/HP028_RailTwin/(list of files, cad)

Other CAD files:
unity/RailTwinRails/Assets/Resources/SecondPrototype/Segments/RailLeft_05.obj
unity/RailTwinRails/Assets/Resources/SecondPrototype/Segments/RailRight_09.obj
unity/RailTwinRails/Assets/Resources/SecondPrototype/Segments/RailRight_18.obj
unity/RailTwinRails/Assets/Resources/SecondPrototype/Segments/RailLeft_08.obj
unity/RailTwinRails/Assets/Resources/SecondPrototype/Segments/RailRight_15.obj
unity/RailTwinRails/Assets/Resources/SecondPrototype/Segments/RailRight_17.obj
unity/RailTwinRails/Assets/Resources/SecondPrototype/Segments/RailLeft_19.obj
unity/RailTwinRails/Assets/Resources/SecondPrototype/Segments/RailLeft_07.obj
unity/RailTwinRails/Assets/Resources/SecondPrototype/Segments/RailRight_11.obj
unity/RailTwinRails/Assets/Resources/SecondPrototype/Segments/RailLeft_14.obj
unity/RailTwinRails/Assets/Resources/SecondPrototype/Segments/RailLeft_10.obj
unity/RailTwinRails/Assets/Resources/SecondPrototype/Segments/RailRight_13.obj
unity/RailTwinRails/Assets/Resources/SecondPrototype/Segments/RailLeft_04.obj
unity/RailTwinRails/Assets/Resources/SecondPrototype/Segments/RailRight_14.obj
unity/RailTwinRails/Assets/Resources/SecondPrototype/Segments/RailRight_05.obj
unity/RailTwinRails/Assets/Resources/SecondPrototype/Segments/RailRight_06.obj
unity/RailTwinRails/Assets/Resources/SecondPrototype/Segments/RailRight_07.obj
unity/RailTwinRails/Assets/Resources/SecondPrototype/Segments/RailRight_04.obj
unity/RailTwinRails/Assets/Resources/SecondPrototype/Segments/RailRight_02.obj
unity/RailTwinRails/Assets/Resources/SecondPrototype/Segments/RailRight_00.obj
unity/RailTwinRails/Assets/Resources/SecondPrototype/Segments/RailLeft_13.obj
unity/RailTwinRails/Assets/Resources/SecondPrototype/Segments/RailLeft_09.obj
unity/RailTwinRails/Assets/Resources/SecondPrototype/Segments/RailRight_16.obj
unity/RailTwinRails/Assets/Resources/SecondPrototype/Segments/RailLeft_16.obj
unity/RailTwinRails/Assets/Resources/SecondPrototype/Segments/RailLeft_02.obj
unity/RailTwinRails/Assets/Resources/SecondPrototype/Segments/RailLeft_11.obj
unity/RailTwinRails/Assets/Resources/SecondPrototype/Segments/RailLeft_01.obj
unity/RailTwinRails/Assets/Resources/SecondPrototype/Segments/RailLeft_03.obj
unity/RailTwinRails/Assets/Resources/SecondPrototype/Segments/RailLeft_18.obj
unity/RailTwinRails/Assets/Resources/SecondPrototype/Segments/RailRight_03.obj
unity/RailTwinRails/Assets/Resources/SecondPrototype/Segments/RailRight_10.obj
unity/RailTwinRails/Assets/Resources/SecondPrototype/Segments/RailLeft_17.obj
unity/RailTwinRails/Assets/Resources/SecondPrototype/Segments/RailLeft_15.obj
unity/RailTwinRails/Assets/Resources/SecondPrototype/Segments/RailRight_12.obj
unity/RailTwinRails/Assets/Resources/SecondPrototype/Segments/RailLeft_12.obj
unity/RailTwinRails/Assets/Resources/SecondPrototype/Segments/RailLeft_00.obj
unity/RailTwinRails/Assets/Resources/SecondPrototype/Segments/RailLeft_06.obj
unity/RailTwinRails/Assets/Resources/SecondPrototype/Segments/RailRight_08.obj
