liebe1127/HP028_RailTwin/docs/hardware-digital-twin/photos/assembled/01-forward-is-toward-hand-and-red-boards.jpg

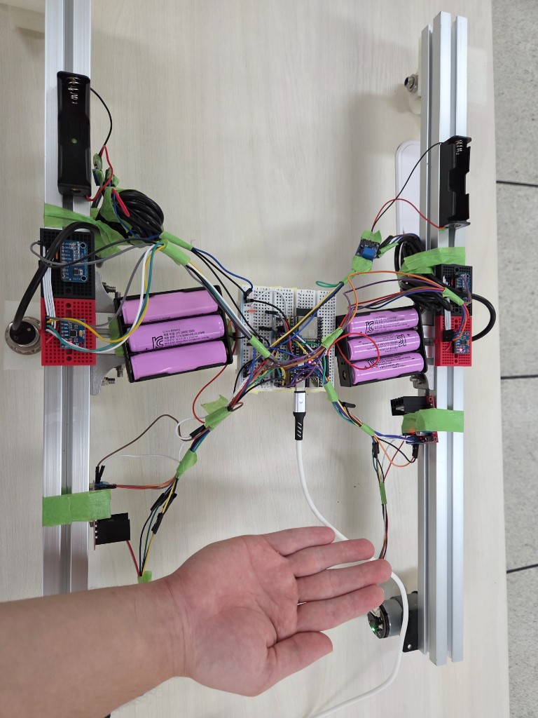
docs/hardware-digital-twin/photos/assembled/01-forward-is-toward-hand-and-red-boards.jpg
