liebe1127/HP028_RailTwin/docs/hardware-digital-twin/photos/assembled/02-imu-physical-left-frame.jpg

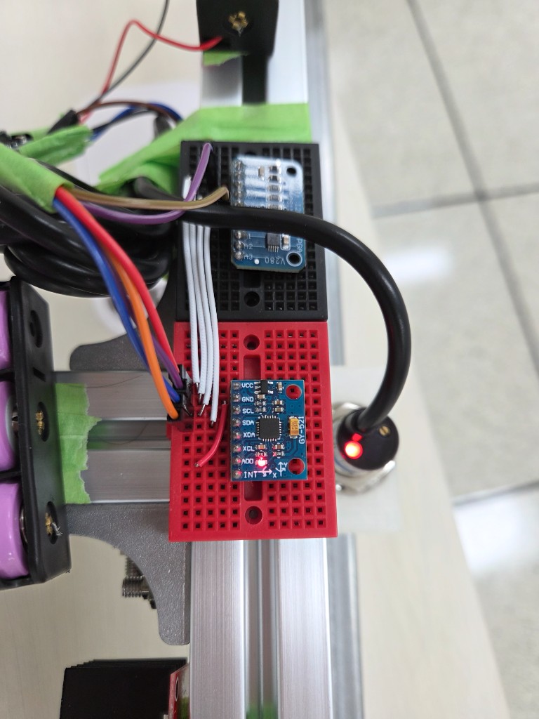
docs/hardware-digital-twin/photos/assembled/02-imu-physical-left-frame.jpg
