liebe1127/HP028_RailTwin/docs/hardware-digital-twin/photos/assembled/03-imu-physical-right-frame.jpg

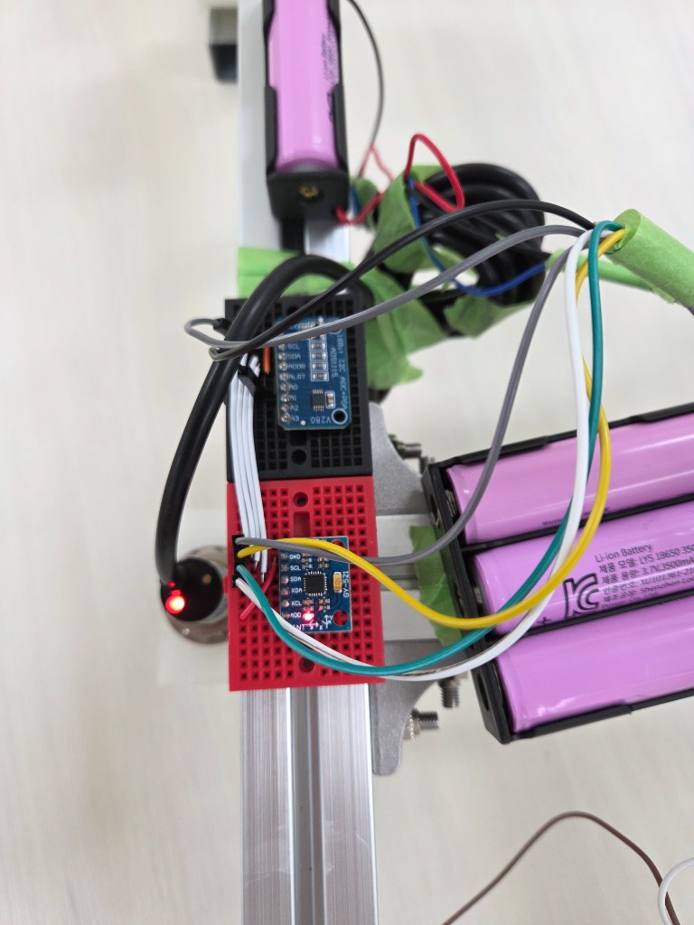
docs/hardware-digital-twin/photos/assembled/03-imu-physical-right-frame.jpg
