liebe1127/HP028_RailTwin/docs/hardware-digital-twin/photos/assembled/04-lr18-above-zinc-rail.jpg

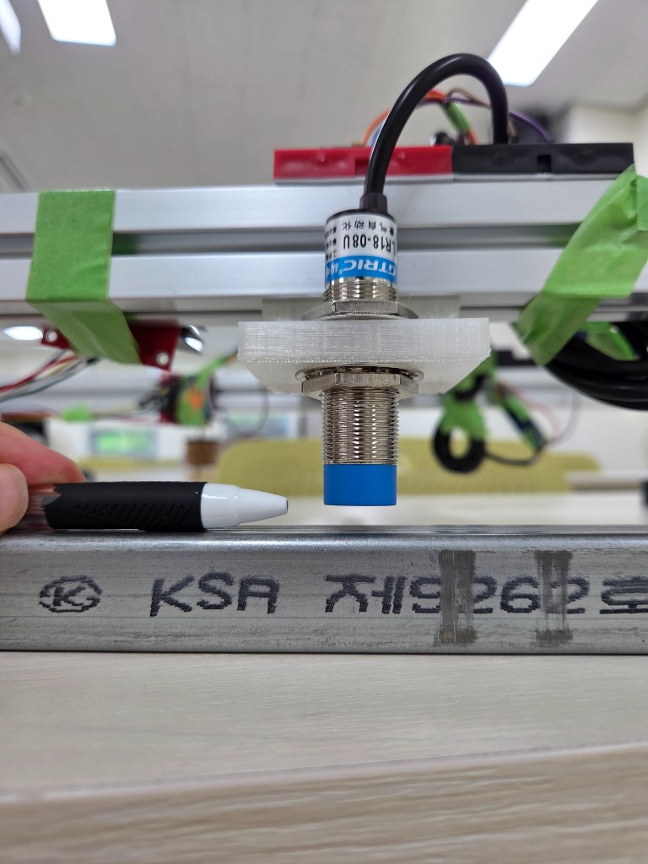
docs/hardware-digital-twin/photos/assembled/04-lr18-above-zinc-rail.jpg
