liebe1127/HP028_RailTwin/docs/hardware-digital-twin/photos/assembled/05-overhead-two-cells-before-motors-ran.jpg

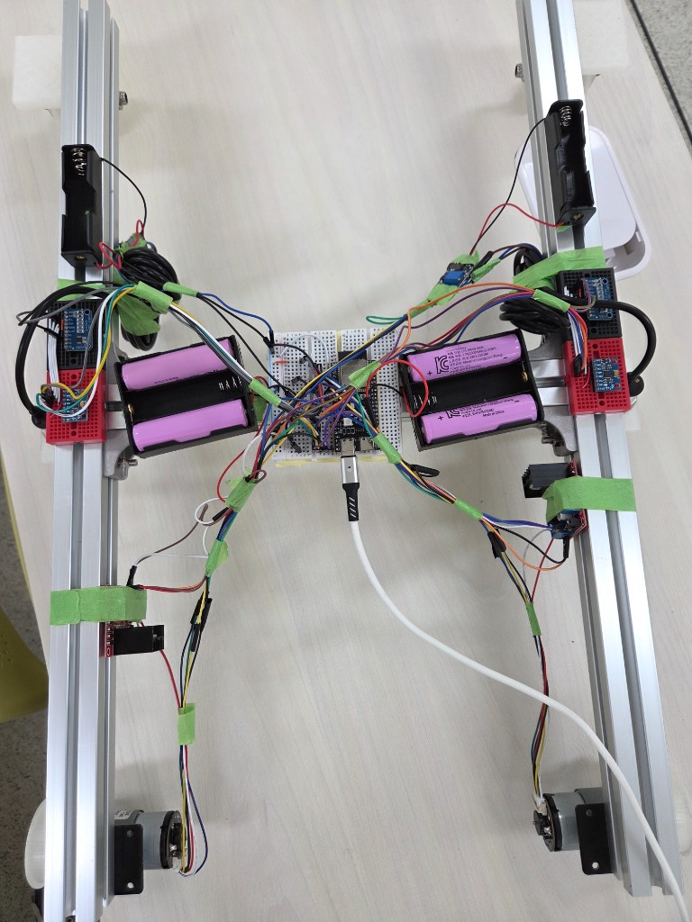
docs/hardware-digital-twin/photos/assembled/05-overhead-two-cells-before-motors-ran.jpg
