liebe1127/HP028_RailTwin/docs/hardware-digital-twin/photos/assembled/06-end-view-two-white-rollers.jpg

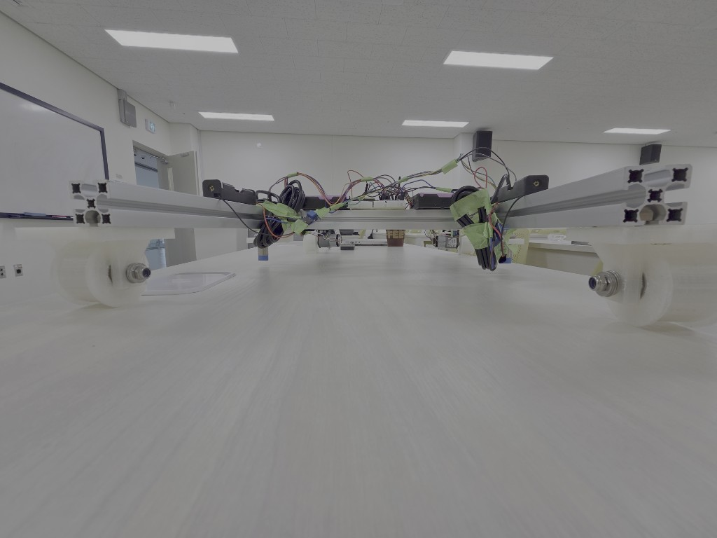
docs/hardware-digital-twin/photos/assembled/06-end-view-two-white-rollers.jpg
