liebe1127/HP028_RailTwin/docs/hardware-digital-twin/photos/assembled/07-bogie-on-zinc-square-rails.jpg

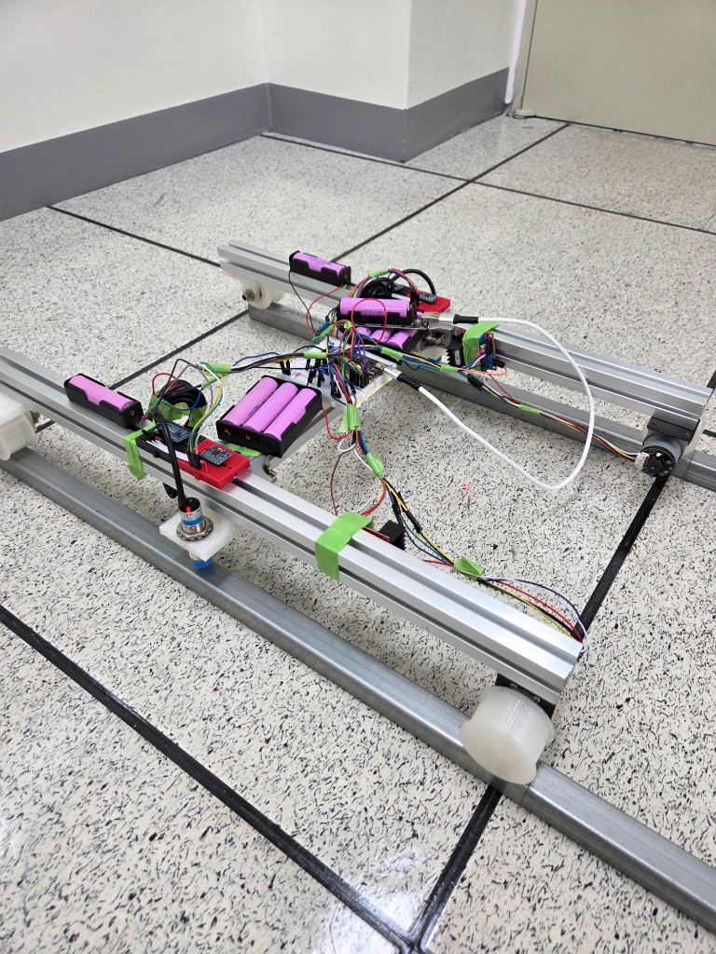
docs/hardware-digital-twin/photos/assembled/07-bogie-on-zinc-square-rails.jpg
