liebe1127/HP028_RailTwin/docs/hardware-configuration-history.md

# 센서 하드웨어 구성 변경 이력

기준일은 2026-09-24 배용진 하드웨어 인수인계서(HP028-SCH-001 Rev C)와 2026-09-25 사용자 확인(하드웨어 조립 완료, 실물 사진 3장)이다. 값은 인수인계서에 근거가 있는 것만 확정으로 적는다. 근거가 없는 값은 미확인이다.

2026-09-25 오후에 확정된 좌우·전진·IMU 화살표·엔코더와 줄자 비교, 그리고 팀원 GLB는 `docs/hardware-digital-twin/README.md`가 정본이다. 아래 본문에서 그 항목을 미확인이라고 적은 문장보다 그 파일이 우선한다.

## 현재 기준 구성

조립된 축소 모형은 MCU 한 장이 좌·우를 함께 본다.

- MCU: ESP32-S3-DevKitC-1 N16R8 1장 (ESP32-S3-WROOM-1 N16R8)
- 거리: GTRIC LR18-08U 2개. 유도형, 출력 0–10V, 감지 1–8mm. 좌·우 각 1개
- 관성: MPU-6050(GY-521) 2개
- ADC: ADS1115 2개. 센서마다 1개. 주소 `0x48` (ADDR→GND)
- IMU 주소: `0x68` (AD0→GND). 버스가 달라 좌·우 주소가 같아도 된다
- 모터 드라이버: L298N 2개. 각각 A채널만 사용. ENA 점퍼 제거(PWM). 5V-EN 점퍼 제거
- 모터: JGB37-520 12V 37RPM 2개. 엔코더는 모터 뒤 내장형
- 승압: MT3608 2개. 센서 전원 목표 24.0V(무부하 조정값, 부하 실측은 미확인)
- 전지: 18650 9개. 로직 1개(USB-C 출력, ON/OFF 홀더), 센서 좌·우 각 1개, 모터 좌·우 각 3S

2026-09-25 실물 사진의 은색 부재는 대차 프레임(알루미늄 프로파일)이다. 측정 대상 레일은 바닥에 놓은 아연 각파이프이며, 그 세 장에는 레일 자체가 보이지 않는다. 사진의 큰 홀더에는 셀이 2개씩 보인다. 인수인계서의 모터 팩은 3S이므로, 셀 하나를 빼 둔 상태일 수 있다. 팩 전압은 미확인이다.

### 버스와 핀

브링업 스케치 `RailTwin_BringUp.ino` 기준. 원본은 배용진 PC의 Arduino 스케치이며 이 저장소에는 없다. 개발 환경은 Arduino IDE 1.8.19, 보드 `ESP32S3 Dev Module`, USB CDC On Boot Enabled, 업로드 포트 COM8(네이티브 USB). UART 포트 COM7 업로드는 실패했다. IDE 2.x는 한글 경로에서 문제가 있었다.

| 기능 | GPIO | 연결 | 신호 |
|---|---|---|---|
| I2C 좌 SDA / SCL | 11 / 12 | ADS1115·MPU6050 좌. `Wire`, 100 kHz | 3.3V. 모듈 내장 풀업 |
| I2C 우 SDA / SCL | 13 / 14 | ADS1115·MPU6050 우. `Wire1`, 100 kHz | 3.3V |
| 거리 좌·우 | 외부 ADC | LR18 흑색 출력 → 20k/10k → 해당 ADS1115 AIN0–GND | 센서 0–10V, AIN0 0–3.33V |
| 엔코더 좌 A / B | 15 / 16 | 모터 내장. VCC는 +3V3 | 3.3V. A상 상승 에지만 계수 |
| 엔코더 우 A / B | 17 / 18 | 동일 | 3.3V |
| 모터 좌 ENA / IN1 / IN2 | 4 / 5 / 6 | L298N 좌. ENA 점퍼 제거 | PWM 0–255 |
| 모터 우 ENA / IN1 / IN2 | 7 / 8 / 9 | L298N 우 | PWM 0–255 |
| 주행 시작 | 0 | 보드 BOOT 스위치. 외부 배선 없음 | 3.3V 입력 |

GPIO3·GPIO46은 비운다. 모듈 선이 닿으면 업로드가 실패했다. GPIO19·20(USB), 43·44(UART0), 35–37(옥타 PSRAM)은 미사용. 5V 핀과 3V3 핀에는 외부 전원을 넣지 않는다. 3.3V 부하는 J1-1에서만 나누고 J1-2는 비어 있다.

ADS1115 변환 설정은 `0xC383` (AIN0–GND, ±4.096V, 128SPS, 단발)이다. 좌·우 스캔 로그(2026-09-23)는 각 버스 `0x48`, `0x68`이고 MPU WHO_AM_I는 `0x68`이다.

### 전원

로직, 센서, 모터는 전지가 따로이고 GND만 공통이다.

- 로직: 18650 1셀 USB-C 홀더 → 보드 왼쪽 USB-C(COM8과 같은 포트). 노트북과 배터리가 이 포트를 같이 쓰므로, 배터리 주행 중에는 시리얼을 볼 수 없다. 결과는 내부 메모리에 두고 노트북 연결 후 `p`로 본다. 코드는 작성되었고, 배터리만으로 BOOT 주행한 기록은 없다.
- +3V3: 보드 LDO → ADS1115, MPU6050, 엔코더. 배터리 단독 상태에서 3V3 핀 실측은 미확인.
- 센서: 좌·우 각 18650 1셀 → MT3608. 목표 24.0V. 센서 연결 상태의 OUT 실측은 미확인. LED 점등만 확인.
- 모터: 좌·우 각 18650 3S, 11.1V 공칭. 팩 전압 실측은 미확인. L298N 단독 시험(2026-09-24)에서 OUT1–OUT2 약 10V.

접지:

- ESP32, ADS1115, MPU6050, 엔코더, 분압 아랫저항, 100nF(설계)는 브레드보드 바깥 마이너스 레일에서 ESP32 GND로 공통.
- 센서 전지 음극, MT3608 IN−/OUT−, 센서 청색(BU)은 모듈에서 묶은 뒤 공통 GND로 얇은 선 1가닥.
- 모터 팩 음극과 L298N GND는 굵은 선으로 서로 연결하고, 공통 GND로 얇은 선 1가닥.

거리 분압은 좌·우 독립이다. 위 20kΩ(센서 출력 쪽), 아래 10kΩ(GND 쪽). 펌웨어 `DIV = 3.0`. 색띠로 좌측 빨-검-주, 갈-검-주를 봤고, Ω 실측은 하지 않았다. 지금 꽂힌 저항이 20k/10k인지는 다리를 빼서 확인한다. C3 시기에는 임시로 470k/68k를 쓴 적이 있다. 필터 100nF(C1·C2)는 회로도에 있고 다리 길이 때문에 미장착이다. 부품은 가방에 있다.

LR18 몸체 라벨 사진(2026-08-23)은 DC 15–30V, 0–10V, 1–8mm, 갈색(+), 청색(−), 흑색(출력)이다. 인수인계서 전원 표의 사양 표기는 DC 10–30V이고, 실사용 목표는 24V이다.

### 거리·엔코더·IMU (브링업에 넣은 값)

설치 간격 목표는 5.00mm이다. 교정 곡선에서 4–6mm가 가장 가파르고, 0–2mm는 거의 반응이 없다. 이 5mm는 교정표 기준이라 교정 금속과 레일 재질이 다르면 실제 틈과 다를 수 있다. 틈새 게이지 교차 확인은 미확인. 센서 뒤 가변저항을 돌리면 교정표는 무효다. 교정에 쓴 금속 재질은 미확인.

전압은 센서 출력(ADS 전압 × 3.0)이다. 2026-09-24 03:33–03:50 로그.

| mm | 좌 (V) | 우 (V) |
|---|---|---|
| 0 | −0.010 | 0.004 |
| 2 | 0.187 | 0.242 |
| 4 | 2.044 | 2.935 |
| 6 | 5.725 | 6.546 |
| 8 | 7.592 | 8.210 |

켠 직후 출력이 천천히 내려간다. 약 2분 40초에 1.44V에서 1.35V. 기준값은 그 뒤에 잡는다. 정지 잡음은 0.001–0.002V.

코드의 왼쪽은 Wire(GPIO11/12)에 물린 센서이다. 진행 방향의 실제 좌·우는 한쪽 센서만 가려 보고 확정한다. 미확인.

구동륜 도면: 답면 지름 47mm, 플랜지 외경 53mm, 폭 18mm, 둘레 147.7mm. 출력품 실측은 미확인. 엔코더는 A상 상승 에지 1×. `COUNTS_PER_300 = 6034`에서 약 0.0497 mm/카운트, 바퀴 1회전 약 2970카운트. 잠정값. 전진(IN1=HIGH, IN2=LOW)에서 좌 카운트는 증가하고 우 카운트는 감소한다. 좌 모터는 L298N OUT1/OUT2를 교차해 두 바퀴가 같은 방향으로 돈다. 레일 기준 어느 쪽이 전진인지는 미확인. 같은 PWM에서 좌가 약 13% 빠르다(517 대 455). `syncDrive()`, `SYNC_KP = 2.0`을 유지한다. 설계 주행 속도는 약 15cm/s이고 `RUN_DUTY = 120`의 실제 속도는 미확인.

ADS 단발 변환과 `delay(10)` 때문에 센서 2개와 MPU 2개를 한 바퀴 도는 데 20ms가 넘는다. 15cm/s면 샘플 간격이 3mm를 넘는다.

IMU는 가속도 ±2g(16384 LSB/g), DLPF 44Hz. 브링업은 자이로를 읽지 않는다. 정지·수평에서 Z가 위(+)이다. 좌 Z 약 1.07g, 우 Z 약 1.00g이므로 기울기 전에 각각 오프셋을 뺀다. X·Y가 차체 전후·좌우 중 어디인지는 GY-521 화살표 사진이 있어야 한다. 미확인.

레일 위 0mm는 미확정이다. 브링업 `t`는 시작 위치를 0으로 둔다.

### 레일

레일은 아연 각파이프를 바닥에 그대로 놓는다. 고정이 없다. 요청서에 있던 알루미늄 프로파일은 측정 레일이 아니다. 3D 프린트 이음 연결부는 3개뿐이고 나머지는 테이프이다. 파이프 절단 오차로 이음부마다 단차가 있고, 그 실측을 이음부 단차 결함으로 쓴다. 설계값 0.5 / 1.0 / 2.0mm는 이 레일의 정답값이 아니다.

2026-09-26 사용자 확인: 실험 레일 한 개는 아연 각파이프이고, 길이는 60 cm, 바깥 단면은 높이·좌우 모두 25 mm이다. WebGL은 이 각파이프 메시를 한 줄에 3개 이어 180 cm로 보여 주고, 이음 위치만 구분한다. 좌우 레일 간격과 이음부 단차 높이는 미확인이다. 바닥에 놓아 주행마다 간격이 바뀔 수 있다. 수직 변형용 경사판과 한쪽만 높인 판은 설계만 있고 제작 여부는 미확인이다. 자성 여부는 자석으로 확인한다. 아연도금 강관이면 유도형 센서가 본다. PLA·테이프·퍼티·플라스틱은 센서가 보지 못한다. SUS304는 감지가 약하고 SUS430·아연도금 강판은 가능하다.

이음부가 테이프이면 반복 주행 뒤에 단차와 간격을 다시 잰다. 0mm 표시는 레일과 바닥 양쪽에 둔다.

### 이미 확인된 동작

- 네이티브 USB COM8 업로드·시리얼
- 좌·우 I2C 각 `0x48`·`0x68`, MPU 초기화
- 금속 0–8mm에서 좌·우 전압 변화. 위 교정표
- 모터 정방향. 두 바퀴가 같은 방향
- 접지 시험: 좌 모터 구동 전후 차 0.003mm(당시 선형 환산). 우는 출력이 0V 바닥이라 판정 무효
- `t` 30cm 주행: 완주·센서 읽기·범위·정지 흔들림은 확인. 좌우 엔코더 거리 차 5% 초과
- 동기화 코드를 넣은 재주행: 주행·정지만 확인. 줄자로 잰 이동 거리는 없음

### 펌웨어를 저장소 계약에 맞추기 전에 잴 것

1. 레일과 바닥의 0mm. 이음부 위치와 단차 높이(좌·우 각각)
2. `t` 1회 후 줄자 거리. 300mm와 차이가 크면 `COUNTS_PER_300`을 비례해 수정
3. 코드의 좌·우와 명령 1의 전진 방향
4. 좌·우 GY-521의 X·Y 화살표 사진

바퀴 지름, 분압 저항 Ω, 전원 전압, 레일 단면·간격·길이, 주행 속도, 레일 위 재교정은 측정이 이상할 때 잰다.

### 현장 운용

전원을 켜면 LED부터 본다. 모터 엔코더 기판은 초록, L298N·LR18·MPU6050·ESP32는 빨강이어야 한다. 안 쓸 때는 모터 팩에서 셀 하나를 빼거나 로직 홀더를 끄고, 센서 셀도 빼 둔다. 모터가 갑자기 안 돌면 모터 팩 방전을 먼저 본다. L298N +12V–GND가 약 12V이면 정상, 약 8V면 1셀, 약 4V면 2셀 방전으로 본다. 셀 단독은 약 3.7–4.2V. ESP32 브레드보드 마이너스 레일 선은 3개+3개로 6개여야 한다.

## 현재 저장소 펌웨어

조립 실물에 올리는 스케치는 `firmware/esp32_s3_rail_node/`이다. 가속도 3축, 자이로 3축, 칩 온도, 간격, 엔코더를 읽고, 주행 중일 때만 MQTT 배치를 보낸다. BOOT는 전진 80초이다.

## 저장소에 남아 있던 이전 펌웨어

`firmware/esp32_c3_rail_sensor/`는 2026-08-23에 적은 이전 설계이다. 조립된 보드에 올라가 있는 코드가 아니다.

- MCU를 ESP32-C3 Mini 두 장(`rail-left-01`, `rail-right-01`)으로 가정한다
- Wi-Fi MQTT QoS 1, MPU-6050 100Hz, ADS1115 20Hz, 가속도·자이로 전송
- 핀맵·분압·엔코더 상수가 위 표와 다르다

이 경로의 코드와 `docs/esp32-mqtt-contract.md`는 서버가 받도록 적어 둔 이전 업링크 계약이다. 실물 핀맵·샘플 주기로 바꾸기 전에는 현재 하드웨어 펌웨어로 인용하지 않는다.

## 취소된 초기 프로토타입

다음 조합은 초기 수집 검증 후 취소했다. 현재 MCU도 ESP32-S3 계열이지만 보드·센서가 다르다. 이름만 보고 같은 구성으로 적지 않는다.

- MCU: ESP32-S3-WROOM-1 (DevKitC-1 N16R8가 아님)
- 가속도: ADXL345
- 거리: HC-SR04

이 스케치는 2026-09-27에 저장소에서 삭제했다. 신규 배선·펌웨어·부품 기준으로 쓰지 않는다.

## 적용 원칙

1. 현재 하드웨어는 ESP32-S3-DevKitC-1 N16R8 1장, LR18-08U 2개, MPU-6050 2개, ADS1115 2개, L298N 2개, JGB37-520 2개, MT3608 2개, 18650 9개이다.
2. ESP32-C3 Mini 두 노드는 저장소에 남은 이전 펌웨어 설계이다. 조립 실물로 적지 않는다.
3. ESP32-S3-WROOM-1 + ADXL345 + HC-SR04만 `취소된 초기 프로토타입`이다.
4. 분압 20k/10k, 거리 교정표, 엔코더 0.0497 mm/카운트는 브링업에 넣은 값이다. Ω·틈새 게이지·레일 위 재교정·0mm 기준은 미확인으로 남긴다.
5. 과거 자료는 지우지 않고 이력으로 두되, 현재 구성과 섞지 않는다.
