liebe1127/HP028_RailTwin/(list of files, drawings)

Other design files:
ECAD/compact-sensor-module/temp-freerouting.dsn
