liebe1127/HP028_RailTwin/ECAD/compact-sensor-module/compact-sensor-module.kicad_pcb

## KiCad design ECAD/compact-sensor-module/compact-sensor-module.kicad_pcb (2026-09-06)

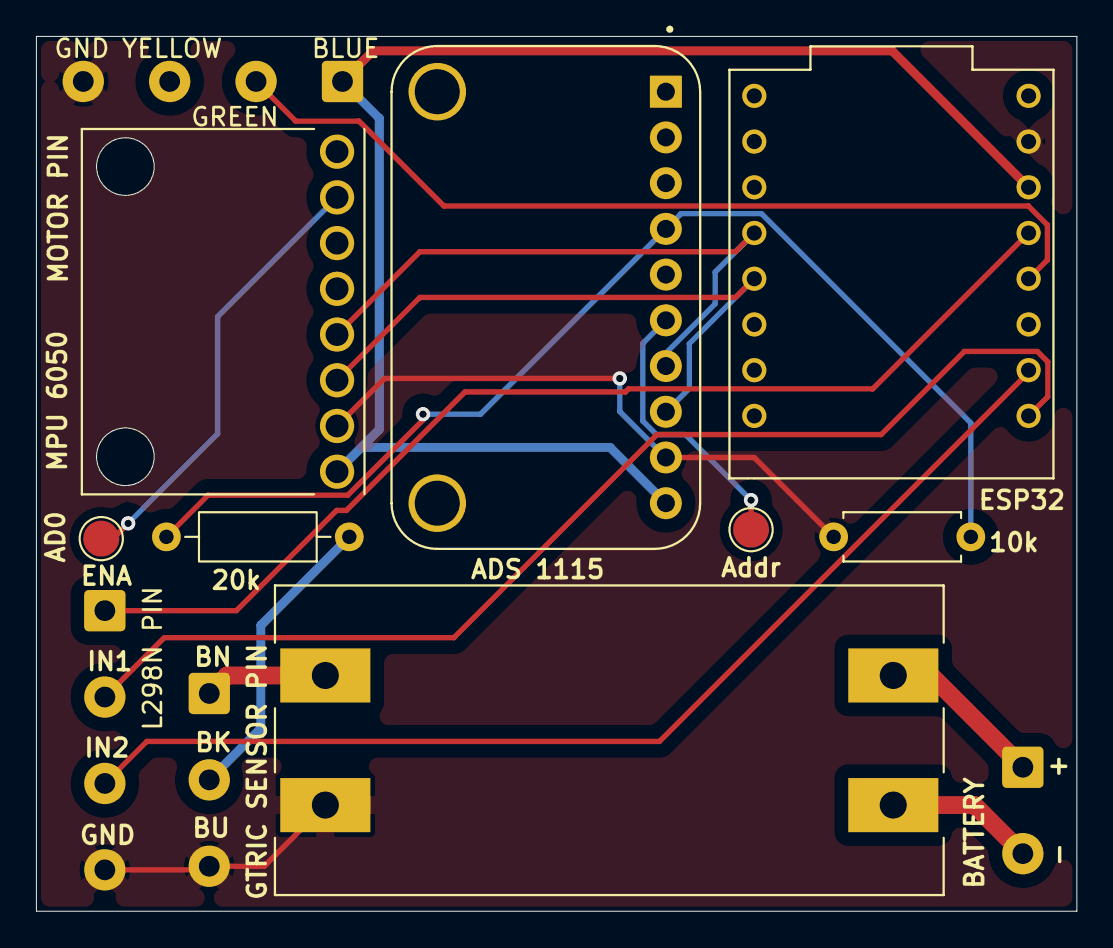
[picture p71: board compact-sensor-module.kicad_pcb from above]

Board: 2 copper layers, 57.8 x 48.6 mm, 12 parts (0 on the bottom side), 15 nets.

Parts:
10k: 10k; R_Axial_DIN0207_L6.3mm_D2.5mm_P7.62mm_Horizontal
20k: 20k; R_Axial_DIN0207_L6.3mm_D2.5mm_P10.16mm_Horizontal
AD0: I2C Addr; TestPoint_Pad_D2.0mm
ADS 1115: ADS1115; MODULE_ZC261500
Addr: I2C Addr; TestPoint_Pad_D2.0mm
BATTERY: BATTERY PIN; SolderWire-0.5sqmm_1x02_P4.8mm_D0.9mm_OD2.3mm
ESP32: ESP32-C3_SUPERMINI_TH; MODULE_ESP32-C3_SUPERMINI_TH
GTRIC SENSOR PIN: GTRIC SENSOR PIN; SolderWire-0.5sqmm_1x03_P4.8mm_D0.9mm_OD2.3mm
L298N PIN: L298N PIN; SolderWire-0.5sqmm_1x04_P4.8mm_D0.9mm_OD2.3mm
MOTOR PIN: Motor Encoder Pin; SolderWire-0.5sqmm_1x04_P4.8mm_D0.9mm_OD2.3mm
MPU 6050: MPU-6050; MODULE_OC09600
U2: MT3608; MODULE_MT3608_DC-DC_STEP_UP_CONVERTER_2A_BOOSTER_MODULE

Connections:
/BAT+: BATTERY.1, U2.VIN_P (VIN+)
/BAT-: BATTERY.2, U2.VIN_N (VIN-)
/BK: 20k.1, GTRIC SENSOR PIN.2
/BLUE: ADS 1115.10 (VDD), ESP32.3.3 (3V3), MOTOR PIN.1, MPU 6050.VCC
/BN: GTRIC SENSOR PIN.1, U2.VOUT_P (VOUT+)
/ENA: ESP32.4 (GPIO4), L298N PIN.1
/GREEN: ESP32.3 (GPIO3), MOTOR PIN.2
/IN1: ESP32.0 (GPIO0), L298N PIN.2
/IN2: ESP32.1 (GPIO1), L298N PIN.3
/SCL: ADS 1115.8 (SCL), ESP32.9 (GPIO9), MPU 6050.SCL
/SDA: ADS 1115.7 (SDA), ESP32.8 (GPIO8), MPU 6050.SDA
GND: 10k.2, ADS 1115.9 (GND), ESP32.G (GND), GTRIC SENSOR PIN.3, L298N PIN.4, MOTOR PIN.4, MPU 6050.GND, U2.VOUT_N (VOUT-)
unnamed: AD0.1 (1_1), MPU 6050.AD0
unnamed: 10k.1, 20k.2, ADS 1115.4 (A0)
unnamed: ADS 1115.6 (ADDR), Addr.1 (1_1)
