liebe1127/HP028_RailTwin/(commit log)

2026-07-17 feat: 크레인 IoT 센서 데이터 수집 시스템 Prototype V1
    - firmware/crane_sensor.ino: ESP32-S3 펌웨어 (ADXL345 + HC-SR04)
    - serial_receiver.py: pyserial 기반 시리얼 수신 프로토타입
    - main.py: FastAPI 서버 (Producer/Consumer, InfluxDB, WebSocket)
    - frontend/index.html: 실시간 센서 대시보드 (Vanilla JS + Tailwind)
    - requirements.txt: Python 의존성
    - .env.example: 환경 변수 템플릿
2026-07-17 feat: MPU-6050 센서 추가 (ADXL345+HC-SR04 기존 회로 유지)
    - firmware: MPU-6050 초기화/읽기 추가, ADXL345·HC-SR04 배선(GPIO8/9, GPIO4/5)은 변경 없이 I2C 버스 병렬 공유
    - firmware: 출력 포맷을 AAX/AAY/AAZ,DIST,MAX/MAY/MAZ,GX/GY/GZ로 확장
    - serial_receiver.py: EXPECTED_KEYS 화이트리스트 기반 파싱으로 재작성, MPU-6050 필드 지원
    - main.py: parse_sensor_line, InfluxDB field_map, WebSocket payload에 MPU-6050 필드 반영
2026-07-18 feat: 핵심 타겟을 하부 주행 레일 변형 예측으로 재정의하고 AI 파이프라인 통합
    거더 처짐 중심의 과거 문서·식별자를 걷어내고, 주행 진동 기반 레일
    단차·침하·뒤틀림 예측으로 프로젝트 문맥을 통일한다.
    - README를 레일 변형 예측 목표로 전면 개정
    - RBF 대리 모델 학습·추론, 웨이블릿/파고율 특징 공학 추가
    - ESP32 엣지 0.01g 임계값, 시연용 더미 스트리머, WebSocket PRED_RAIL_DEFORM
    - 프론트엔드·변수명을 레일 변형 문맥에 맞게 정리
2026-07-18 docs: 아키텍처 다이어그램을 하부 레일 변형 예측 파이프라인 도식으로 교체
    Sensor→Backend→RBF→Godot 단계와 단차/침하 위험 시각화를 반영한
    새 시스템 아키텍처 이미지로 README 상단 도식을 갱신한다.
2026-07-21 feat: Godot WebSocket 연동 스크립트 추가 (레일 변형 디지털 트윈)
    FastAPI ws 페이로드(distance_x, CREST, PRED_RAIL_DEFORM)를 수신해
    크레인 위치와 레일 위험 색상을 갱신하는 GDScript를 추가한다.
    단일 FBX 내부 노드는 Inspector의 Crane/Rail Path로 지정한다.
2026-07-23 feat: WebSocket에 레일 구간 위험도 배열(rail_risk) 전송
    Godot가 구간별 손상도를 칠할 수 있도록 서버 메모리 히트맵을 누적·브로드캐스트한다.
2026-07-23 feat: Godot 4.7 구간별 rail_risk 시각화로 업그레이드
    서버 rail_risk 배열을 받아 레일 세그먼트마다 정상~위험 색을 칠하고, WebSocket은 4.7 공식 poll/재연결 패턴을 따른다.
2026-07-23 feat: 네이버클라우드 Docker 배포 구성 추가
    CPU torch 이미지·Compose·엔트리포인트와 NCP 서버 생성부터 Godot 접속까지 가이드를 묶어 원격 시연을 쉽게 한다.
2026-07-23 docs: 진행 현황 브리프 PPT 추가
    Phase별 구현 현황을 한·영 병기로 공유하기 위한 짧은 발표 자료를 추가한다.
2026-07-28 feat: Nginx 없이 Uvicorn SSL로 HTTPS/WSS 적용
    NCP 시연용으로 Let's Encrypt 인증서를 Uvicorn에 직접 붙여 443에서 제공하고, 클라이언트 기본 URL을 wss:// 도메인으로 맞춘다.
2026-08-15 feat: 좌·우 레일 WebSocket 페이로드와 대시보드 서빙
    Godot·웹 클라이언트가 left/right 레일을 구분하도록 WS JSON을 나누고, FastAPI에서 /dashboard로 대시보드 HTML을 연다.
2026-08-21 feat: NCP GitHub Actions 자동 배포(main push 시 pull·재시작)
    서버 /var/www/HP028_RailTwin 기준으로 merge 후 SSH로 ncp_deploy.sh를 실행한다.
2026-08-21 chore: NCP SSL pem gitignore 경로 정리
2026-08-21 fix: NCP 배포 시 pip install 기본 생략
    의존성 변경 시에만 INSTALL_DEPS=1 로 설치하도록 해 디스크·배포 시간을 절약한다.
2026-08-21 feat: 더미→AI→Godot 실시간 파이프라인 대시보드
    WebSocket·헬스 API만으로 단계별 센서/추론/rail_risk를 표시한다.
2026-08-21 feat: rail_risk 누적 히트맵 리셋 API와 대시보드 버튼
    POST /rail_risk/reset 으로 서버 상태를 초기고, 파이프라인 모니터에서 호출한다.
    [main.py]
2026-08-21 fix: Godot WSS 자체 서명 인증서용 TLS 검증 생략
    NCP 시연 인증서로 handshake -9984가 나지 않도록 client_unsafe 옵션을 추가한다.
2026-08-23 feat: ESP32-C3 WebSocket 센서 펌웨어 추가
    현재 센서 모듈이 고속 계측 데이터를 배치 전송하고 연결 장애를 추적할 수 있도록 ACK 기반 WiFi WebSocket 경로를 마련합니다.
2026-08-23 feat: 센서 WebSocket 업링크 추가
    시리얼 포트 의존성을 제거하고 ESP32-C3 배치를 인증·중복 검증·ACK 처리하는 전용 수집 경로로 전환합니다.
2026-08-23 feat: ESP32-C3 센서 데이터 계약 적용
    장치·레일·순번·시간·위치·거리·ADC·IMU 값을 검증해 단위가 명확한 내부 레코드로 정규화합니다.
2026-08-23 feat: RBF 입력을 현재 센서 특징으로 이관
    ADXL345·HC-SR04 원시 입력을 제거하고 MPU6050·LR18·엔코더 롤링 특징만 사용하도록 모델 계약과 합성 학습을 갱신합니다.
2026-08-23 feat: InfluxDB를 현재 센서 필드로 이관
    장치가 보낸 위치·거리·ADC·MPU·순번과 서버 특징을 원래 샘플 시각으로 저장해 추적성과 재학습 가능성을 높입니다.
2026-08-23 feat: 현재 센서 WebSocket 출력을 시각화
    Godot 이동·위험도 계약은 유지하면서 MPU6050과 LR18 진단값, 장치 추적 정보를 웹과 3D 클라이언트에 전달합니다.
2026-08-23 test: WebSocket 파이프라인 검증과 문서 정리
    시리얼 경로를 이력으로 격리하고 센서 계약·배포 설정·프로젝트 문서를 동기화해 새 무선 파이프라인을 재현 가능하게 검증합니다.
2026-08-23 feat: ESP32 MQTT ingest and live dashboard visualization
    Replace the WebSocket sensor uplink with Mosquitto QoS 1, and render incoming left/right batches on the web dashboard instead of the dummy streamer.
    [config.h, main.py, sensor_contract.py, serial_receiver.py]
2026-08-24 feat: C3 10초 전진 시연 구동과 단차 충격 시각화
    부팅 후 L298N으로 10초 주행하고, 레일 단차 충격을 MQTT로 올려 대시보드·Godot가 따라가게 한다. 팀원이 C3 Mini에 바로 올릴 수 있게 한다.
2026-08-25 feat: adapt right-node firmware to actual breadboard wiring
    - Remap L298N (IN1=0, IN2=1, ENA=4) and encoder (single-channel Hall
    pulse on GPIO3, no quadrature B line) to match the assembled
    breadboard rather than the original provisional pin guesses.
    - Replace 2-channel quadrature decoding with single-pin pulse
    counting to match the actual encoder wiring.
    - Delay the demo drive 15s after boot so WiFi/MQTT are connected
    before the motor moves, instead of starting immediately in setup().
    - Invert motor direction (MOTOR_INVERT) to match the wheel's actual
    forward direction on this build.
    - Tune demo drive to 30s at duty=180, based on empirical stall/speed
    testing on the physical rai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
    [config.h]
2026-09-06 feat: starting to make pcbs for project
    [compact-sensor-module-B_Cu.gbl, compact-sensor-module-B_Mask.gbs, compact-sensor-module-B_Paste.gbp, compact-sensor-module-B_Silkscreen.gbo, compact-sensor-module-CuBottom.gbr, compact-sensor-module-CuTop.gbr, compact-sensor-module-EdgeCuts.gbr, compact-sensor-module-Edge_Cuts.gm1]
2026-09-06 docs: README.md 빠진 부분 추가
2026-09-23 feat: 대시보드 마커가 서버 레일 길이를 따르고 Unity WebGL을 제공한다
    100cm 고정 나눗셈을 빼고, 다시 빌드한 레일 화면을 클라우드에서 열 수 있게 /unity 경로를 붙인다.
2026-09-23 feat: 브레드보드 배선 위에 세로 충격 정지와 속도 명령을 올린다
    핀과 주행 시간은 유지하고, 통신이 끊겨도 세로 충격이면 모터를 멈춘다.
2026-09-23 feat: Unity 위치 막대를 하나로 두고 프로젝트 소스를 저장한다
    시작 시 막대가 두 번 생기던 경로를 없애고, WebGL 빌드와 레일 씬 소스를 함께 둔다.
2026-09-23 feat: 구간 규칙 판정과 속도 명령을 두고 RBF·Godot를 뺀다
    서버가 여섯 특징으로 이음부 단차·수직 변형·좌우 높이차를 판정하고, 평속·감속·정지를 MQTT로 보낸다.
2026-09-25 docs: 개발보고서 초안을 삭제하고 남은 참조를 정리한다.
    공식 양식 항목표와 통합 문맥만 보고서 작업 기준으로 남긴다.
2026-09-25 feat: 대시보드에 2차 모형 WebGL과 회전·확대를 넣는다
    큐브 레일 대신 2차 모형을 보여주고, 3단계 화면을 넓힌 뒤 마우스와 터치로 카메라를 돌리고 확대한다.
    [RailLeft_00.obj, RailLeft_01.obj, RailLeft_02.obj, RailLeft_03.obj, RailLeft_04.obj, RailLeft_05.obj, RailLeft_06.obj, RailLeft_07.obj]
2026-09-25 feat: 보드 없이 대시보드를 볼 수 있는 더미 실행 버튼을 넣는다
2026-09-25 chore: 쓰지 않는 ESP32-C3 펌웨어를 저장소에서 뺀다
2026-09-25 feat: 저장된 주행을 같은 8000번 /grafana 에서 보게 한다
2026-09-25 fix: Grafana 배포 때 서버에 Docker가 없으면 설치한다
2026-09-25 fix: Grafana 이미지를 받기 전에 서버 디스크를 비운다
2026-09-25 fix: 남은 디스크가 1.4GB 이상이면 Grafana 이미지를 받는다
2026-09-25 fix: Grafana 앞단이 FastAPI에 닿게 하고, 실패하면 8000번을 다시 연다
2026-09-25 fix: 받아 둔 Grafana 이미지가 있으면 디스크가 적어도 켠다
2026-09-25 fix: Grafana 로그인을 railtwin 으로 맞춘다
2026-09-25 fix: 지난 주행은 새 브라우저 탭에서 연다
2026-09-25 feat: 대시보드에 위치 리셋 버튼을 넣는다
2026-09-25 fix: 지난 주행을 시작 시각으로 구분한다
    16진 boot_id는 조회 값으로 두고, 목록에는 서울 시각을 보여 준다.
2026-09-25 fix: 지난 주행 그래프가 시각 이름이 아니라 기록 번호로 데이터를 찾는다
2026-09-26 feat: 기울기는 자이로로 계산하고 칩 온도는 DB에만 저장한다
    좌우 높이차의 기울기를 가속도 각도 대신 자이로 적분으로 맞추고, 온도는 화면 없이 Influx에 남긴다.
2026-09-26 feat: 한 주행의 센서 기록을 마이크로초 CSV 한 파일로 받는다
2026-09-26 feat: WebGL 레일을 60 cm 각파이프 5개, 총 300 cm로 보여 준다
    이음만 구분하고, 대시보드 위치는 그 300 cm 레일 시작에서 cm로 놓는다.
2026-09-27 feat: 조립 실물 S3 펌웨어를 올리고 취소된 초기 스케치는 뺀다
    보드에 쓰는 esp32_s3_rail_node를 저장소에 두고, ADXL345 초기 스케치와 그에 남은 경로를 지운다. 로컬에만 있던 문서와 Grafana 대시보드도 함께 맞춘다.
2026-09-27 docs: README 상단을 현재 4단계 개발 로드맵으로 바꾼다
    예전 아키텍처 그림은 RBF·Godot 기준이라, 규칙 판정과 Unity 레일 기준으로 만든 그림을 맨 위에 둔다.
2026-09-27 feat: 주행 CSV 파일 이름에 실험 이름과 시각, 전원 번호를 넣는다
2026-09-27 fix: 실험 주행의 크레인 위치 막대를 300cm 레일 기준으로 맞춘다
2026-09-27 fix: 구동바퀴 접점을 300 cm 레일에 맞추고 BOOT 주행을 242 cm에서 멈춘다
    엔코더 0은 레일 58 cm이고 242 cm를 구르면 끝이다. 화면은 그 접점을 그리고, BOOT는 왼쪽 엔코더 242 cm 또는 72초에 정지한다.
    [config.h, esp32_s3_rail_node.ino]
2026-09-28 feat: 실험 중 판정 코드 배포는 FastAPI만 재시작하게 한다
    Grafana를 매번 다시 설치하면 주행 화면이 끊기므로, 로직 push는 서버의 fastapi.service만 다시 띄운다.
2026-09-28 feat: WebGL 레일을 60 cm 각파이프 3개, 총 180 cm로 줄인다
    엔코더 0은 접점 58 cm이고, 122 cm를 구르면 레일 끝이다.
2026-09-29 feat: 실측 주행 파형 적합으로 결함을 판정하고 대시보드에 대처 지침을 표시한다.
    9월 28일 실측으로 기준선을 잡고 ISO 1급 한계선을 쓰며, 함께 있던 문서·펌웨어 수정도 포함한다.
    [9월 28일 12차 실험(좌우높이차 1차)-20260928-214708-dccd50fe.csv, 9월 28일 12차 실험(좌우높이차 1차)-20260928-214708-dccd50fe_보정.csv, 9월 28일 13차 실험-20260928-214916-b5eb6b8b.csv, 9월 28일 13차 실험-20260928-214916-b5eb6b8b_보정.csv, 9월 28일 14차 실험-20260928-215244-063744b3.csv, 9월 28일 14차 실험-20260928-215244-063744b3_보정.csv, 9월 28일 15차 실험-20260928-215507-41d8b32a.csv, 9월 28일 15차 실험-20260928-215507-41d8b32a_보정.csv]
2026-09-29 fix: WebGL 대차의 구동 모터가 화면 오른쪽을 보게 돌린다
    엔코더 위치 기준은 그대로 두고, 메시만 Y축 180도로 맞춘다.
2026-11-07 feat: 판정 엔진 v2·AI 크기 추정·좌표 통일·가상 주행 재생 (배용진 fork f8cda2b에서 서버 코드만)
    배용진 fork(dydwls315-ops/HP028_RailTwin) 커밋 f8cda2b 중 서버 실행에 필요한 파일만 가져온다.
    연구 폴더 virtual_validation/(가상 모형·학습 코드·결과·PDF)는 서버 저장소에 넣지 않고 fork에 둔다.
    - rail_ai.py, rail_ai_weights.npz: numpy 1D CNN 5개 앙상블(단차·처짐 크기), 센서 어긋남 검사
    - rail_judge_v2.py: 판정 엔진 v2 (RAIL_JUDGE=v2, RAIL_AI=1로 켬. 기본 꺼짐)
    - rail_defect.py, main.py, pass_analysis.py, frontend/index.html: 센서 기준 레일 좌표(rail_x_mm),
    주행 분석 결과로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
2026-11-07 fix: AI 판정 통합 보완 — 레일 180 cm, 더미 위치, 재생 엔진 분리, 판정 방식 표시
    배용진 판정 엔진 v2·AI 통합(앞 커밋) 위에 서버 운영에 필요한 것을 보완한다.
    결정(2026-11-07, AI 개발 PM 배준호): v1 → v2 → v2+AI 단계적으로 켜고, 기본은 v1·AI 꺼짐.
    - 레일 기본값 180 cm / 36구간(50 mm): main.py, .env.example, docker-compose
    - RAIL_ENCODER_ZERO_MM 기본 40 (출발 시 센서 289 mm, 9/28 실측 역산). 첫 주행 분석 뒤에는 이음부 기준 자동 보정
    - 더미(시연) 샘플은 rail_x_mm 오프셋을 더하지 않는다 (결함이 25 cm 밀리던 문제)
    - RAIL_MOTION_FROM_PASS: 주행 분석 결과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
2026-11-07 feat: 펌웨어에 좌·우 바퀴 동기화를 다시 넣고 하드웨어 위치 기준을 문서에 적는다
    PR #27에서 옮긴다(좌표 수정과 Unity 변경은 빼고, 배용진 좌표 방식에 맞춰 문서를 고침).
    - 0.6.8-draft: 간 거리 차(mm) × SYNC_KP(2.0)로 빠른 쪽 듀티를 빼고 느린 쪽에 더한다. 인수인계서(9/24)
    "같은 PWM에서 좌 약 13% 빠름 → syncDrive 유지"를 실물 펌웨어에 다시 넣음. 시리얼 r 줄에 보정값
    - hardware-configuration-history: 위치 기준 절(실측 역산 289 mm, GLB 계산 334 mm, 엔코더 배율 0.84~0.99,
    RAIL_ENCODER_ZERO_MM 정하는 법), 지난 펌웨어 설명 정리
    - hardware-digital-twin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
2026-11-07 feat: 주행 실험 재생 보고서 스크립트와 2 mm 단차 실험 체크리스트
    - scripts/experiment_report.py: 실험 폴더(1. 정상, 2. 단차 ...)의 CSV 를 판정 v1 · v2 · v2+AI 로 각각 재생해
    재생_보고서.md 를 만든다. 정상 앞 N회는 기준선, 나머지는 오경보 확인. 서버·운영 기준선과 무관.
    주행마다 좌·우 엔코더 차, 이음부로 역산한 엔코더 배율과 출발 시 센서 위치(→ RAIL_ENCODER_ZERO_MM)도 낸다
    - docs/실험_체크리스트_2mm단차.md: 서버·펌웨어 준비, 매 회 절차(리셋 → 위치 리셋 → BOOT), 정상 9회(기준선 3 + 확인 6),
    2 mm 단차 6회, 데이터 정리, 재생 분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
2026-11-07 docs: 실험 체크리스트 합격 기준을 정상 확인 6회로 맞춘다
    Claude-Session: https://claude.ai/code/session_01UtRKDqVoXdpRc3cPUwpuxE
2026-11-07 fix: 다른 날의 12차 주행을 잘라내지 않고, 실험 체크리스트를 오늘 레일 모양에 맞춘다
    - replay_csv.load_rows: "12차" 가 이름에 있으면 앞부분을 잘라내던 9/28 전용 처리를 "9월 28일 12차" 파일에만 적용.
    그대로면 오늘(11/7) 12차 주행이 통째로 버려진다. 9/28 재생 18/18 유지
    - 실험 체크리스트: 단차는 두 번째 이음부(120 cm)에서 다음 파이프가 2 mm 낮아지는 모양. 정답 위치 120 cm(110~130).
    배용진 가상 모형으로 오늘 모양을 미리 재생: v1 은 단차 2~4/6(크기 약 1.0 mm로 절반), v2 · v2+AI 는 6/6 위험.
    오늘 서버 판정(v1/v2)은 PM 결정 칸으로 둔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
2026-11-07 docs: 실험 체크리스트에 오늘 펌웨어 0.6.8 업로드 결정을 적는다
    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
2026-11-07 feat: 미리 감속·정지를 서버 재시작 없이 켜고 끄는 API, 실험 판정을 v2로
    결정(PM, 11/7): 오늘 실험 서버 판정은 v2, AI 끔. 레일 모양(120 cm 이음부 한 곳 2 mm 내려감)을 v1 이 못 맞춰서다.
    - POST /api/motion_from_pass {"enabled": bool}: 주행 분석 결과로 감속·정지(앞 2구간)를 켜고 끈다.
    엔진 속성이라 재시작 없이 바뀌고 3회 평균 기록이 유지된다. 헬스체크 judge.motion_from_pass 에 반영
    - 실험 체크리스트: 데이터 수집 중에는 끄고(대차가 이음부 앞에서 멈추지 않게), 마지막 1회 켜서 정지 확인
    - 9/28 단차 데이터로 확인: 끄면 4회째도 끝까지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
2026-11-07 fix: .env 를 프로젝트 모듈 import 전에 읽어 RAIL_JUDGE 가 반영되게 한다 (#29)
    rail_defect·rail_judge_v2 는 import 할 때 RAIL_JUDGE, RAIL_ENCODER_ZERO_MM,
    RAIL_MOTION_FROM_PASS, RAIL_AI 를 읽는데 load_dotenv() 가 그 뒤에 있어서
    서버 .env 의 값이 무시되고 기본값(v1)이 쓰였다.
